Sunwood-ai-labs/NEKOMO/docs/design-change-records.md

# 設計データをリビジョン単位で残す

設計データは `designs/<開発コードネーム>/` の直下に `r00/`、`r01/`、`r02/` のようにリビジョンごとのフォルダで保存する。同じ開発コードネームのリビジョンは共通の親フォルダにまとめる。修正前は前のリビジョン、修正後は新しいリビジョンとして残す。変更時は前の版を上書きせず、新しい版を作る。失敗案や不採用案も保持する。

## フォルダ構成

```text
designs/<開発コードネーム>/
  README.md              リビジョン一覧と現在の採用版
  r00/
    README.md            初版の要求・設計意図・結果
    cad/                 編集可能なCAD
    source/              生成スクリプトとパラメータ
    exports/             STEP・STL
    print/               スライス設定と実G-code入り3MF
    evidence/            画像・断面・解析・検証・実物の記録
    manifest.csv         この版のファイル一覧とSHA-256
  r01/
    README.md            r00で何が起き、なぜ、何を変えたか
    cad/
    source/
    exports/
    print/
    evidence/
    manifest.csv
  r02/
    ...
```

未生成の出力や未実施の検証は、READMEに未生成・未実施と記録する。既存の `candidate-r00/` などリビジョンを表すフォルダは、その名前を維持してよい。既存の版やDR記録を一括で移動・改名せず、開発コードネームのREADMEに各版の所在と前後関係を記録する。新しく作るリビジョンは開発コードネームのフォルダ直下に置く。

## 修正するときの手順

1. 修正元のリビジョンを確定し、CAD・生成条件・関連データが保存されていることを確認する。元データが欠けていれば欠落を記録する。
2. 次の番号のリビジョンフォルダを作り、必要な元データをコピーして新しい版で修正する。前のリビジョンは上書き・削除しない。
3. 新しい版のCAD・生成条件・書き出し・スライスデータを同じリビジョンに保存する。前版の出力を流用した場合は、その版と出典を明記する。
4. 新しい版のREADMEに、発端、変更理由、前版との差分、確認結果、残った問題を記録する。比較画像は前版と同じ視点・縮尺で保存し、比較条件の違いも記す。
5. 保存ファイルの相対パス・リビジョン・SHA-256を `manifest.csv` に記録し、設計のREADMEに新しい版を追記する。参照先と実ファイルを確認してから完了を報告する。

Git履歴に加えて、フォルダから各版のデータと経緯をたどれる状態を保つ。ローカル保存とGitで追跡・共有できる範囲は区別する。外部保存なら取得可能な保存先・版・ハッシュを記録する。再生成した過去版は、再生成日時と条件を明記し、当時保存した実データと区別する。

## 各リビジョンのREADMEのひな形

```markdown
# <開発コードネーム> r01

- 作成日時・記録者:
- 元リビジョンと相対パス:
- 状態（採用・不採用・保留）:
- 関連する要求・不具合・DR記録:

## 何が起きたか

観察した問題、利用者の指摘、要求の変更と、その根拠を記す。
原因は確認済みの事実と仮説を分ける。初版では要求と設計意図を記す。

## なぜ、何を変えたか

修正の目的、この方法を選んだ理由、不採用案を記す。

| 部位・項目 | 前版の値・形状 | この版の値・形状 | 変更理由 | 比較画像・根拠 |
| --- | --- | --- | --- | --- |
| <項目> | <単位を含む> | <単位を含む> | <理由> | <相対パス> |

## この版のデータ

- CAD・生成スクリプト・パラメータ:
- 書き出し・スライス設定・実G-code入り3MF:
- ファイル一覧とSHA-256（manifest.csv）:

## 確認結果と残った問題

- 実行した検証・条件・結果・証拠:
- 実物の結果と対象の印刷ファイル:
- 未生成・未実施・未確認・不合格:
- 残った問題と次の修正事項:
- 採用・不採用・保留の理由:
```

ファイル検査、解析、印刷完了、実物確認は別々に記録する。前版の結果を、新しい版でも確認済みと扱わない。
