Sunwood-ai-labs/NEKOMO/docs/brand/logo-concepts/prompts38-40.md

# ネコと帆船のロゴ案 38〜40

## 38 — Little Cat Captain / ねこ船長
意図: 左の座る猫と右の帆、共通の船体を3つの黒い形でまとめ、猫の尾を船体へつなぐ。

```text
Use case: logo-brand
Asset type: original black-and-white brand logo concept, landscape 3:2.
Primary request: create a compact, friendly but sophisticated mark that clearly combines one cat and one sailboat in one coherent symbol.
Scene/backdrop: pure white, centered composition with broad clear margins.
Subject: one compact rounded black sailboat hull; a single simple triangular black sail to the right; one small seated black cat silhouette on the left. The cat silhouette also reads as the boat's mast/cabin silhouette: tiny head with two unmistakable pointed ears, upright seated body. Its curled tail visually joins the hull. Keep the cat and sailboat instantly readable as one designed mark, not a collage. Generous white negative gaps.
Style/medium: simple flat solid-black logo shapes, vector-friendly edges, minimal original toy brand mark, no existing character or logo imitation.
Composition/framing: mark centered above the wordmark, landscape 3:2, ample white margin.
Text (verbatim), and no other visible text: line 1 exactly "NEKONEKO INDUSTRIES"; line 2 exactly "Wonder to Go", smaller than line 1. Render these two lines centered, clean and legible.
Constraints: use at most three main black forms (cat, one sail, hull). Keep the face blank: no eyes, mouth, whiskers, paws, hat, clothes. No separate mast, ropes, rigging, waves, stars, frame, badge, border, or other icons. Pure black on pure white only.
Avoid: extra words, product name, title, captions, watermark, texture, gradients, shadows, 3D, mockup, illustration scene, collage.
```

## 39 — Cat in the Sail / 帆の中のネコ
意図: 三角帆の中に白い猫頭の抜き形を置き、黒い船体と組み合わせる。

```text
Use case: logo-brand
Asset type: original black-and-white brand logo concept, landscape 3:2.
Primary request: create a sophisticated, warm original mark where a cat is immediately recognized inside the sail of a clear sailboat.
Scene/backdrop: pure white, centered composition with broad clear margins.
Subject: one large bold solid-black triangular sail with a clean white cat-head silhouette cutout inside it. The cutout has two distinct pointed ears and a rounded face contour, with no facial features. Beneath it, one broad rounded solid-black boat hull. The cat exists only as the white cutout inside the sail. Keep sail, cat-head cutout, and hull simple and instantly readable.
Style/medium: minimal flat black logo shapes, vector-friendly edges, original toy brand identity, not imitating any existing logo or character.
Composition/framing: centered mark above the wordmark, landscape 3:2, generous white margin.
Text (verbatim), and no other visible text: line 1 exactly "NEKONEKO INDUSTRIES"; line 2 exactly "Wonder to Go", smaller than line 1. Two centered, clean and legible lines.
Constraints: exactly two large black forms (sail and hull) plus one white cutout. No separate cat outside the sail. No extra mast detail, ropes, rigging, stars, waves, frame, badge, border, or other icons. Pure black on pure white only.
Avoid: extra words, product name, title, captions, watermark, texture, gradients, shadows, 3D, mockup, illustration scene, collage.
```

## 40 — Twin Cat Sails / ふたりのネコの帆
意図: 対面する猫の横顔を左右2枚の帆に見立て、1隻の浅い船体を共有する。

```text
Use case: logo-brand
Asset type: original black-and-white brand logo concept, landscape 3:2.
Primary request: create a minimal sailboat-first mark with two paired cats whose silhouettes also read as two sails, all as one coherent symbol.
Scene/backdrop: pure white, centered composition with broad clear margins.
Subject: one shared shallow, smoothly rounded solid-black boat hull below two simple solid-black cat side-profile silhouettes facing each other. Each cat's broad curved body forms one sail rising from the hull; pointy ears define each upper tip and a subtle profile nose helps each read as a cat. Keep the two profiles balanced around a clear central white gap, and make the sailboat read first, paired cats second. Long curved tails may connect to the hull only if they remain uncluttered.
Style/medium: minimal, friendly, original toy-brand logo, flat solid black shapes with vector-friendly edges, no existing character or logo imitation.
Composition/framing: centered symbol above the wordmark, landscape 3:2, generous white margins.
Text (verbatim), and no other visible text: line 1 exactly "NEKONEKO INDUSTRIES"; line 2 exactly "Wonder to Go", smaller than line 1. Two centered, clean and legible lines.
Constraints: use three main black shapes only: two cat-profile sail shapes and one shared hull. No facial features, eyes, whiskers, paws, ropes, rigging, waves, enclosure, badge, star, or other icons. Pure black on pure white.
Avoid: extra words, product name, title, captions, watermark, texture, gradients, shadows, 3D, mockup, illustration scene, stamp, collage.
```

生成画像の文字確認: 3案とも文字は2行で余分な行はありません。画像の Wonder to Go は末尾の句点が見えないため、生成時の表記差として記録します。
