Sunwood-ai-labs/NEKOMO/docs/brand/logo-concepts/prompts28-30.md

# ロゴ案28〜30

生成方法: 内蔵の画像生成ツールで各案を個別に生成。参照画像は使用していない。

共通意図: NEKONEKO INDUSTRIESが作る、携帯できる子ども向け玩具NEKOMOのロゴ案。車、船、飛行機の3種類を各案の中でそれぞれ認識できるようにする。黒と白だけを使った、簡潔なロゴを提案する。

共通表記: 会社名は `NEKONEKO INDUSTRIES`、ミッションは `Wonder to Go.` と正確に記す。マークを主役にし、会社名をその下、ミッションをさらに小さく配置する。白地の横3:2、広い余白、フラットなロゴ表現。

## 28 Three Windows / みっつの窓

意図: 横長のひとつの黒いタイルに3つの車両を白抜きし、車・船・飛行機を並列に見せる。

最終プロンプト:

```text
Use case: logo-brand
Asset type: original company logo concept, vector-friendly
Primary request: Create concept 28, "Three Windows." Make one compact horizontal solid-black rounded rectangle the only emblem. Divide it into exactly three adjoining panels using exactly two broad white vertical gaps. Carve one bold, simple white vehicle silhouette from each panel: a side-view car with two clearly visible wheels in the left panel, a small boat with a distinct hull and one attached triangular sail in the center panel, and a clearly recognizable airplane with a fuselage, broad wings, and tail in the right panel. Keep the three icons separate, equal in optical weight, and readable at small size. Treat the white cutouts as a playful, sturdy stencil mark, not as interface buttons.
Brand context: NEKONEKO INDUSTRIES makes NEKOMO, portable toys for children. Its mission line is "Wonder to Go." The mark must make car, boat, and airplane recognizable.
Composition: White landscape canvas, 3:2 aspect ratio, generous clear margins. Center the single three-panel black emblem above the exact company name "NEKONEKO INDUSTRIES" in restrained uppercase sans-serif. Put the exact tagline "Wonder to Go." below it in smaller type.
Color and style: Pure solid black #000000 and white #FFFFFF only. Flat professional logo artwork with clean vector-like edges and broad, simple forms.
Constraints: The emblem contains only the one rounded black tile, two broad white dividing gaps, and three white vehicle cutouts. No panel borders, shadows, tiny details, windows, rigging, portholes, waves, extra symbols, or decoration. No additional text, misspellings, color, gradient, texture, 3D, mockup, or watermark. Do not imitate an existing brand.
```

## 29 Play Triangle / 遊びのトライアングル

意図: 枠で囲わず、上の飛行機と下の車・帆船を三角形の配置にまとめる。

最終プロンプト:

```text
Use case: logo-brand
Asset type: original company logo concept, vector-friendly
Primary request: Create concept 29, "Play Triangle." Arrange three simple solid-black vehicle silhouettes in a compact, optically balanced triangular composition with no enclosing triangle: a horizontal airplane at the top with clearly readable fuselage, broad wings, and tail; a rounded side-view car at bottom left with two clearly visible wheels; and a small sailboat at bottom right with a distinct hull and one triangular sail. Leave generous white space between the vehicles so each silhouette remains distinct. Give all three the same playful geometric construction and visual weight so they form one original toy-brand family emblem, not a collage.
Brand context: NEKONEKO INDUSTRIES makes NEKOMO, portable toys for children. Its mission line is "Wonder to Go." The mark must make car, boat, and airplane recognizable.
Composition: White landscape canvas, 3:2 aspect ratio, generous clear margins. Center the unframed three-vehicle mark above the exact company name "NEKONEKO INDUSTRIES" in restrained uppercase sans-serif. Put the exact tagline "Wonder to Go." below it in smaller type.
Color and style: Pure solid black #000000 and white #FFFFFF only. Flat professional logo artwork with clean vector-like edges, broad forms, and clear recognition at small sizes.
Constraints: No enclosing triangle, star, arrow, route, circle, frame, outline, or decoration. No tiny windows, rigging, portholes, waves, or extra details. No additional text, misspellings, color, gradient, shadow, texture, 3D, mockup, or watermark. Do not imitate an existing brand.
```

## 30 One Journey / ひと続きの旅

意図: 太い一本線で車から帆船、飛行機へつなぎ、3つの輪郭をひとつのマークにする。

最終プロンプト:

```text
Use case: logo-brand
Asset type: original company logo concept, vector-friendly
Primary request: Create concept 30, "One Journey." Draw one compact horizontal emblem as a single continuous, bold black monoline that smoothly links three distinct, recognizable vehicle profiles from left to right: a side-view car with two round wheels, a boat with a clearly shaped hull and one attached triangular sail, then an airplane with a readable fuselage, broad wing, and tail, rising slightly toward the right. Let the continuous outline connect the vehicles without turning into a route map; preserve open white space and make the boundaries between car, boat, and airplane unmistakable. Use one consistent thick rounded stroke and only the essential contours, with fewer than ten major strokes or loops.
Brand context: NEKONEKO INDUSTRIES makes NEKOMO, portable toys for children. Its mission line is "Wonder to Go." The mark must make car, boat, and airplane recognizable.
Composition: White landscape canvas, 3:2 aspect ratio, generous clear margins. Center the connected black monoline emblem above the exact company name "NEKONEKO INDUSTRIES" in restrained uppercase sans-serif. Put the exact tagline "Wonder to Go." below it in smaller type.
Color and style: Pure solid black #000000 and white #FFFFFF only. Flat professional logo artwork with clean vector-like edges, balanced proportions, and generous white space.
Constraints: No decorative trails, arrows, stars, dashed lines, extra loops beyond the two necessary car wheels, tiny windows, rigging, portholes, waves, enclosure, or extra details. Keep each vehicle's contour distinct; do not let the airplane read as a sail or the car lose its two wheels. No additional text, misspellings, color, gradient, shadow, texture, 3D, mockup, or watermark. Do not imitate an existing brand.
```
