Sunwood-ai-labs/NEKOMO/docs/brand/logo-concepts/prompts16-17.md

# ロゴ案16〜17の生成プロンプト

各案を独立してbuilt-in image_genで生成。

## 16. Escape Dot / 抜けだす丸

狙い: 小さな驚きが輪の外へ抜け、どこへでも持ち歩ける印象を、輪と点だけで表す。
色: 黒一色、純白背景。

Use case: logo-brand  
Asset type: original minimalist logo proposal, landscape 3:2  
Primary request: Design a bespoke, tiny-size-readable mark made of exactly two elements: one thick, asymmetric open squircle loop, slightly flattened at the left and bottom, with one small diagonal gap at the upper right; and one detached solid round dot just beyond that gap.  
Composition: Center the large mark with generous white margin. Below it, set exactly “NEKONEKO INDUSTRIES” in a restrained sans serif and the smaller exact line “Wonder to Go.”  
Color palette: Flat black on pure white only.  
Avoid: Extra shapes or words, arrow, star, cat, speed lines, location pin, power button, loading-spinner or letter-C appearance, mockup, 3D, shadows, gradients, texture, watermark.

## 17. Skipping Ears / 跳ねる耳

狙い: 跳ねるような遊び心を、短く幅のある猫耳風の二片と、その間の白い切れ込みで表す。
色: 黒一色、純白背景。

Use case: logo-brand  
Asset type: original minimalist logo proposal, landscape 3:2  
Primary request: Design a compact, asymmetrical, custom mark made of exactly two short, broad, rounded triangular black wedges suggesting feline ears. Lift and lean one wedge slightly forward; shape the white notch between them to imply a playful skip. Keep the silhouette soft, precise, and clear at tiny sizes.  
Composition: Center the large mark with generous white margin. Below it, set exactly “NEKONEKO INDUSTRIES” in a restrained sans serif and the smaller exact line “Wonder to Go.”  
Color palette: Flat black on pure white only.  
Avoid: Extra shapes or words, face, eyes, body, tail, long bunny ears, letter, enclosing circle or shield, full mascot, generic chevron, tiny decoration, mockup, 3D, shadows, gradients, texture, watermark.
