Sunwood-ai-labs/NEKOMO/docs/brand/logo-concepts/prompts23-25.md

# 23〜25 船モチーフのロゴ案

生成方法: 内蔵の画像生成ツールで各案を個別に生成。参照画像は使用していない。

共通意図: NEKONEKO INDUSTRIESが作る「どこへでも持ち歩ける子ども向け玩具」を、見てすぐ船と分かる白黒の簡潔な記号で表す。

共通仕様: 横3:2、余白のある白地、黒いマーク、社名 `NEKONEKO INDUSTRIES`、タグライン `Wonder to Go.`。フラットな白黒表現。以前の抽象案16〜20は保留中で、削除していない。

## 23 Little Tug / 小さなタグボート

意図: 丸みのある船体、船室、丸窓だけで、玩具のタグボートを一目で伝える。

最終プロンプト:

```text
Use case: logo-brand
Asset type: original company logo concept, vector-friendly
Primary request: Create concept 23, "Little Tug." Make the central mark an instantly recognizable, squat, chunky toy tugboat in side profile, facing right. Use one broad, gently upturned rounded hull and one simple rounded-rectangle cabin sitting clearly on top of the hull. The cabin has exactly one circular white porthole cutout. Keep the silhouette compact and playful, like a small physical toyboat, not a shipyard emblem.
Brand context: NEKONEKO INDUSTRIES makes portable children's toys. Its mission line is "Wonder to Go." The mark should feel friendly and practical for a toy brand.
Composition: White landscape canvas, 3:2 aspect ratio, generous clear margins. Center one black boat icon above the exact company name "NEKONEKO INDUSTRIES" in restrained uppercase sans-serif. Put the exact tagline "Wonder to Go." below it in smaller type. Keep the icon and text aligned and crisp.
Color and style: Pure solid black #000000 and white #FFFFFF only. Flat professional logo artwork with clean vector-like edges, broad simple forms, strong recognition at small sizes.
Constraints: The icon uses only the hull, cabin, and one white porthole cutout; no more than three large black shapes. No smokestack, smoke, rope, anchor, rigging, face, star, waves, border, or extra details. No additional text, no misspellings, no color, gradient, shadow, texture, 3D, mockup, or watermark. Do not imitate an existing brand.
```

## 24 Wave Sail / 波と帆

意図: 三角帆と、船底から波へつながる一本の曲線だけで、船と進む動きを表す。

最終プロンプト:

```text
Use case: logo-brand
Asset type: original company logo concept, vector-friendly
Primary request: Create concept 24, "Wave Sail." Make the central mark immediately readable as a small sailboat in profile. Use exactly two visual elements: (1) one simple solid triangular sail above the boat and (2) one single bold, smooth, continuous curved black band below it. Shape the band's contour so it clearly forms a shallow boat hull with a gently lifted bow while flowing into one low waterwave; the band must read first as the boat-and-wave base of a sailboat, not as a random swoosh. Keep the sail visibly attached to and rising from the hull area.
Brand context: NEKONEKO INDUSTRIES makes portable children's toys. Its mission line is "Wonder to Go." Give the mark a light feeling of forward motion suitable for a toy brand.
Composition: White landscape canvas, 3:2 aspect ratio, generous clear margins. Center one black sailboat icon above the exact company name "NEKONEKO INDUSTRIES" in restrained uppercase sans-serif. Put the exact tagline "Wonder to Go." below it in smaller type. Keep the icon and text aligned and crisp.
Color and style: Pure solid black #000000 and white #FFFFFF only. Flat professional logo artwork with clean vector-like edges, broad balanced geometry, strong recognition at small sizes.
Constraints: The icon contains only the single triangle and the one continuous curved boat-hull/wave band. No separate wave line, second sail, cat, face, star, anchor, enclosure, decoration, or extra details. No additional text, no misspellings, no color, gradient, shadow, texture, 3D, mockup, or watermark. Do not imitate an existing brand.
```

## 25 Anywhere Boat / 車輪付きの遊び舟

意図: 帆のある小舟を二つの車輪に載せ、陸と水の両方へ進む玩具の記号にする。

最終プロンプト:

```text
Use case: logo-brand
Asset type: original company logo concept, vector-friendly
Primary request: Create concept 25, "Anywhere Boat." Design one unified imaginative toy vehicle that reads immediately as a small boat riding on two large round wheels. Use exactly four main black forms: one broad rounded boat hull, one small simple triangular sail rising from the hull, and two large circular wheels beneath the hull. Show the hull clearly above the wheels, with clean white gaps so the boat and both wheels remain distinct at small size. Keep the proportions compact and playful, like an invented toy symbol for wonder that travels on land and water.
Brand context: NEKONEKO INDUSTRIES makes portable children's toys. Its mission line is "Wonder to Go." The mark combines boat and car in one coherent toy icon.
Composition: White landscape canvas, 3:2 aspect ratio, generous clear margins. Center one black boat-on-wheels icon above the exact company name "NEKONEKO INDUSTRIES" in restrained uppercase sans-serif. Put the exact tagline "Wonder to Go." below it in smaller type. Keep the icon and text aligned and crisp.
Color and style: Pure solid black #000000 and white #FFFFFF only. Flat professional logo artwork with clean vector-like edges, broad rounded forms, strong recognition at small sizes.
Constraints: One cohesive vehicle only: hull, one triangular sail, two wheels. No separate collage, face, stars, waves, arrow, enclosure, engine, ropes, anchor, or other details. No additional text, no misspellings, no color, gradient, shadow, texture, 3D, mockup, or watermark. Do not imply this is an existing manufactured product and do not imitate an existing brand.
```
