Sunwood-ai-labs/NEKOMO/docs/designs/school-bus-v02/版の案内.md

# v02の案内

大型・車体／シャーシ／屋根の3部品

記録の確認日: 2026-11-10。未印刷。実組立・保持力・支持材除去は未確認。

全版の一覧（ローカル保存）

## CADと印刷データ

- [cad/nekomo-school-bus-v02.FCStd](../../../designs/school-bus-v02/cad/nekomo-school-bus-v02.FCStd)
- [print/final-body-sliced.3mf](../../../designs/school-bus-v02/print/final-body-sliced.3mf)
- [print/final-chassis-sliced.3mf](../../../designs/school-bus-v02/print/final-chassis-sliced.3mf)
- [print/final-roof-sliced.3mf](../../../designs/school-bus-v02/print/final-roof-sliced.3mf)

## 人間のレビュー・判断

本人発言と出典の記録（ローカル保存）

- 設計フィードバック。使用できる色を赤白へ訂正。対象・反映先はv02 → v03。根拠はR03。
- 設計フィードバック。サンプル船程度への小型化を提案。対象・反映先はv02 → v03。根拠はR04。

### 前の案への指摘・設計条件の引継ぎ

次の発言を設計入力として保存しています。この版の完成形へのレビュー・承認とは区別します。

- R01。参照写真との外観差を指摘。対象・反映先はv01 → v02。
- R02。参考の設計案を提示。対象・反映先はv02設計条件。

完成品の品質に対する人間のレビューはなしです。

## エージェントのレビュー・検証記録

CAD・組立形状とスライス後の確認。段階別の正式なDR判定表は主要資料で確認できない。

### v02・大型3部品

| DR段階 | 星取 | 元の判定 |
| --- | :---: | --- |
| DR0 要求 | なし | なし |
| DR1 設計 | なし | なし |
| DR2 工程 | なし | なし |
| DR3 現物試験 | なし | なし |
| DR4 使用判定 | なし | なし |

実施した検査は次のとおりです。

- 車体・シャーシ・屋根の形状、干渉と位置決めを確認。
- 各部品の姿勢・支持材・スライスを比較し、保存した印刷ファイルを検査。
- 固定輪まわりの支持材除去を現物の確認課題として記録。

### 関連する検証・実機記録

- [README.md](README.md)
- assembly-and-fit.md（ローカル保存）
- [evidence/after-slice-review.md](evidence/after-slice-review.md)

## 配布物

- 当時の配布ZIP（ローカル保存）

配布ZIPは整理前の内容を保持しています。ZIP内のhandoffやハッシュは、その配布時点のファイルに対応します。

## 保存場所の扱い

このフォルダがこの版の保存場所です。旧候補、失敗記録、DR前後の証跡は元の場所に残しています。
案内にある印刷データには未印刷のものも含まれます。データ審査と現物試験の結果は各記録で区別しています。
