Sunwood-ai-labs/NEKOMO/docs/designs/school-bus-v03-mini/版の案内.md

# v03の案内

60mm級・赤白の3部品

記録の確認日: 2026-11-10。未印刷。DR0・DR1は一部実施、DR2はデータ確認、DR3・DR4は未実施。

全版の一覧（ローカル保存）

## CADと印刷データ

- [cad/nekomo-school-bus-v03.FCStd](../../../designs/school-bus-v03-mini/cad/nekomo-school-bus-v03.FCStd)
- [print/final-body-sliced.3mf](../../../designs/school-bus-v03-mini/print/final-body-sliced.3mf)
- [print/final-chassis-sliced.3mf](../../../designs/school-bus-v03-mini/print/final-chassis-sliced.3mf)
- [print/final-roof-sliced.3mf](../../../designs/school-bus-v03-mini/print/final-roof-sliced.3mf)

## 人間のレビュー・判断

本人発言と出典の記録（ローカル保存）

- 設計への肯定的反応・工程確認。v03提示への肯定的反応と工程確認。対象・反映先はv03提示の直後。根拠はR11。

### 前の案への指摘・設計条件の引継ぎ

次の発言を設計入力として保存しています。この版の完成形へのレビュー・承認とは区別します。

- R03。使用できる色を赤白へ訂正。対象・反映先はv02 → v03。
- R04。サンプル船程度への小型化を提案。対象・反映先はv02 → v03。

### エージェントへの作業依頼

本人がDRを実施したという意味ではありません。

- Q04。DR実施依頼。

完成品の品質に対する人間のレビューはなしです。

## エージェントのレビュー・検証記録

DR0・DR1は一部実施、DR2はデータ上の確認。DR0〜2の完了・合格判定はなく、DR3・DR4は未実施。

### v03・60mm組立

| DR段階 | 星取 | 元の判定 |
| --- | :---: | --- |
| DR0 要求 | △ | 一部 |
| DR1 設計 | △ | 一部 |
| DR2 工程 | △ | データ確認 |
| DR3 現物試験 | なし | なし |
| DR4 使用判定 | なし | なし |

実施した検査は次のとおりです。

- 赤白・60mm・固定輪の要求を反映。外観と位置決め部の肉厚を調整。
- 3部品の再読込・干渉、STEPとSTLの形状を確認。
- 支持材と材料割当、スライスとG-codeを確認。DR0〜2の完了・合格判定はなし。

### 関連する検証・実機記録

- [README.md](README.md)
- dr-status.md（ローカル保存）
- assembly-and-fit.md（ローカル保存）
- [evidence/after-slice-review.md](evidence/after-slice-review.md)

## 配布物

- 当時の配布ZIP（ローカル保存）

配布ZIPは整理前の内容を保持しています。ZIP内のhandoffやハッシュは、その配布時点のファイルに対応します。

## 保存場所の扱い

このフォルダがこの版の保存場所です。旧候補、失敗記録、DR前後の証跡は元の場所に残しています。
案内にある印刷データには未印刷のものも含まれます。データ審査と現物試験の結果は各記録で区別しています。
