Sunwood-ai-labs/NEKOMO/docs/designs/school-bus-v04-dr/版の案内.md

# v04の案内

60mm級・幅34mm・赤白一体構造

記録の確認日: 2026-11-10。未印刷。DR0を審査、DR1・DR2は条件付き。DR3・DR4は未実施。整理前からCADと再読込記録のハッシュが一致せず、再梱包は停止。

全版の一覧（ローカル保存）

## CADと印刷データ

- [cad/nekomo-school-bus-v04.FCStd](../../../designs/school-bus-v04-dr/cad/nekomo-school-bus-v04.FCStd)
- [print/final-bus-sliced.3mf](../../../designs/school-bus-v04-dr/print/final-bus-sliced.3mf)

## 人間のレビュー・判断

本人発言と出典の記録（ローカル保存）

- 設計フィードバック。製造可能性と内部空間を質問。対象・反映先はv04 → 未確認。根拠はR05。

完成品の品質に対する人間のレビューはなしです。

## エージェントのレビュー・検証記録

DR0の要求・試験計画を確認。DR1・DR2は成人評価用試作に限る条件付き判定。DR3・DR4は未実施。既存のCADハッシュ不一致も残る。

### v04・60mm一体

| DR段階 | 星取 | 元の判定 |
| --- | :---: | --- |
| DR0 要求 | ○ | 審査済み |
| DR1 設計 | △ | 条件付き |
| DR2 工程 | △ | 条件付き |
| DR3 現物試験 | なし | なし |
| DR4 使用判定 | なし | なし |

実施した検査は次のとおりです。

- 要求仕様、設計FMEA16項目、工程FMEA12項目、試験計画を整理・審査。
- 別体の屋根・底板を一体化し、幅と補強部を見直す。CAD・メッシュ・色領域を確認。
- 材料割当・支持材除去計画・スライスと出力経路を確認。
- 整理時の再照合では保存CADのハッシュ不一致が残る。現在の再梱包は停止。

追加の根拠となる記録です。

- packaging-verification.json（ローカル保存）

### 関連する検証・実機記録

- [README.md](README.md)
- [quality/preprint-review/dr-review.md](quality/preprint-review/dr-review.md)
- [quality/preprint-review/requirements.md](quality/preprint-review/requirements.md)
- [quality/preprint-review/test-plan.md](quality/preprint-review/test-plan.md)
- [evidence/after-slice-review.md](evidence/after-slice-review.md)

## 配布物

- 当時の配布ZIP（ローカル保存）

配布ZIPは整理前の内容を保持しています。ZIP内のhandoffやハッシュは、その配布時点のファイルに対応します。

## 保存場所の扱い

このフォルダがこの版の保存場所です。旧候補、失敗記録、DR前後の証跡は元の場所に残しています。
案内にある印刷データには未印刷のものも含まれます。データ審査と現物試験の結果は各記録で区別しています。
