Sunwood-ai-labs/NEKOMO/docs/designs/school-bus-v06-empty-inverted/版の案内.md

# v06・60mm空洞の案内

床・座席を抜く60mm級。単色、赤屋根、赤タイヤの派生

記録の確認日: 2026-11-10。単色・赤屋根版はスライス比較まで。赤タイヤ版は本人報告で印刷済み。

全版の一覧（ローカル保存）

## CADと印刷データ

- corrected/nekomo-v06-clear-cabin.FCStd（ローカル保存）
- [print/clear-inverted-normal-support-sliced.3mf](../../../designs/school-bus-v06-empty-inverted/print/clear-inverted-normal-support-sliced.3mf)
- two-color/nekomo-v06-red-white.FCStd（ローカル保存）
- two-color/red-white-inverted-sliced.3mf（ローカル保存）
- two-color-red-tyres/nekomo-v06-red-tyres.FCStd（ローカル保存）
- two-color-red-tyres/red-tyres-inverted-sliced.3mf（ローカル保存）

## 人間のレビュー・判断

本人発言と出典の記録（ローカル保存）

- 設計フィードバック。タイヤの色違いを要望。対象・反映先はv06 → 赤タイヤ派生版。根拠はR09。
- 採用承認・印刷指示。赤タイヤ版を採用して印刷を指示。対象・反映先はv06赤タイヤ派生版。根拠はR10。

### 前の案への指摘・設計条件の引継ぎ

次の発言を設計入力として保存しています。この版の完成形へのレビュー・承認とは区別します。

- R07。床なし・空洞・逆さ印刷を提案。対象・反映先はv05 → v06。
- R08。2色を指定。対象・反映先はv05 → v06。
- R09。タイヤの色違いを要望。対象・反映先はv06 → 赤タイヤ派生版。

### 印刷実績

本人の印刷報告（ローカル保存）

- v06・赤タイヤは印刷済み。根拠は本人報告U01。

完成品の品質に対する人間のレビューはなしです。

## エージェントのレビュー・検証記録

CADと姿勢・支持材・配色のスライス比較。正式な全DRの完了記録とは区別する。赤タイヤ版のジョブ開始は機械記録で確認する。

### v06・60mm空洞

| DR段階 | 星取 | 元の判定 |
| --- | :---: | --- |
| DR0 要求 | なし | なし |
| DR1 設計 | なし | なし |
| DR2 工程 | なし | なし |
| DR3 現物試験 | なし | なし |
| DR4 使用判定 | なし | なし |

実施した検査は次のとおりです。

- 床・座席を抜いた形状と空洞を確認。
- 正立・逆さ、支持材なし・tree・normalをスライス比較。
- 赤屋根・白車体の2色案について、色替え・時間・支持材とG-codeを確認。

### v06・赤タイヤ

| DR段階 | 星取 | 元の判定 |
| --- | :---: | --- |
| DR0 要求 | なし | なし |
| DR1 設計 | なし | なし |
| DR2 工程 | なし | なし |
| DR3 現物試験 | なし | なし |
| DR4 使用判定 | なし | なし |

実施した検査は次のとおりです。

- 赤い屋根・タイヤと白い車体・ハブの色分けを確認。
- 逆さ姿勢・通常支持材のスライス、色替え40回・予測時間・材料量を確認。
- 印刷ファイル・G-codeとAMS割当を確認。印刷済みは本人報告で記録し、現物試験の合格とは区別。

### 関連する検証・実機記録

- 比較結果.md（ローカル保存）
- [evidence/after-slice-review.md](evidence/after-slice-review.md)
- [two-color-red-tyres/README.md](two-color-red-tyres/README.md)
- [two-color-red-tyres/after-slice-review.md](two-color-red-tyres/after-slice-review.md)
- two-color-red-tyres/print-run-20261110/README.md（ローカル保存）
- two-color-red-tyres/印刷実績-本人報告.json（ローカル保存）

## 保存場所の扱い

このフォルダがこの版の保存場所です。旧候補、失敗記録、DR前後の証跡は元の場所に残しています。
案内にある印刷データには未印刷のものも含まれます。データ審査と現物試験の結果は各記録で区別しています。
