Sunwood-ai-labs/NEKOMO/docs/designs/school-bus-v06-simple/版の案内.md

# v06・小型一体の案内

40×20×22mm・単色・車内空間なし

記録の確認日: 2026-11-10。未印刷。DR0〜2はデータ審査、DR3はNOT_RUN、DR4はHOLD。

全版の一覧（ローカル保存）

## CADと印刷データ

- [candidate-r01/cad/final-bus-r01.FCStd](../../../designs/school-bus-v06-simple/candidate-r01/cad/final-bus-r01.FCStd)
- [candidate-r01/print/school-bus-r01-sliced.3mf](../../../designs/school-bus-v06-simple/candidate-r01/print/school-bus-r01-sliced.3mf)

## 人間のレビュー・判断

本人発言と出典の記録（ローカル保存）

- 設計への指摘・変更要望。いや、バスをシンプルにしてってこと！。対象・反映先はv06-simple。根拠はS04。

### 前の案への指摘・設計条件の引継ぎ

次の発言を設計入力として保存しています。この版の完成形へのレビュー・承認とは区別します。

- S01。小型・簡素化と1時間以内を要望。対象・反映先はv06-simple。

完成品の品質に対する人間のレビューはなしです。

## エージェントのレビュー・検証記録

DR0〜2の要求・形状・印刷データを確認。DR3はNOT_RUN、DR4はHOLD。

### v06・40mmシンプル

| DR段階 | 星取 | 元の判定 |
| --- | :---: | --- |
| DR0 要求 | ○ | 審査済み |
| DR1 設計 | △ | データ確認 |
| DR2 工程 | △ | データ確認 |
| DR3 現物試験 | なし | なし |
| DR4 使用判定 | 保留 | 保留 |

実施した検査は次のとおりです。

- 小型・単色・一体の要求を確認し、DR前後のデータを保存。
- r00・r01のソース、CAD・STEP・STLの再読込と代表断面を確認。前面・窓位置を修正。
- 3MFの材料・設定・G-code・時間を確認。予測27分6秒、支持材・色替え・警告なし。

追加の根拠となる記録です。

- [DR1-r00-findings.md](evidence/DR1-r00-findings.md)

### 関連する検証・実機記録

- [quality/preprint-review/dr-review.md](quality/preprint-review/dr-review.md)
- [evidence/after-slice-review.md](evidence/after-slice-review.md)
- evidence/DR3-decision.md（ローカル保存）
- evidence/DR4-decision.md（ローカル保存）
- reviews（ローカル保存）

## 保存場所の扱い

このフォルダがこの版の保存場所です。旧候補、失敗記録、DR前後の証跡は元の場所に残しています。
案内にある印刷データには未印刷のものも含まれます。データ審査と現物試験の結果は各記録で区別しています。
