Sunwood-ai-labs/NEKOMO/docs/designs/school-bus-v07-open-bottom/版の案内.md

# v07の案内

40mm級・床なし空洞・赤白・立体固定輪

記録の確認日: 2026-11-10。未印刷。DR0〜2はデータ審査、DR3はNOT_RUN、DR4はHOLD。

全版の一覧（ローカル保存）

## CADと印刷データ

- [candidate-r00/cad/nekomo-bus-v07-final.FCStd](../../../designs/school-bus-v07-open-bottom/candidate-r00/cad/nekomo-bus-v07-final.FCStd)
- [candidate-r00/print/bus-two-colour-final.3mf](../../../designs/school-bus-v07-open-bottom/candidate-r00/print/bus-two-colour-final.3mf)

## 人間のレビュー・判断

本人発言と出典の記録（ローカル保存）

- 設計への指摘・変更要望。床もなしでいいよ！。対象・反映先はv07。根拠はS05。
- 設計への指摘・変更要望。上下逆にして、中身空洞にしたら？？船を参考にして！。対象・反映先はv07。根拠はS06。

### エージェントへの作業依頼

本人がDRを実施したという意味ではありません。

- S08。DRの前とあとはちゃんとデータ残してね。
- S09。これで、freecadで設計してみて！。

完成品の品質に対する人間のレビューはなしです。

## エージェントのレビュー・検証記録

DR0〜2の要求・形状・印刷データを確認。DR3はNOT_RUN、DR4はHOLD。

### v07・40mm床なし

| DR段階 | 星取 | 元の判定 |
| --- | :---: | --- |
| DR0 要求 | ○ | 審査済み |
| DR1 設計 | △ | データ確認 |
| DR2 工程 | △ | データ確認 |
| DR3 現物試験 | なし | なし |
| DR4 使用判定 | 保留 | 保留 |

実施した検査は次のとおりです。

- 床なし・中空・逆さ・2色・固定輪の要求を審査し、DR前後を保存。
- 窓の切り抜きと輪の張り出しを修正。CAD・STEP・STL、局所厚さ、色境界と空洞を確認。
- タワー位置の失敗を修正して再スライス。G-codeで空洞中央を横切る押出がないことなどを確認。予測28分41秒、色替え1回、支持材なし。

### 関連する検証・実機記録

- [README.md](README.md)
- quality/dr-review-r01.md（ローカル保存）
- quality/fmea-and-test-plan-r00.md（ローカル保存）
- [evidence/design-review-r00.md](evidence/design-review-r00.md)
- reviews（ローカル保存）

## 配布物

- 当時の配布ZIP（ローカル保存）

配布ZIPは整理前の内容を保持しています。ZIP内のhandoffやハッシュは、その配布時点のファイルに対応します。

## 保存場所の扱い

このフォルダがこの版の保存場所です。旧候補、失敗記録、DR前後の証跡は元の場所に残しています。
案内にある印刷データには未印刷のものも含まれます。データ審査と現物試験の結果は各記録で区別しています。
