Sunwood-ai-labs/NEKOMO/docs/designs/school-bus-v08-photo/版の案内.md

# v08の案内

42×21×24mm・参照写真に寄せたボンネット付き

記録の確認日: 2026-11-10。白タイヤと赤タイヤを比較。未印刷。全DRの再実施はしていない。

全版の一覧（ローカル保存）

## CADと印刷データ

- [cad/photo-bus.FCStd](../../../designs/school-bus-v08-photo/cad/photo-bus.FCStd)
- [exports/photo-two-color-sliced.3mf](../../../designs/school-bus-v08-photo/exports/photo-two-color-sliced.3mf)
- [cad/photo-bus-fast.FCStd](../../../designs/school-bus-v08-photo/cad/photo-bus-fast.FCStd)
- [exports/fast-two-color-sliced.3mf](../../../designs/school-bus-v08-photo/exports/fast-two-color-sliced.3mf)

## 人間のレビュー・判断

本人発言と出典の記録（ローカル保存）

- 設計レビューの質問。逆さ印刷とボンネットの支持材を質問。対象・反映先はv08 → v09。根拠はP02。
- 設計変更の提案と意図の訂正。ボンネット全体を滑らかな傾斜にするよう提案。対象・反映先はv08 → v09。根拠はP03。

完成品の品質に対する人間のレビューはなしです。

## エージェントのレビュー・検証記録

形状・配色・スライス・ボンネットの確認。全DRの再実施はしていない。

### v08・写真型

| DR段階 | 星取 | 元の判定 |
| --- | :---: | --- |
| DR0 要求 | なし | なし |
| DR1 設計 | なし | なし |
| DR2 工程 | なし | なし |
| DR3 現物試験 | なし | なし |
| DR4 使用判定 | なし | なし |

実施した検査は次のとおりです。

- CAD再読込、単一ソリッド、床開口、色領域の重複と欠落を確認。
- 白タイヤと赤タイヤの配色をスライス比較し、色替え・時間・材料量を確認。
- 逆さ印刷でボンネットが空中から始まる問題を確認。全DRの再実施はなし。

### 関連する検証・実機記録

- [README.md](README.md)
- evidence/bonnet-review.json（ローカル保存）

## 保存場所の扱い

このフォルダがこの版の保存場所です。旧候補、失敗記録、DR前後の証跡は元の場所に残しています。
案内にある印刷データには未印刷のものも含まれます。データ審査と現物試験の結果は各記録で区別しています。
