Sunwood-ai-labs/NEKOMO/docs/designs/school-bus-v09-sloped/版の案内.md

# v09の案内

42×21×24mm・支持材なしを狙う傾斜ボンネット

記録の確認日: 2026-11-10。実機記録はFINISH・100%・119層完了。取り外し後の仕上がりと強度は未確認。

全版の一覧（ローカル保存）

## CADと印刷データ

- [cad/sloped-bus.FCStd](../../../designs/school-bus-v09-sloped/cad/sloped-bus.FCStd)
- [cad/sloped-bus-print.FCStd](../../../designs/school-bus-v09-sloped/cad/sloped-bus-print.FCStd)
- [exports/sloped-two-color-sliced.3mf](../../../designs/school-bus-v09-sloped/exports/sloped-two-color-sliced.3mf)

## 人間のレビュー・判断

本人発言と出典の記録（ローカル保存）

- 試し刷りの指示。v09の試し刷りを指示。対象・反映先はv09-sloped。根拠はP05。

### 前の案への指摘・設計条件の引継ぎ

次の発言を設計入力として保存しています。この版の完成形へのレビュー・承認とは区別します。

- P03。ボンネット全体を滑らかな傾斜にするよう提案。対象・反映先はv08 → v09。

### エージェントへの作業依頼

本人がDRを実施したという意味ではありません。

- P04。支持材なしで成立するか検証を要求。

### 印刷実績

本人の印刷報告（ローカル保存）

- v09・傾斜ボンネットは印刷済み。根拠は本人報告U01。

完成品の品質に対する人間のレビューはなしです。

## エージェントのレビュー・検証記録

ボンネット断面とG-codeの前層との重なりを確認。選定した範囲の検証であり、印刷完了や全体の現物品質合格とは区別する。

### v09・傾斜ボンネット

| DR段階 | 星取 | 元の判定 |
| --- | :---: | --- |
| DR0 要求 | なし | なし |
| DR1 設計 | なし | なし |
| DR2 工程 | なし | なし |
| DR3 現物試験 | なし | なし |
| DR4 使用判定 | なし | なし |

実施した検査は次のとおりです。

- 傾斜ボンネットへ変更し、保存CADの再読込と床開口を確認。
- CADの層ごとの断面と、実G-codeの押出線幅を用いて前層との重なりを確認。検査範囲はボンネット中央の抽出点。
- 保存3MFの設定・警告・支持材・色替えを確認。実機のFINISH・100%・119層完了も記録。寸法・強度などの現物試験の合格記録はなし。

追加の根拠となる記録です。

- toolpath-overlap.json（ローカル保存）

### 関連する検証・実機記録

- [README.md](README.md)
- timelapse/recording.json（ローカル保存）
- evidence/completion-answer.md（ローカル保存）
- evidence/progress-final.jpg（ローカル保存）
- timelapse/timelapse.mp4（ローカル保存）

## 保存場所の扱い

このフォルダがこの版の保存場所です。旧候補、失敗記録、DR前後の証跡は元の場所に残しています。
案内にある印刷データには未印刷のものも含まれます。データ審査と現物試験の結果は各記録で区別しています。
