Sunwood-ai-labs/NEKOMO/docs/designs/school-bus-v02/evidence/after-slice-review.md

# スライス後レビュー

判定: 固定車輪周辺のサポート除去性を要確認。

最終3MFのG-codeを各ZIP内で解析。PLA-Sはbody T3、chassis T2、roof T1で、全て要望内容要望内容ラベルのみ。モデルfeatureラベルのG0/G1移動は0件。集計値はfeatureラベルごとの移動回数。

全ファイルで`support_top_z_distance=0`、界面は3層。造形面に接触するため、除去性と仕上がりは未確認。chassis側向きは直立候補より、見積り時間が5,135秒、材料が16.42g、サポートfeature時間が1,995秒少ない。固定車輪やアーチ周辺の工具アクセスは確定できない。

3部品の合計スライサー見積りは31時間16分10秒、材料602.71g。実造形、適合、強度、ブリッジ品質は未確認。印刷指示はしていない。
