Sunwood-ai-labs/NEKOMO/docs/designs/school-bus-v03-mini/evidence/after-slice-review.md

# 赤白スクールバスのスライス後レビュー

判定：成人向け試作として印刷し、実物評価へ進める。実印刷と安全性は未評価。3歳未満向けは未承認。

外形は60×31.824×35.568 mm。ボディ、シャシー、ルーフは各1個の有効な閉じたソリッドで、干渉はない。G-code上、GFS02（PLA-S）のモデル特徴移動は0回で、支持界面とプライムタワーだけに使う。上面Z距離0 mm、界面3層のため支持面に接触する。除去性と表面品質は実物未評価。3部品の合計見積もりは7時間25分33秒、113.94 g（支持材・パージ込み）。印刷は未実施。
