Sunwood-ai-labs/NEKOMO/docs/designs/school-bus-v04-dr/evidence/after-slice-review.md

# スライス後レビュー

## 判定

最終3MFのファイル審査は、成人向けエンジニアリング試作品用データとして条件付き合格とする。これはプリンター送信や造形の許可ではない。R-06に従い、送信・造形は行っていない。子どもへの引き渡しは認めない。

## 確認結果

対象は `print/final-bus-sliced.3mf` で、SHA-256は `091ca2dc03d3282b376b05e8730e346c1cca4a7eb72a385b7f3b5304bd830921`。実ファイルのハッシュはファイル検査票と一致する。検査票（ローカル保存）

屋根・車体・床を含む最終CADとSTEPは、有効な閉じた1ソリッドとして再読込された。寸法は約60.000 × 34.000 × 35.568 mmで、外部文書参照はない。再読込記録（ローカル保存）

Bambu Studioのスライスは1プレートで、警告はなかった。178層、層高0.2 mm、壁5周、充填率25%だった。造形時間31,354.265625秒と材料130.445260 gは予測値で、フィラメント切替は158回と記録された。いずれも造形実績ではない。スライス記録（ローカル保存）

G-codeでは、白PLAのT0に本体と支持材、赤PLAのT1に本体、PLA-SのT2に支持界面とプライムタワーを割り当てていた。T2のモデル形状に対する移動は0回である。木状支持材はモデル形状に含まれない。経路集計（ローカル保存）

支持の上面距離は0 mmで、上面界面は3層ある。支持材は接触面まで届く設定だが、屋根下・客室へのアクセス、除去性、残材、除去後の表面は現物で確認していないためPENDINGとする。

最終STLの凸包内接球は33.399924 mmで、内部33.0 mmスクリーニングを通る。この値は物理ゲージ試験の結果ではない。Hull記録（ローカル保存）

赤白領域の集合差は0.0 mm³、重なりは0.0 mm³だった。体積合計差2.748561 mm³は報告書の0.05 mm³体積合計基準を超えるため、B-spline体積積分の診断値として残す。最終確認では集合差と重なりを判定に使い、デジタル確認48項目はすべて合格した。形状記録（ローカル保存） 確認記録（ローカル保存）

## 未確認事項

支持材のアクセスと除去、積層・色境界の実強度、現物の円筒ゲージ試験、赤白材料の品番・ロット、化学・清掃・燃焼性の評価は未実施である。これらが解決するまで子どもへの使用を承認しない。[試験計画](../quality/preprint-review/test-plan.md)
