Sunwood-ai-labs/NEKOMO/docs/designs/school-bus-v06-empty-inverted/evidence/after-slice-review.md

# v06 clear-cabin スライス後レビュー

## 判定

単色比較で警告が出なかった **clear-cabin-inverted + PLA normal(auto) support**を現物試作候補にしました。反転時は屋根面が広くベッドに接します。ユーザー指定の赤屋根・白車体を適用した最終2色スライスは後段に記録しています。サポートが容易に外れることや、実物の接着・強度を保証する結果ではありません。

正立は警告なしで速い一方、STL上のベッド接触は4輪の小さな接触面だけで、屋根には23.08 mm幅の空洞が残ります。初層の接着と屋根ブリッジの両方を実物で確かめる必要があります。したがって、スライス時間だけで正立を優先しません。

## 比較した実スライス

全条件は白PLA、0.25 mm層高、2壁、充填率10%、各1回のスライスです。表の時間と材料は予測値で、印刷実績ではありません。

| 条件 | 予測時間 / 材料 | スライサー警告 | 判定材料 |
|---|---:|---|---|
| clear 正立・無サポート | 52分24秒 / 15.832 g | なし | STL床面は4輪に分かれ、平坦な接触三角形の合計面積は5.24 mm²。 |
| clear 反転・無サポート | 51分13秒 / 15.433 g | 浮遊領域 | 屋根側の平坦な接触三角形は657.08 mm²。面積は広いが、警告が残る。 |
| clear 反転・PLA tree support | 64分35秒 / 18.092 g | 未支持領域2か所 | 支持を追加しても警告が残る。 |
| clear 反転・PLA normal(auto) support | 71分43秒 / 23.282 g | なし | 現在の警告なし反転条件。支持除去のしやすさは未確認。 |

接触三角形の面積は、STLの最小Zから0.04 mm以内に全頂点がある三角形を抽出し、面積を合計しました。正立では4輪の接触パッチに分かれます。スライス3MFの `Metadata/plate_1.json` にある初層面積は正立16.39 mm²、反転815.07 mm²です。STL三角形面積とスライサー初層面積は計算法が異なるため、別々の指標として記録します。

## サポートと屋根ブリッジ

normal(auto) のG-codeには通常サポート12,235区間、約50.2 m、界面4,085区間、約14.0 m、遷移サポート1,397区間、約2.56 mがありました。通常サポートのベッドXY範囲は56.54–123.46 × 70.87–109.13 mm、界面は58.47–121.53 × 72.80–107.20 mmで、Z=0.25–27.25 mmに配置されます。G-code座標を3MF配置で戻し、空洞のXY投影と照合したところ、サポート長の約13.2%、界面長の約14.2%が空洞投影内にあります。この条件は白PLAの同材サポートで、上部Z間隔0.2 mm、界面間隔0.5 mm、上部界面3層です。この投影判定では工具の直線到達、支持材の分離、除去性は確認できません。

正立G-codeでは要望内容区分が524.20秒あり、最上部付近のZ=34.75 mm層にもブリッジ経路があります。経路長だけでは実際の自由スパンやブリッジ品質を確定できません。屋根幅の短いクーポンで先に確かめるのが妥当です。

tree support条件の要望内容は、保存されたスライスJSONに個数のみがあり、3MFにも位置座標や領域IDは見つかりませんでした。該当箇所を特定したとは扱いません。

## 証拠と範囲

- 対象形状: `corrected/clear-cabin-upright.stl` SHA-256 `25d6722485446acd35f1b5b3dfdd56bb63e52243a1792b8dce607423c351a356`、`corrected/clear-cabin-inverted.stl` SHA-256 `67666d52b12cbea3ec024e9d006a1bb0a39ce5db83b23706ee79962598a502b1`。
- 実際のツールパスと警告: `print/clear-upright-sliced.3mf`、`print/clear-inverted-sliced.3mf`、`print/clear-inverted-pla-support-sliced.3mf`、`print/clear-inverted-normal-support-sliced.3mf` と対応する `evidence/slice-clear-*.json`。
- `empty-*` STL/スライスは座席残存版として比較対象から除外しました。
- 各条件のスライスは1回です。実印刷、接着、ブリッジ形状、支持材の除去、車体の強度、子どもの使用安全性は検証していません。

## 2色指定の反転スライス

最終の色指定（赤い屋根、白い車体と固定輪）を反映した `two-color/red-white-inverted-sliced.3mf` も確認しました。予測は74分42秒、合計24.1729 g、材料切替1回で、スライサー警告はありません。赤PLAは合計6.1618 g、白PLAは18.0111 gです。両方ともPLAで、専用サポート材は使いません。

形状検査では屋根/車体の境界は組立Z=31.075 mm、色領域の重複・欠落・余分な体積はそれぞれ0 mm³です。合計体積20,457.7677 mm³はclear-cabin単色形状と一致します。3MFのパーツ割当は赤い屋根がslot 0、白い車体/固定輪がslot 1。G-codeもslot 0（赤）からslot 1（白）へ1回だけ切り替えています。反転時の色境界は印刷Z約4.493 mmに当たり、G-codeは0.25 mm層のZ=4.75 mmで白へ切り替えます。

サポートと界面の割当はどちらも `support_filament=0` ですが、G-code上では屋根側の支持材が赤slot 0（Z=0.25–4.5 mm）、車体側が白slot 1（Z=4.75–27.25 mm）で出力されます。支持材はモデルと同じ色のPLAで、支持材だけ別素材に分けた結果ではありません。サポート除去、取り外しやすさ、実物の接着・強度は未確認です。

このファイルは保存済みスライスを内容確認しただけで、プリンターへ送信していません。3MF SHA-256: `5dade7106499109618c6480c22eb60fa7084710d8dca1de80d03d5e104501532`。
