Sunwood-ai-labs/NEKOMO/docs/designs/school-bus-v06-simple/evidence/after-slice-review.md

# v06 r01のスライス後レビュー

判定: 成人による造形評価用の候補として維持。印刷は未実施。後続のユーザー指示による床なし中空2色版はv07に分離する。

最終入力はcandidate-r01/exports/school-bus-r01.stlとfinal-profile-r01.json。最終3MFのSHA-256はbf89c88cf0c595884269e19fa72f046ac1cf2b403c5aee0f23116c543841c490。再読込CADは40×20×22 mm、valid/closed/1solid/1shell。色付き表示用final-bus-r01.FCStdも再読込し同体積を確認した。

スライサーreturn_code0、警告なし、110層、0.20 mm、3壁、15%gyroid、単色赤PLA、支持なし、色替え0。予測全体1625.603秒（約27分6秒）、材料8.168 g。造形本体部分1225.920秒と全体予測を二重加算しない。冷却と取り外し15分は計画予算で実測ではなく、全体約42分6秒の計画となる。

実G-codeにSupportタグはない。Floating vertical shellタグは輪凹み上などの内部壁付近、BridgeタグはZ21.2の内部充填上の屋根部分にある。タグだけで空中島または造形成功と判断しない。CADの代表高さ11か所では断面は各1ソリッドだった。内部充填上面の品質と浅い凹みの再現は現物で確認する。

DR1はソース確認で失敗証拠保持・別版出力・isClosedの実測を修正。CAD r00の前面が低かったためr01で高くし、前窓も上げた。r00のCADとスライス、r01のCADとスライスを保存した。現物の強度・時間・外観・使用適合は未確認。
