Sunwood-ai-labs/NEKOMO/docs/designs/school-bus-v06-simple/evidence/DR1-r00-findings.md

# DR1 初回CAD r00の形状レビュー

r00をFreeCADで生成し、保存済みFCStdをGUIで開いた。外形40×20×22 mm、valid/closed/1solid/1shellを確認。候補のCAD/STL/STEP/ソースはreviews/DR1/before/candidate-r00へコピーして固定した。

指摘D1: 前側の斜め屋根がX=0〜約12 mmに及び、前面高さは約11.24 mmしかない。小さいバスとしての見た目を保つため、前面を高くし、前窓も上へ移す。新候補r01はroof_front_x=4 mm、前窓Z=12〜18 mmとする。車内空間や別部品は追加しない。

指摘D2: Fillet入力7辺のうち6辺に対してカーネルが接線連続のためskipした。reportのedge_countは適用辺数と誤解しうるため、requested_edge_countへ改める。最終形状のvalidをもって全7辺へRが付いたと主張しない。

r00スライスは正常終了、警告なし、110層、単色PLA、支持材なし、色替え0。全体予測1576.734秒、材料7.774 g。これは初回候補の値でありr01へ流用しない。

判定: r00は製造候補として成立の見込みがあるが、バスらしい形を保つためr01へ改訂し、CAD再読込とスライスを再実施する。
