Sunwood-ai-labs/NEKOMO/docs/designs/school-bus-v07-open-bottom/evidence/design-review-r00.md

# v07 r00 製造レビュー

## 判定

r00はCAD形状とスライス候補として維持できます。最終r03画像では前窓、側窓、赤白の境界、立体輪が確認でき、重大な外観欠陥は見えません。床側の開口も保たれています。スライス予測は約28分41秒で、45分の印刷目標内です。実印刷と冷却・取り外しを含む60分目標は未確認です。

## 案の比較

| 案 | 製造上の利点 | 主な負担 | 判断 |
|---|---|---|---|
| 屋根下・一体シェル | 開口が上を向き、空洞へアクセスできる。水平な色境界を印刷高さの境界に置ける。 | 屋根の接地面、輪の立ち上がり、窓の橋、1.6 mm壁の実効幅を確認する必要がある。 | 第一候補。 |
| 側面下・一体シェル | 側面をベッドへ広く接地できる。 | 開口が横を向く。下側の輪レリーフがベッドで平らになり、色境界も高さ方向へ延びるため、層ごとの色替えが増える可能性がある。 | 第一候補にしない。 |
| 白い上部と赤い下部を別体化 | 単色部品を別々に印刷すれば、同じノズルの色替えを減らせる可能性がある。 | 接合、位置合わせ、接着または嵌合が要る。追加プレートと手作業が、1時間目標を押し上げる可能性がある。 | スライスで一体案が時間目標を外した場合に比較する。 |

## 事前レビューの主な確認点

- **屋根と開口。** 屋根下印刷のCADでは屋根面が平らで、ローカル厚み測定は屋根と側壁で1.6 mmでした。G-code記録は、印刷Zが2 mm以上の空洞中央にモデル押出がなく、支持タグもないと示しています。これは選定箇所と記録対象の確認であり、全域の最小厚みや物理品質の保証ではありません。
- **輪とハブ。** 輪の根元は車体へ1 mm重なり、円錐は半径4 mmから3 mmへ幅1 mmで細くなります。ローカル断面では、輪の外側突出が印刷Z=14 mmで0 mm、15 mmで1 mmとなり、0.2 mm層ごとに0.2 mmずつ増えます。選定断面では輪が一層で飛び出さず、段階的に立ち上がる形です。ハブ溝は外径5.2 mm、内径4.0 mm、深さ0.3 mmです。実物での溝の見え方と接合強度は未確認です。
- **窓。** 側窓5.4 mm、前窓6 mmは開口幅で、実際の橋長は押出方向とアンカーで決まります。最終r03画像で前窓2個と側窓3個を確認しました。ローカル厚み測定は側窓柱2.1 mm、前窓中央柱と前壁1.6 mmです。スライスに支持タグはありませんが、橋のたわみと表面品質は印刷していません。
- **色と時間。** 色境界は組立Z=10 mm、印刷Z=12 mmです。色別形状の共有面積は175.36 mm²で、重なり、欠落、余分な体積は0でした。G-codeは白をZ=0.2から12 mm、赤を12.2から22 mmへ割り当てています。1プレート、色替え1回、警告なし、支持材なしで、時間予測は約28分41秒でした。実印刷時間、冷却、取り外し時間は未測定です。

## 根拠と範囲

### DR1とDR2 r00の実体

`reopened-cad-mesh.json`（ローカル保存）は、有効な閉じた単一ソリッド、40 × 20 × 22.05 mmを記録しています。赤白の色別メッシュはそれぞれ閉じたソリッドで、重なり、欠落、余分な体積は0です。`colour-interface.json`（ローカル保存）は、色境界の共有面積を175.36 mm²と測っています。組立向きのZ最小値は−0.05 mmで、全高は公称22 mmから0.05 mm増えています。

`final-view-r03.png`（ローカル保存）は車体斜め上からの画像で、バス形状、前窓2個、側窓3個、赤白境界、立体輪を確認しました。`final-underside-r03.png`（ローカル保存）では床側開口と空洞を確認しました。どちらにも重大な外観欠陥は見えません。初回の屋根面画像は最終外観判定には使いません。

`slice-placed-r01.json`（ローカル保存）の1プレート結果は終了コード0、警告なし、フィラメント切り替え1回、支持材経路なしです。出力は[`bus-two-colour-final.3mf`](../../../../designs/school-bus-v07-open-bottom/candidate-r00/print/bus-two-colour-final.3mf)です。`gcode-review.json`（ローカル保存）は610個のモデル円弧、未解析円弧0、支持タグ0、空洞中央を横切る押出0を記録しています。印刷時間の予測は1,721.266秒（約28分41秒）。モデル本体は5.1875 g、パージとプライムを含む合計は6.9913 gです。予測は45分目標より約16分19秒短く、60分枠には冷却と取り外し用に約31分19秒残ります。実製造時間は測っていません。

確認資料は作業計画（ローカル保存）、DR0入力（ローカル保存）、DR0判断（ローカル保存）、[寸法パラメーター](../../../../designs/school-bus-v07-open-bottom/build_bus.py)、ローカル厚みと輪の開始断面（ローカル保存）、上記の形状、色境界、画像、スライス、G-code記録です。橋は両端の固定と実押出経路で評価し、45度を一律の閾値にしない考え方、実スライサーの色替え回数と時間を使う考え方は、`ローカル保存 の18、24、34から42、89から96行に基づきます。

レビューは生成済みCAD、r03画像、スライスとG-codeの記録に基づきます。実印刷、冷却と取り外しの実時間、橋と輪の物理的な表面品質、接着、強度は未確認です。プリンター送信はありません。
