Sunwood-ai-labs/NEKOMO/docs/designs/school-bus-v06-simple/quality/preprint-review/dr-review.md

# v06 r01 設計審査の最終状態

この版は単色・車内空間なしの小型バスである。後続の床なし・中空・2色の指示はv07へ分離した。過去の初版はrevisions/dr-review-v0.1.0-initial.mdに保存している。

| 段階 | 実施内容 | 判定 |
| --- | --- | --- |
| DR0 | 小型・単色・一体の要求を確認しbefore/after保存 | CAD試作へ進む |
| DR1 | r00/r01のソース、CAD、STEP、STL、再読込、代表断面を確認 | 成人評価用のデータ候補として確認。現物未評価 |
| DR2 | r01 3MFの材料・設定・G-code・時間を確認 | 予測27分6秒、8.17g、支持/色替え/警告なし。造形未実施 |
| DR3 | 現物試験計画と未実施状態を審査 | NOT_RUN |
| DR4 | DR0-3を照合 | HOLD。使用開始を判断しない |

正本はreviews/DR0〜DR4のbefore/afterとmanifest。12 manifest、45ファイルの照合でハッシュ一致を確認した。CADとスライスの確認を物理試験または玩具安全性の確認へ読み替えない。

詳しい実データは../../candidate-r01/evidence/、スライス後判定は../../evidence/after-slice-review.md、現物の未実施と使用保留は../../evidence/DR3-decision.mdとDR4-decision.mdに記録した。
