Sunwood-ai-labs/NEKOMO/docs/designs/school-bus-v06-simple/quality/preprint-review/requirements.md

# v06-simple 要求仕様

## 文書状態

文書改訂番号: 0.3.0  
状態: DR0判定、DR1 CAD、DR2データ確認を反映。印刷・現物評価待ち  
日付: 2026-11-09

DR0のbefore/after正本は親担当の判定（ローカル保存）にある。r01のCAD再読込、メッシュ、ファイルのみのスライスを確認した。印刷と現物評価は未実施である。数値は設計目標と工程目標で、安全基準や規格要求ではない。

## 対象範囲

対象は既存v04を変更せずに作る新規別案 `school-bus-v06-simple` である。試作は成人が扱う造形評価用とする。子どもへの引き渡し、玩具としての使用、安全性の承認、規格適合の判定は対象外である。

今回の作業ではプリンターへデータを送らず、造形しない。スライス結果はファイルのみの検査記録であり、造形実績ではない。

## 要求と現在の確認結果

| ID | 要求 | 確認方法 | 状態 |
| --- | --- | --- | --- |
| R-01 | v06-simpleを新規の別案として作り、既存v04の設計ファイルを変更しない。 | v04の出力前後のパス一覧とハッシュを比較する。 | この担当は品質フォルダーだけを変更。v04全体のハッシュ比較は未確認 |
| R-02 | 外形寸法の目安を長さ40 mm、幅20 mm、高さ22 mmとする。 | 再読込CAD、STEP、STLの三軸境界箱を測る。許容差は未指定なので、現物の寸法合否値を追加しない。 | CAD・STEP・STLで40 × 20 × 22 mmを確認。現物未測定 |
| R-03 | 丸角の車体と屋根を一体の閉じた1ソリッドにする。 | CAD、STEP、STLと角部を確認する。フィレットの要求辺数と適用辺数を区別する。 | CAD・STEP・STLの一体性を確認。7辺すべてへのフィレット適用は未確認 |
| R-04 | 車内空間、座席、組立部品を設けない。 | CADレポート、断面、正面・側面画像を確認する。 | 包囲空洞と貫通窓がないことを確認。現物未確認 |
| R-05 | 窓を浅いくぼみで表す。 | CADの側面図と断面で窓Pocketを確認する。 | 窓Pocketを深さ0.45 mmで確認。現物未確認 |
| R-06 | タイヤは車体側面の浅い円形Pocketで表し、回転させない。 | CAD・メッシュでPocket形状を確認する。 | 車体と一体の側面Pocketを確認。軸や別部品なし。現物未確認 |
| R-07 | 単色PLAで造形する。 | 3MFとG-codeでPLA一色、色替えなしを確認する。材料ラベルとロットも記録する。 | ファイル上は赤PLA一色、色替え0。実機割当とロットは未確認 |
| R-08 | 平底とし、支持材を必要としない形状・姿勢にする。 | CAD底面、支持設定・経路、G-codeの支持タグを確認する。 | 平底、支持無効、支持経路・タグなしを確認。ブリッジと垂直シェル経路の独立確認待ち。現物未確認 |
| R-09 | 印刷時間45分以内、冷却と取外し15分以内、造形開始から取外し完了まで60分以内を目標とする。 | スライサー予測と実測を分け、印刷・冷却・取外しの時刻を記録する。 | 全体予測1,625.6秒、約27分6秒。15分を冷却・取外しに割り当てると約42分6秒。実測なし |
| R-10 | 寸法・形状・工程は成人が扱う造形評価試作に限る。 | 試験記録に評価対象を記録する。 | 子どもへの引き渡しは承認しない |

## 初期造形候補とファイル検査

| 項目 | r01の候補・検査値 | 未確認事項 |
| --- | --- | --- |
| 造形機 | Bambu Lab A1 mini用の3MF | 送信・造形なし |
| 材料・色 | PLA、赤 `#C12E1F`、一色 | 読み取り専用の材料記録はPLA Basic、信頼度medium。製品ラベル、ロット、実機割当なし |
| ノズル | 3MFの適合値0.4 mm | 実機ノズル未確認 |
| 積層高さ・壁数 | 0.20 mm、3 | ファイルのみの確認。物理結果なし |
| 充填 | gyroid、15% | ファイルのみの確認。物理結果なし |
| 支持 | 無効。G-codeの支持タグなし | ブリッジ1件と垂直シェル46件の位置・経路を独立確認中 |
| スライス | 1プレート、110層、警告なし、予測1,625.6秒、材料8.1676 g | 実印刷時間と完成状態は未確認 |

## 時間目標の扱い

ユーザー報告のサンプル造形時間約30分は、形状、材料、設定が同一と確認できていないため比較基準にしない。r01の予測は45分の印刷目標内にある。冷却と取外しの15分は計画上の割当で、実測値ではない。

## 適用しない旧条件

旧v04の幅34 mm内部スクリーニングはv06-simpleの要求または合否条件に含めない。v06-simpleでは約40 × 20 × 22 mmを別案の目標とする。旧条件への適合は主張しない。

## 未設定の条件

窓の深さ以外の局所肉厚、寸法許容差、想定荷重、耐久回数、清掃方法、対象年齢、適用規格は未設定である。根拠のない安全数値や合否基準を追加しない。用途を子ども向けへ変える場合は、対象年齢と使用状況を定めてDR0から審査し直す。
