Sunwood-ai-labs/NEKOMO/docs/README.md

# 公開資料

ネコネコインダストリー（NEKONEKO INDUSTRIES）の公開資料です。ネコネコインダストリーの乗り物玩具について、設計・試作・改良の経緯を公開しています。

> **わくわくを、どこへでも。／Wonder to Go.**

## ブランド

ロゴは38「ねこ船長」を正式採用しました。

- [ブランドの基本情報と採用ロゴ](brand/identity.md)：名称、使命、ロゴデータと使用方針
- [ロゴ案の比較履歴](brand/README.md)：01〜40案と採用までの経緯

## 設計と品質

- [バスの版一覧](バスの版一覧.md)：版ごとの設計差、要望、DR履歴、印刷・現物の記録
- [人間のレビュー記録](人間のレビュー記録.md)：会話原文を含まない要望と判断の要約
- [コンセプトと品質方針](NEKONEKO-INDUSTRIES-concept-and-quality.md)
- [DRレビュー手順](../.agents/skills/nekoneko-dr-review/SKILL.md)：設計審査と記録の方法

## 再現と公開データ

- [取得後の検証と再現手順](reproduce.md)
- [版・審査・レビューの公開データ](data/)
