Sunwood-ai-labs/NEKOMO/docs/brand/README.md

# ネコネコインダストリーのロゴ案

## 現在のブランド

2026年11月13日に、38「ねこ船長」を社名ロゴとして正式採用しました。採用PNG、名称、使命、使用方針は[ブランド基本情報](identity.md)を参照してください。

採用ロゴ「38 ねこ船長」

社名は「ネコネコインダストリー」、英語表記は「NEKONEKO INDUSTRIES」です。製品・活動もこの名称に統一し、旧名を現行のブランドとして使いません。使命は「わくわくを、どこへでも。／Wonder to Go.」です。

## 比較の経緯

初回の比較時点では、正式なロゴは決まっていませんでした。比較を重ね、抽象案16〜20は商品を連想しにくいため保留にしました。その後、ネコと帆船を組み合わせた36〜40案を優先して比較し、38案を採用しました。

比較ページの案内は現在の採用状態を示し、各案の説明は比較当時の記録として残しています。現在の採用内容は[ブランド基本情報](identity.md)を参照してください。

[ミッションを反映した追加5案（06〜10）](mission-logo-concepts.md)と[Wonder to Go.を表す追加5案（11〜15）](wonder-to-go-logo-concepts.md)も比較できます。

[ネコと帆船を組み合わせた追加5案（36〜40）](cat-sailship-logo-concepts.md)、[帆船だけの31〜35案](sailship-logo-concepts.md)、[車・船・飛行機をまとめた26〜30案](land-sea-air-logo-concepts.md)、[船を中心にした21〜25案](boat-logo-concepts.md)を保存しています。[抽象的な16〜20案](minimal-logo-concepts.md)は保留です。

## 初回の5案

以下は、異なるコンセプトで制作した初回の比較案です。当時は、現在のバス試作に加えて車・船・飛行機・潜水艦を構想する、ねこのAI職人たちのおもちゃ工場を表現していました。

| 案 | コンセプト | 主な色 | 表したい印象 |
| --- | --- | --- | --- |
| 01 工房のモノグラム | ねこの輪郭とNを組み合わせる | チャコール・銅色 | 職人の技術と親しみ |
| 02 陸海空の航路 | 波と進行方向を表す線に、ねこの耳を重ねる | ネイビー・ティール | 乗り物の広がりと探究心 |
| 03 組み替える玩具 | 文字を玩具のブロックのように構成する | 青・黄・朱色 | 作る楽しさと遊び心 |
| 04 重工メーカー | ねこの耳を思わせる形と工業的な紋章 | 黒・白・黄色 | 精密さと力強さ |
| 05 和の印章 | 二匹のねこと積層の形を印章にする | 朱色・生成り | 手仕事と日本の工房 |

## 01 工房のモノグラム

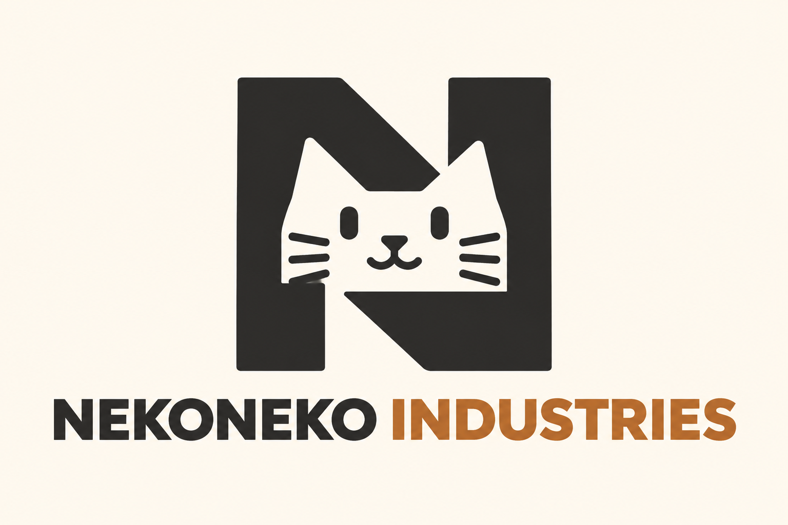
[picture p24: docs/brand/logo-concepts/01-workshop.png]
01 工房のモノグラム


ねこの輪郭とNを一つの記号にする案です。落ち着いた工房の印象を目指し、製品の刻印や部品袋にも使うことを想定しています。

## 02 陸海空の航路

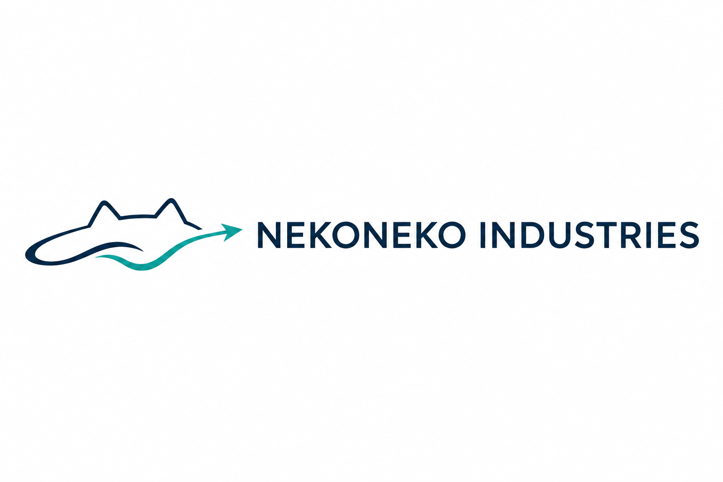
[picture p25: docs/brand/logo-concepts/02-navigation.png]
02 陸海空の航路


車・船・飛行機・潜水艦を、移動と探索という共通のテーマで表す案です。車種ごとの絵に頼らず、今後の製品の広がりを表現します。

## 03 組み替える玩具

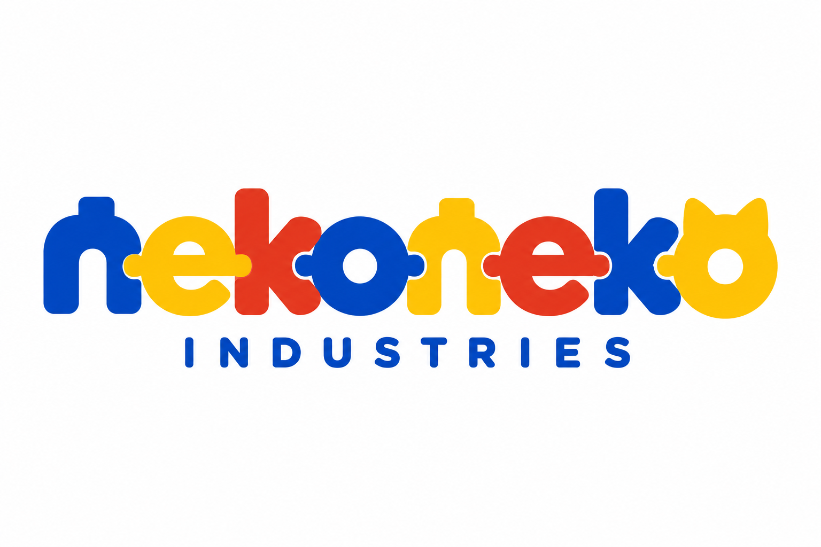
[picture p26: docs/brand/logo-concepts/03-modular-play.png]
03 組み替える玩具


文字そのものを組み立てて遊ぶようなロゴです。親子で楽しむ玩具や、カラフルなパッケージを想定しています。

## 04 重工メーカー

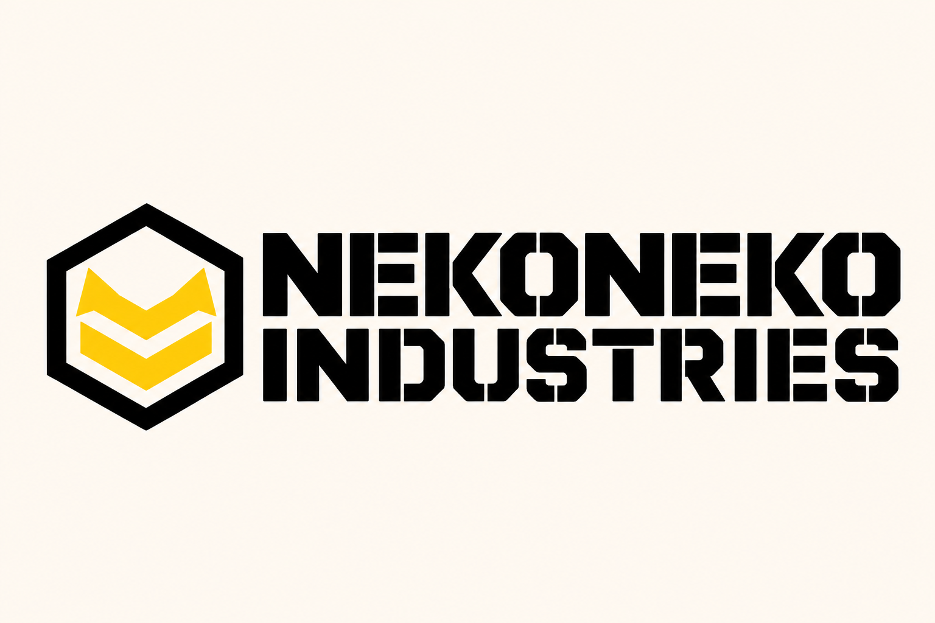
[picture p27: docs/brand/logo-concepts/04-heavy-industry.png]
04 重工メーカー


おもちゃを本格的な工業製品のように扱う、力強いメーカーの案です。ねこの耳を思わせる記号を、工業的な紋章としてまとめます。

## 05 和の印章

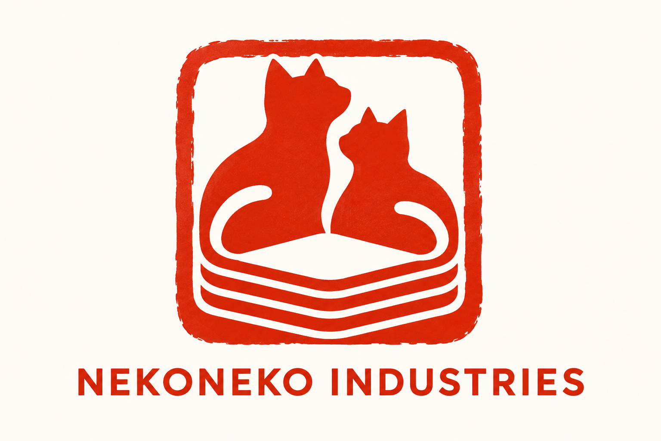
[picture p28: docs/brand/logo-concepts/05-japanese-seal.png]
05 和の印章


ねこの工房が作品に押す印をイメージした案です。和の手仕事と3Dプリントの積層を組み合わせます。

## 制作記録

画像はPNGのコンセプト案です。正式採用した画像以外は、比較記録として保存しています。SVGなどのベクターデータ、正式な書体指定、刻印・印刷用データはまだ作成していません。

[01・02の制作プロンプト](logo-concepts/prompts01-02.md) · [03〜05の制作プロンプト](logo-concepts/prompts03-05.md) · [リポジトリの紹介へ戻る](../../README.md)
