Sunwood-ai-labs/NEKOMO/docs/brand/logo-concepts/prompts33-35.md

# 帆船ロゴ案33〜35

## 33. Open Book Sails

- 画像: `33-openbook-sails.png`
- 狙い: 開いた絵本を思わせる、丸みのある2枚帆と丸い船体だけで描く帆船ロゴ。

### Image generation prompt

```text
Use case: logo-brand
Asset type: original NEKOMO toy-brand logo concept, landscape 3:2.
Primary request: Create concept 33, “Open Book Sails.” The graphic mark is one compact, clearly recognizable sailboat made from exactly three bold black shapes: two broad, softly rounded sails that gently suggest the pages of an open picture book, and one simple rounded hull beneath them. The two sails stand side by side above the hull, with a clear white gap between them. Make it read immediately as a sailboat; the book-page resemblance is a subtle quality of the sails, not a literal book.
Style/medium: original, clean, flat black-and-white toy-brand identity with friendly rounded geometry and large simple forms.
Composition/framing: centered logo on a white 3:2 landscape canvas with generous whitespace. Keep the icon prominent and simple. Add the exact brand wordmark “NEKOMO”, the exact company name “NEKONEKO INDUSTRIES”, and the exact smaller tagline “Wonder to Go.” below the icon. Use legible, carefully spelled lettering.
Color palette: pure black and white only.
Constraints: the sailboat icon contains only two rounded sails and one rounded hull. No mast, waves, rigging, boat accessories, extra icons, or extra pictures. No face, cat, vehicle, or landscape. No gradients, shadows, textures, mockups, interface, or 3D.
```

## 34. Cat-Ear Sails

- 画像: `34-cat-ear-sails.png`
- 狙い: 猫耳のように見える2枚帆を備えた、小さな帆船ロゴ。顔は描かない。

### Image generation prompt

```text
Use case: logo-brand
Asset type: original NEKOMO toy-brand logo concept, landscape 3:2.
Primary request: Create concept 34, “Cat-Ear Sails.” Draw one compact, unmistakable sailboat only: two bold, gently curved triangular sails rise like a pair of cat ears above a small, clear rounded hull. Keep the sails distinct with a clean white gap and a visible slender mast between them so the boat reads first as a sailboat. The cat-ear resemblance should come only from the sails' outer contours.
Style/medium: original, clean, flat black-and-white toy-brand identity; simple rounded geometry, bold silhouette, friendly but not childish.
Composition/framing: centered logo on a white 3:2 landscape canvas with generous whitespace. The sailboat icon is prominent. Add the exact brand wordmark “NEKOMO”, the exact company name “NEKONEKO INDUSTRIES”, and the exact smaller tagline “Wonder to Go.” below the icon. Use legible, carefully spelled lettering.
Color palette: pure black and white only.
Constraints: sailboat only. No cat face, eyes, whiskers, ears separate from the sails, extra icons, vehicles, waves, or scenery. No gradients, shadows, textures, mockups, interface, or 3D.
```

## 35. Wave Sailboat

- 画像: `35-wave-sailboat.png`
- 狙い: 帆1枚と、船体と波を兼ねる1本の曲線だけで描く帆船ロゴ。

### Image generation prompt

```text
Use case: logo-brand
Asset type: original NEKOMO toy-brand logo concept, landscape 3:2.
Primary request: Create concept 35, “Wave Sailboat.” Make a very simple, clearly recognizable sailboat mark from exactly two visual elements: one bold, clean triangular sail above one single smooth black curve that serves both as the boat's hull and as a gentle wave. Keep the curve shallow and continuous, with the sail positioned clearly above it so the first reading is a sailboat on water. Avoid extra lines.
Style/medium: original, clean, flat black-and-white toy-brand identity, bold simple geometric forms.
Composition/framing: centered logo on a white 3:2 landscape canvas with generous whitespace. Keep the two-element icon prominent and uncluttered. Add the exact brand wordmark “NEKOMO”, the exact company name “NEKONEKO INDUSTRIES”, and the exact smaller tagline “Wonder to Go.” below the icon. Use legible, carefully spelled lettering.
Color palette: pure black and white only.
Constraints: the icon has exactly one sail and one continuous hull-wave curve. No mast, second sail, rigging, boat accessories, extra waves, extra icons, vehicles, or scenery. No gradients, shadows, textures, mockups, interface, or 3D.
```
## 生成後の文字修正

### 33. 33-openbook-sails-r02.png

- 元画像: `33-openbook-sails.png`
- 保存画像: `33-openbook-sails-r02.png`
- 修正理由: 生成画像に大きな「NEKOMO」行が加わり、指定した社名・ミッション文より目立ったため、帆船マークは維持してその行だけを除去。

#### Image edit prompt

```text
Edit the referenced image. Remove only the large “NEKOMO” wordmark row located between the sailboat mark and the smaller company/tagline text. Replace that row with clean white background matching the surrounding canvas. Keep the sailboat mark's exact shape, placement, scale, black-and-white appearance, and surrounding whitespace unchanged. Preserve the exact “NEKONEKO INDUSTRIES” company-name row and the exact “Wonder to Go.” tagline below it, including their wording, order, appearance, and placement. Do not add, move, redraw, or alter anything else.
```

### 34. 34-cat-ear-sails-r02.png

- 元画像: `34-cat-ear-sails.png`
- 保存画像: `34-cat-ear-sails-r02.png`
- 修正理由: 生成画像に大きな「NEKOMO」行が加わり、指定した社名・ミッション文より目立ったため、帆船マークは維持してその行だけを除去。

#### Image edit prompt

```text
Edit the referenced image. Remove only the large “NEKOMO” wordmark row located between the sailboat mark and the smaller company/tagline text. Replace that row with clean white background matching the surrounding canvas. Keep the sailboat mark's exact shape, placement, scale, black-and-white appearance, and surrounding whitespace unchanged. Preserve the exact “NEKONEKO INDUSTRIES” company-name row and the exact “Wonder to Go.” tagline below it, including their wording, order, appearance, and placement. Do not add, move, redraw, or alter anything else.
```

### 35. 35-wave-sailboat-r02.png

- 元画像: `35-wave-sailboat.png`
- 保存画像: `35-wave-sailboat-r02.png`
- 修正理由: 生成画像にも大きな「NEKOMO」行があったため、33・34と同じ条件でその行だけを除去。

#### Image edit prompt

```text
Edit the referenced image. Remove only the large “NEKOMO” wordmark row located between the sailboat mark and the smaller company/tagline text. Replace that row with clean white background matching the surrounding canvas. Keep the sailboat mark's exact shape, placement, scale, black-and-white appearance, and surrounding whitespace unchanged. Preserve the exact “NEKONEKO INDUSTRIES” company-name row and the exact “Wonder to Go.” tagline below it, including their wording, order, appearance, and placement. Do not add, move, redraw, or alter anything else.
```
