Sunwood-ai-labs/NEKOMO/docs/brand/logo-concepts/prompts18-20.md

# 18〜20 ロゴ案の生成プロンプト

生成方法: 内蔵の画像生成ツールで各案を個別に生成。参照画像は使用していない。

共通意図: どこへでも持ち歩ける子ども向け玩具を作る会社のロゴ。AIは裏側の方法として扱う。

共通仕様: 横3:2、余白のある白地、黒いマーク、社名 `NEKONEKO INDUSTRIES`、タグライン `Wonder to Go.`。フラットな白黒表現。

## 18 Rolling go. / 小さなgo.

意図: 読みやすい短い「go.」を、出発を表す独自の文字記号としてまとめる。

最終プロンプト:

```text
Use case: logo-brand
Asset type: original company logo concept, vector-friendly
Primary request: Create concept 18, "Rolling go." The large central mark is a bespoke lowercase typographic symbol reading exactly "go." and nothing else. Use a bold rounded custom single-storey g and o. Give the g a short asymmetrical curved descender that lightly suggests rolling forward, make the o nearly circular with one subtle off-center counter, and lift the period slightly for a playful departure. It must immediately read as the three characters g, o, period, not as abstract symbols.
Brand context: The company aims to make toys that children can carry anywhere. AI is only a behind-the-scenes method. Suggest a small sense of wonder and readiness to go without depicting a child, toy, or AI.
Composition: White landscape canvas with a 3:2 aspect ratio, very generous clear margins. Center one cohesive three-character black mark. Beneath it, center the exact company name "NEKONEKO INDUSTRIES" in restrained uppercase sans-serif. On the next line, set the exact tagline "Wonder to Go." smaller. Keep all text crisp, correctly spelled, and separated from the mark.
Color and style: Pure solid black #000000 on pure white #FFFFFF only. Flat, professional, original logo artwork with clean vector-like edges.
Constraints: Keep the mark itself only "go.". No arrows, stars, swooshes, wheels, ribbons, colors, shadows, gradients, textures, 3D effects, mockups, watermarks, or extra text. Do not imitate or resemble an existing brand mark.
```

## 19 Hidden Spark / 余白の星

意図: 二つの形のあいだの白い余白から、四つの角を持つ星を見つける。

最終プロンプト:

```text
Use case: logo-brand
Asset type: original company logo concept, vector-friendly
Primary request: Create concept 19, "Hidden Spark." The emblem consists of exactly two compact, broad, rounded-L-like black geometric pieces, rotated and opposed. Arrange the pieces so the white negative space between them reveals a small asymmetric four-point sparkle. The sparkle must be discovered in the white gap, never drawn as a separate black star. Use bespoke geometry and balanced offsets so the silhouette is clear and memorable.
Brand context: The company aims to make toys that children can carry anywhere. AI is only a behind-the-scenes method. Suggest a small sense of wonder through the negative space without depicting a child, toy, or AI.
Composition: White landscape canvas with a 3:2 aspect ratio, very generous clear margins. Center the two-piece emblem. Beneath it, center the exact company name "NEKONEKO INDUSTRIES" in restrained uppercase sans-serif. On the next line, set the exact tagline "Wonder to Go." smaller. Keep all text crisp, correctly spelled, and separated from the mark.
Color and style: Pure solid black #000000 on pure white #FFFFFF only. Flat, professional, original logo artwork with clean vector-like edges.
Constraints: The emblem is exactly two solid black pieces. No outline, enclosure, tiny decorations, arrow, letter, cat, route, or separate star. No other colors, shadows, gradients, textures, 3D effects, mockups, watermarks, or extra text. Do not imitate or resemble an existing brand mark.
```

## 20 Wonder Step / 一歩踏み出す

意図: 曲線と丸だけで、驚きと前へ踏み出す動きを表す。

最終プロンプト:

```text
Use case: logo-brand
Asset type: original company logo concept, vector-friendly
Primary request: Create concept 20, "Wonder Step." Design a custom playful punctuation-inspired symbol from exactly two elements: one thick smoothly curved comma- or bean-shaped black stroke, tilted forward as if making a tiny leap, plus one small detached rounded black dot. The gesture should feel surprised and ready to go. It must not look like a standard straight exclamation-mark glyph.
Brand context: The company aims to make toys that children can carry anywhere. AI is only a behind-the-scenes method. Suggest a small sense of wonder and readiness to explore without depicting a child, toy, or AI.
Composition: White landscape canvas with a 3:2 aspect ratio, very generous clear margins. Center the two-element symbol. Beneath it, center the exact company name "NEKONEKO INDUSTRIES" in restrained uppercase sans-serif. On the next line, set the exact tagline "Wonder to Go." smaller. Keep all text crisp, correctly spelled, and separated from the mark.
Color and style: Pure solid black #000000 on pure white #FFFFFF only. Flat, professional, original logo artwork with clean vector-like edges.
Constraints: Exactly one curved bean/comma stroke and one detached rounded dot in the mark. No eyes, face, feet, literal character, star, arrows, rings, or additional shapes. No other colors, shadows, gradients, textures, 3D effects, mockups, watermarks, or extra text. Do not imitate or resemble an existing brand mark.
```
