Sunwood-ai-labs/NEKOMO/docs/brand/logo-concepts/prompts13-15.md

# ロゴ案13〜15の生成プロンプト

各案は組み合わせず、built-in image_genで1案ずつ生成。

## 13. Adventure Ticket

狙い: どこでも遊びへ出発できる、ポケットサイズの招待券。
色: ティール、マンゴーオレンジ、白。

Use case: logo-brand
Asset type: standalone original toy-brand logo concept, landscape 3:2
Primary request: Create a compact, charming symbol for NEKOMO that makes “Wonder to Go.” feel like a pocket-size invitation to play and adventure anywhere.
Subject: A simple adventure-ticket silhouette, with two shallow semicircular notches on its sides, one large four-point star cutout, and one slightly lifted corner to suggest it is ready to take along.
Style/medium: Refined, friendly, premium flat vector-friendly identity with crisp, simple geometry.
Composition/framing: Centered horizontal logo lockup with generous white margins. Symbol paired with exact company name and a smaller exact mission line.
Color palette: Teal and mango orange on white.
Text (verbatim): “NEKONEKO INDUSTRIES” and, smaller, “Wonder to Go.”
Constraints: Preserve exact spelling, capitalization, and punctuation. Keep the mark clean and legible at small size. The ticket is an abstract logo symbol, not a detailed paper prop.
Avoid: Extra words, fake text, clutter, dense perforations, bag, cat, shield, door, landscape, hands, gears, mockup, photo, 3D, shadows, gradients, watermark.

## 14. Pocket-size Adventure Map

狙い: 遊びの行き先が広がる、持ち歩ける折り地図。
色: フォレストグリーン、温かみのあるクリーム、控えめなソフトピンク。

Use case: logo-brand
Asset type: standalone original toy-brand logo concept, landscape 3:2
Primary request: Create a portable-play logo for NEKOMO in which Wonder to Go. means play possibilities unfold wherever a child goes.
Subject: A distinctive pocket-size adventure map, reduced to three bold rounded flat panels that fold open. A tiny four-point sparkle sits where a simple playful path arrives, showing the map opening into possibilities.
Style/medium: Original, refined, friendly flat geometrical symbol with a polished toy-brand feel; simple silhouette that reads at small size.
Composition/framing: Centered horizontal logo lockup with generous ivory-white margins. Symbol paired with exact company name and a smaller exact mission line.
Color palette: Forest green, warm cream, and a restrained soft-pink accent.
Text (verbatim): “NEKONEKO INDUSTRIES” and, smaller, “Wonder to Go.”
Constraints: Preserve exact spelling, capitalization, and punctuation. Emphasize a tangible little play object, not a navigation interface or travel-service badge. Keep the three panels readable and distinct.
Avoid: Extra words, fake text, pin icons, GPS interface, globe, orbit, plane, ticket, bag, cat, doorway, portal landscape, hands, mockup, photo, 3D, shadows, gradients, watermark.

## 15. Mission Becomes the Logo

狙い: ミッションを主役にし、出発する動きを文字の形に込める。
色: 温かみのある黒、エレクトリックオレンジ、アイボリー。

Use case: logo-brand
Asset type: standalone mission-centered typographic logo concept, landscape 3:2
Primary request: Make NEKOMO’s mission itself the dominant, crafted wordmark. It must communicate “Wonder to Go.” as wonder that is ready to set off anywhere.
Subject: One cohesive expressive custom wordmark reading exactly “Wonder to Go.” The terminal of the G in “Go” subtly becomes a forward arrow, and the final o contains a small clean sparkle cutout. Light forward rhythm suggests departure while keeping every letter and the period easy to read.
Style/medium: High-quality custom rounded editorial typography, warm and playful with confident restraint.
Composition/framing: The mission wordmark is the main event, centered with generous ivory margins. A small secondary company endorsement reads exactly “NEKONEKO INDUSTRIES”.
Color palette: Warm black and electric orange on ivory.
Text (verbatim): Primary “Wonder to Go.”; secondary “NEKONEKO INDUSTRIES”.
Constraints: Preserve exact spelling, capitalization, spacing, and punctuation. Keep this as one cohesive typographic logo; the arrow detail must not alter the readable text.
Avoid: Any other words, separate W monogram, ribbon symbol, modular multicolor letters, full illustration, ticket, map, cat, bag, mockup, photo, shadows, gradients, 3D, watermark. This is a mission-centered logo concept, not a company rename.
