Sunwood-ai-labs/NEKOMO/docs/brand/logo-concepts/prompts06-07.md

# ロゴ案06・07

正式ロゴ採用前の提案画像。ブランドの核は「わくわくを、どこへでも。」／“Wonder to Go.”。

## 06 — Pocket Wonder

- 狙い: ポケットから現れる火花で、持ち運べるわくわくを表す。猫らしさは耳を思わせる輪郭だけに留め、顔は描かない。
- 配色: サンシャインオレンジ、ディープウルトラマリン。
- 画像: 06-pocket-wonder.png
- 最終プロンプト:

> Create a standalone premium consumer brand logo proposal on a clean white background, landscape 3:2 composition, high resolution, generous white margins. Central symbol: a simple rounded pocket icon with one bright small four-point spark emerging from its opening; let the pocket subtly suggest two tiny cat-ear corners, but no face, no eyes, no whiskers. Communicate portable joy and wonder in a pocket. Use only a restrained sunshine orange and deep ultramarine palette, with crisp flat shapes and warm playful minimalism. No gradients, no gear, no industrial monogram, no shield, no badge, no mockup, no extra objects. Keep the icon clear and compact, centered above the type. Render the exact text below, with precise spelling and clean hierarchy: first line in uppercase, exactly "NEKONEKO INDUSTRIES"; second line smaller, exactly "Wonder to Go." Keep the lettering crisp, legible, correctly spelled, centered, and comfortably inside the image. No Japanese text anywhere. This is one unapproved logo concept, not a final brand lockup.

## 07 — Little Companion

- 狙い: 小さなバッグを持って弾むように歩く猫で、どこへでも連れていける相棒感を表す。
- 配色: ソフトミント、インクネイビー。
- 画像: 07-little-companion.png
- 最終プロンプト:

> Create a standalone consumer brand logo proposal on a clean white background, landscape 3:2 composition, high resolution, with generous white margins. Depict exactly one original charming simplified cat character taking one buoyant step while carrying a tiny rounded bag. Use a compact, badge-free silhouette and a humane hand-drawn visual language with smooth rounded forms; keep the expression subtle and the pose readable at small size. Add exactly one small four-point sparkle beside the bag to imply wonder. Use a restrained soft mint and ink navy palette. Keep the scene minimal, with no crowded illustration, no additional animals, no face resembling an existing mascot, no industrial style, no N monogram, no route or line motif, no badge, no gradients, no photo, and no mockup. Place the icon centered above a clean wordmark. Render the exact text below, with precise spelling and hierarchy: first line in uppercase, exactly "NEKONEKO INDUSTRIES"; second line smaller, exactly "Wonder to Go." Keep both lines crisp, legible, correctly spelled, centered, and comfortably inside the image. No Japanese text anywhere. This is one unapproved logo concept, not a final brand lockup.
