Sunwood-ai-labs/NEKOMO/docs/designs/school-bus-v05-dfam/版の案内.md

# v05の案内

v04から派生・底面2開口と支持材除去の検討

記録の確認日: 2026-11-10。開口候補はCAD確認まで。正式な全DR記録なし。比較用スライスは別のv04基準形状。

全版の一覧（ローカル保存）

## CADと印刷データ

- [cad/nekomo-school-bus-v05-open-underside.FCStd](../../../designs/school-bus-v05-dfam/cad/nekomo-school-bus-v05-open-underside.FCStd)
- coupon/v04-middle-window-support-removal-coupon.FCStd（ローカル保存）

## 人間のレビュー・判断

本人発言と出典の記録（ローカル保存）

- 設計フィードバック。床なし・空洞・逆さ印刷を提案。対象・反映先はv05 → v06。根拠はR07。
- 設計フィードバック。2色を指定。対象・反映先はv05 → v06。根拠はR08。

完成品の品質に対する人間のレビューはなしです。

## エージェントのレビュー・検証記録

開口候補のCAD形状を確認。候補本体のスライスと正式なDR0〜4は未実施。比較用のv04スライスと区別する。

### v05・底面開口候補

| DR段階 | 星取 | 元の判定 |
| --- | :---: | --- |
| DR0 要求 | なし | なし |
| DR1 設計 | なし | なし |
| DR2 工程 | なし | なし |
| DR3 現物試験 | なし | なし |
| DR4 使用判定 | なし | なし |

実施した検査は次のとおりです。

- 底面2開口、残す側レール・横桟・座席の接続と、有効な単一ソリッドを確認。
- 中央窓の支持材除去用検証片を準備。
- 開口候補本体のスライスはなし。時間比較用のv04基準形状のスライスとは区別する。

### 関連する検証・実機記録

- evidence/geometry-variants.json（ローカル保存）
- [coupon/README.md](coupon/README.md)
- evidence/time-investigation/調査結果.md（ローカル保存）

## 保存場所の扱い

このフォルダがこの版の保存場所です。旧候補、失敗記録、DR前後の証跡は元の場所に残しています。
案内にある印刷データには未印刷のものも含まれます。データ審査と現物試験の結果は各記録で区別しています。
