Sunwood-ai-labs/NEKOMO/docs/designs/school-bus-v06-empty-inverted/two-color-red-tyres/after-slice-review.md

# 赤タイヤ配色のスライス後レビュー

## 比較

赤い屋根と赤いタイヤリング、白い車体とハブの候補は、保存済み実スライス `red-tyres-inverted-sliced.3mf` で予測2時間35分38秒、43.45997 g、材料切替40回、警告なしです。白タイヤの赤屋根・白車体版 `../two-color/red-white-inverted-sliced.3mf` は1時間14分42秒、24.17290 g、切替1回、警告なしでした。今回の差は予測時間+1時間20分56秒、材料+19.28707 g、切替+39回です。どちらも単回のスライス予測で、印刷実績ではありません。

この差には色替え時のパージが含まれます。赤版のG-codeはFlush区分3,513.6秒、Prime tower区分610.6秒を計上しています。合計材料43.45997 gの内訳は、赤16.47747 g、白26.98250 gです。

## 色と形状の確認

3MFのパーツ割当は赤slot 0が屋根とタイヤ、白slot 1が車体とハブです。内部の色順は41区間で交互になり、G-codeにもslot 0/1の選択とT0/T1の切替が40回あります。支持材はnormal(auto)設定で、別素材のサポートフィラメントはありません。実G-codeでは支持材も赤と白のモデル用PLAで出力されます。

形状レポートでは物理形状を維持し、色領域の重複・欠落・余剰体積はすべて0 mm³です。4輪それぞれの赤いタイヤリング体積は約373.383 mm³で、白いハブとの重なりは0 mm³。元の白タイヤ版CADは変更されていません。

## 範囲

スライサー警告はありません。対象スライス3MFのSHA-256は `abeb576ae657ca6edf25355696f14735eca15ae2bf9eb246b380fc9cb66381e5` です。実印刷、支持材の除去、接着、強度は確認していません。3MFの送信・印刷も行っていません。
