Sunwood-ai-labs/NEKOMO/docs/designs/school-bus-v07-open-bottom/evidence/DR1-source-findings-r00.md

# v07 DR1 初回ソース確認

初回ソースと設計メモをbefore/source-draft-r00に保存。CADはまだ生成していない。

1. 文書への任意property追加とheadless時のViewObject参照を実行可能な構造へ修正する。
2. 前窓の幅計算と実配置が一致しないため修正し、前窓カッターが前方19mmの屋根まで切らないよう前壁だけを通す。
3. 単純な輪円柱の開始部に1mmの張り出しがある。外向き輪縁のテーパーを追加して逆さ印刷時に車体から順に育つ形を狙う。
4. ハブ溝が細いため広げ、指定した凹み深さと実際のカッター深さを一致させる。
5. 長い前斜面を2mm程度の屋根角の面取りへ変更し、床なしの箱バスとしての見た目と広い屋根接地面を確保する。内側も1.6mmオフセットを保つ形にする。
6. スライス説明用のメモと、実際のBambu process profileを分離する。

修正後にCAD実行、窓と開口、色境界、輪の接合、逆さ姿勢を確認する。支持不要や1時間内はまだ未確認。
