Sunwood-ai-labs/NEKOMO/docs/designs/school-bus-v04-dr/quality/preprint-review/dr-review.md

# v04のDR判定記録

## 審査範囲

対象は全長60 mm級・幅34 mm・赤白・固定輪のバスです。今回の範囲はプリンター送信前までで、造形、現物試験、子どもの使用開始は含みません。

要求と設計FMEA、試験計画は別のAI担当が作成し、親担当が要求の出典、数値、設計対策と成果物を照合しています。これは認定試験機関や有資格者による製品安全認証ではありません。

## 審査状態

| 段階 | 活動と対象 | 現在の判定 |
| --- | --- | --- |
| DR0 | 要求R-01〜R-10、内部基準A-01〜A-06、試験T-00〜T-15を整理し、利用者指定と設計側の判断を分離 | 要求・評価計画をレビュー済み。子ども使用の適合判定は保留 |
| DR1 | 3部品の位置決め構造と一体構造を比較。別体屋根・底板をなくし、内部接合部と幅を見直す。D-01〜D-16を試験へ対応づける | 最終CAD・メッシュと領域分割を確認。成人評価用試作に限る条件付き判定。現物強度と安全性は未確認 |
| DR2 | P-01〜P-12、材料割当、造形条件、支持材除去、個体と記録の管理をレビュー | 最終スライス・出力経路・材料割当予定を確認。成人評価用試作に限る条件付き判定。工程の実証は未実施 |
| DR3 | T-00の成人評価用1個を先行し、問題がなければ必要な試験へ進める計画 | 未実施。印刷・現物試験の合格記録はない |
| DR4 | 同じ改訂・材料・工程の試験結果と残留リスクから使用可否を判断 | 未実施。子ども使用は未承認 |

最終のデータ検査結果はevidence/preprint-gate.json（ローカル保存）へ記録します。検査が不合格または未実施のときに、資料の項目数だけで完了へ変更しません。

## 審査で実際に変更した点

1. v03の屋根・底板は抜け止めのない位置決め構造だったため、そのままの構成は選ばず、一体の物理形状へ変更しました。色領域は赤白のままです。
2. 幅31.824 mm案では選定した凸包内接球の内部基準を満たさず、幅34 mm案を選びました。最終STLに対応する再計算で直径33.399924 mmを確認しました。これは内部のCADスクリーニングで、現物の小部品円筒試験の合格ではありません。
3. 欠けたときの破片、色境界、層間、窓、支持材の残留、材料・清掃・燃焼をFMEAと試験へ対応づけました。未確認項目に推測の点数や合格を付けていません。
4. 試験計画は公開一次資料の手順と内部基準を分け、最初に1個の除去性・寸法・外観を確認する段階を設けました。

## 造形後まで残る条件

CAD上の一体化は積層や色境界の強度を実証しません。内部の支持材を除去できなければ、その試料は不合格として形状・姿勢を見直します。

材料の実製品・色材・ロット、化学評価、清掃条件、指挟み評価の適用性、必要な燃焼・端部評価と試験結果が確定していません。これらは子どもの使用判定を保留する条件です。データ審査や成人向けの試作計画の確認を、使用承認へ読み替えません。

## 審査入力

- [要求仕様](requirements.md)
- [設計FMEA](dfmea.md)
- [工程FMEA](pfmea.md)
- [試験計画](test-plan.md)と[一次資料一覧](sources.md)

## 最終データの確認結果

最終CADとSTEPを保存後に開き直し、再計算後も有効な閉じた1ソリッドであること、外部文書への参照がないことを確認しました。0.005 mmの分割誤差設定で再読込BRepをメッシュ化した外形は約60.000 × 34.000 × 35.568 mmです。B-splineの制御点を含む保守的な境界箱を実外形として使っていません。最終再読込検査（ローカル保存）

4本の補強部は断面約2.527 × 2.059 mmで、両方の接合先への正の体積重なりを確認しました。前窓上端は元の車体だけを見た1.872 mmという値と一体化後の全断面を分けて確認しました。選定した支持部の連続Z断面は約5.765〜7.126 mmです。接線に近い外周の薄い交線も記録に残し、全域の最小肉厚や強度を確認したとは扱っていません。代表断面（ローカル保存）

赤白領域の交差、全体からの欠損、全体への余剰は直接のブーリアン計算で各0 mm³でした。一方、領域の体積和には+2.74856 mm³の残差があり、当初の体積和0.05 mm³の検算は未達として保持しました。これを合格へ書き換えず、B-spline形状の数値積分による残差と、実際の領域の過不足を分けて記録しています。領域分割の判定には交差と差集合の結果を用います。幾何検査（ローカル保存）

STL3点はメッシュ検査を通過し、最終3MFはA1 mini・0.4 mm向けのファイル検査を通過しました。G-code上の支持材ツールにモデル部分の経路はありません。材料の実性能、支持材除去と層間・色境界の強度は未確認です。
