Sunwood-ai-labs/NEKOMO/docs/designs/school-bus-v04-dr/quality/preprint-review/sources.md

# 試験計画の出典

## 出典の使い方

2026-11-09に一次資料を確認した。eCFR各ページは閲覧時点で2026-11-05現在のTitle 16を表示していた。試験を実施する時点でも最新条文を確認する。

本計画はeCFRの公開手順を社内スクリーニングへ転用する。測定器、試料、実施方法の適合性を検証していないため、条文と同じ数値を使っても規則適合を主張しない。日本での3歳未満向け玩具の法的扱いはMETIの現行資料と専門機関で判断する。ISO・STの非公開本文を参照したり、未確認の条項番号や要求値を補ったりしていない。

## 一次資料

| ID | 公開元と資料 | 本計画で参照した内容 |
| --- | --- | --- |
| S-01 | [経済産業省要望内容](https://www.meti.go.jp/product_safety/kodomo/gangu_kisei.html) | 3歳未満向け玩具の技術基準、自主検査・記録、年齢設定と表示、ST基準とISO8124-1:2022・ISO8124-2:2023の関係を確認した。2026年6月15日更新のページを参照した。 |
| S-02 | [eCFR 16 CFR §1500.50要望内容](https://www.ecfr.gov/current/title-16/chapter-II/subchapter-C/part-1500/section-1500.50) | (a)の目的、(b)(1)(ii)の年齢帯と最厳要件、(b)(2)の英単位優先、(b)(3)の未試験試料とねじり後の引張りの組合せ、(b)(4)の温度・湿度調整と試験開始時間を参照した。 |
| S-03 | [eCFR 16 CFR §1500.51要望内容](https://www.ecfr.gov/current/title-16/chapter-II/subchapter-C/part-1500/section-1500.51) | (b)落下衝撃、(c)咬み、(d)金属部材の屈曲、(e)ねじり、(f)引張り、(g)圧縮の適用条件、設備、負荷、時間を参照した。 |
| S-04 | [eCFR 16 CFR §1500.52要望内容](https://www.ecfr.gov/current/title-16/chapter-II/subchapter-C/part-1500/section-1500.52) | (b)落下衝撃、(c)咬み、(d)金属部材の屈曲、(e)ねじり、(f)引張り、(g)圧縮の適用条件、設備、負荷、時間を参照した。 |
| S-05 | [eCFR 16 CFR §1501.4要望内容](https://www.ecfr.gov/current/title-16/chapter-II/subchapter-C/part-1501/section-1501.4) | (a)の円筒内へ収まらないこと、(b)(1)の無圧縮・全方向での試験、(b)(2)の使用・酷使後の脱落部品の確認を参照した。図1と英単位を使う。 |
| S-06 | [米国消費者製品安全委員会（CPSC）職員資料要望内容](https://www.cpsc.gov/s3fs-public/Small-Parts-16-C-F-R-Part-1501-English.pdf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) | 小部品円筒の図と一般向け説明を確認した。円筒は内径1.25 in、内側深さ2.25 inと示す。条文に代わる基準としては使わない。 |
| S-07 | [経済産業省要望内容](https://www.meti.go.jp/product_safety/kodomo/pdf/gizyutukizyun_gangu.pdf) | 技術基準省令別表第1第9項要望内容、公的解釈で参照する国際規格名を確認した。 |
| S-08 | [eCFR 16 CFR §1500.44要望内容](https://www.ecfr.gov/current/title-16/chapter-II/subchapter-C/part-1500/section-1500.44) と [§1500.3(c)(6)(vi)要望内容の定義](https://www.ecfr.gov/current/title-16/chapter-II/subchapter-C/part-1500/section-1500.3) | 米国の危険物質分類向け固体試験の手順と分類値を確認した。手順は試料温度68～86 °F、直径1 in以上のろうそく炎を5秒以下接触、燃焼時間を最大60秒で記録する。分類値は主軸の燃焼速度0.1 in/s超。日本の玩具安全基準に対する試験・合格方法としては使わない。 |
| S-09 | [eCFR 16 CFR §1500.48要望内容](https://www.ecfr.gov/current/title-16/chapter-II/subchapter-C/part-1500/section-1500.48) | 8歳未満向けの適用範囲、先端ゲージ、3歳以下向けのアクセス性プローブA、試験前後の確認手順を参照した。 |
| S-10 | [eCFR 16 CFR §1500.49要望内容](https://www.ecfr.gov/current/title-16/chapter-II/subchapter-C/part-1500/section-1500.49) | 金属・ガラス縁に限る適用範囲、プローブA、回転マンドレル、荷重、TFEテープ切断判定を参照した。樹脂縁には適用しない。 |

## 条項から計画へ

| 試験計画ID | 出典と条項 | 出典の条件・数値 |
| --- | --- | --- |
| T-03 | S-05 §1501.4(b)(1)–(2), S-06 | 対象を圧縮せず円筒に入れ、どの向きでも完全に収まるか確認する。円筒は内径1.25 in、深さ2.25 in。試験後に外れた部品・破片も一つずつ試す。S-02(b)(2)により英単位を優先する。 |
| T-04 | S-03 §1500.51(b) | 質量3.0 lb未満の玩具。公称厚さ1/8 inのType IV asbestos-free vinyl-composition tileと厚さ2.5 in以上のコンクリート、3 ft²以上の面。4.5 ft ±0.5 inから無作為向きで10回。各回後に静止させて観察する。 |
| T-05 | S-04 §1500.52(b) | 質量4.0 lb未満の玩具。T-04と同じ衝撃面。3 ft ±0.5 inから無作為向きで4回。各回後に静止させて観察する。 |
| T-06 | S-03 §1500.51(e)–(f) | ねじり2 in-lb ±0.2 in-lb、最大180度または規定トルク到達、5秒以内の負荷、10秒保持を両方向で行う。引張り10 lbf ±0.5 lbfを長軸方向と直角方向へ各5秒以内で加え、各10秒保持する。 |
| T-07 | S-04 §1500.52(e)–(f) | ねじり3 in-lb ±0.2 in-lb、最大180度または規定トルク到達、5秒以内の負荷、10秒保持を両方向で行う。引張り15 lbf ±0.5 lbfを長軸方向と直角方向へ各5秒以内で加え、各10秒保持する。 |
| T-08 | S-03 §1500.51(g) | 金属円板1.125 in ±0.015 in径、0.375 in厚、縁半径1/32 in。精度±0.5 lbfの荷重計で20 lbf ±0.5 lbfを5秒以内に加え、10秒保持する。 |
| T-09 | S-04 §1500.52(g) | T-08と同じ円板。25 lbf ±0.5 lbfを5秒以内に加え、10秒保持する。 |
| T-10 | S-03 §1500.51(c); S-04 §1500.52(c) | 外寸1.25 in ±0.05 in以下、どの向きでも口に入れられ、咬める厚さ1.25 in ±0.05 in以下、挿入深さ0.25 in以上の条件を満たす形状に適用。接触板高0.25 in ±0.002 in、縁半径0.020 in ±0.002 in、150度以上の円弧。試料を0.25～0.5 in挿入し、接触板円弧180度未満を使う。18か月以下は25 lbf ±0.5 lbf、18か月超36か月以下は50 lbf ±0.5 lbf。5秒以内に加え、10秒保持する。 |
| T-00, T-01, T-02, T-11, T-13 | 内部設計判断 | T-00は成人向け試料1個。T-01のデジタル寸法は60.000 × 34.000 × 35.568 mmの各軸±0.05 mm以内、現物寸法は各軸±0.5 mm以内。A-04最大球径33.0 mm以上は最終メッシュで別に判定し、現物のT-03円筒試験にも代わらない。T-02の10倍ルーペ。T-11の清掃用試料n=3。T-13の指挟みゲージは数値を定めず専門機関へ照会する。 |
| T-04～T-10 | S-02 §1500.50(b)(4) | §1500.51／§1500.52試験の各試料を73 °F ±3 °F、相対湿度20～70 %で4時間以上調整し、調整環境から取り出した後5分以内に試験を開始する。温度、湿度、時間を記録する。 |
| T-12 | 内部記録要件、S-01 | 赤白の製造元、製品番号、色材、組成資料、材料ロットを記録する。化学安全の受入値は定めない。 |
| T-12 | S-01 | 日本の技術基準、年齢設定、警告表示、自主検査・記録の確認先。材料の化学受入値は本計画に設定していない。 |
| T-14 | S-01, S-07, S-08 | 日本の基準は燃焼しにくい材料・構造を求める。§1500.44は米国の固体分類試験であり、玩具適合試験と同一視しない。§1500.3では§1500.44の方法で主軸に沿う燃焼速度が0.1 in/sを超える固体を要望内容と定義する。 |
| T-15 | S-09 §1500.48; S-10 §1500.49 | 先端試験はアクセス可能な点に使用・酷使試験前後で適用する。§1500.49の縁試験は金属またはガラスの縁に限る。§1500.48の治具は開口0.040 × 0.045 in以下、感知部のくぼみ0.015 in以上、追加移動量0.005 in、ばね荷重0.5 lbf、操作力上限1.00 lbf。§1500.49は直径0.375 ±0.005 inの金属マンドレル、回転中央75 %の接線速度1.00 ±0.08 in/s、MIL-I-23594B記載PTFEテープの裏材厚さ0.0026～0.0035 in、シリコーン接着剤公称0.003 in、幅0.25 in以上、テープ温度70～80 °F、最大1.35 lbf、全周1回転、0.5 in以上の完全な切れで判定する。 |

## 内部基準と未確認事項

次の値・判定は本計画だけの内部基準で、上記出典の要求値ではない。

| 内部判定 | 根拠と状態 |
| --- | --- |
| T-01のデジタル寸法条件60.000 × 34.000 × 35.568 mm、各軸±0.05 mm以内。現物寸法品質は各軸±0.5 mm以内。 | 玩具規格の公差ではない。長さ60 mmは利用者指定、幅34 mmと高さ35.568 mmは内部設計値。再読込CAD・STEPの寸法は各軸で±0.05 mm以内だった。reopened-cad-report.json（ローカル保存） |
| T-01の凸包内最大球直径33.0 mm以上。 | CAD補助スクリーニング。34.0 mm幅候補は33.402 mm、31.824 mm幅は31.373 mm。最終メッシュは33.399924 mmで通過した。final-hull-screen.json（ローカル保存） 理想形状の内部判定で、規格値や現物の小部品円筒試験ではない。 |
| T-00の成人向け試料1個、T-00後の各試験セルn=3。 | 内部の試料計画で、eCFRに定められた試料数ではない。 |
| 試料ID形式 `V04-B###-T##-R#`、3MFとSHA-256、造形日時、プリンター・測定器・治具と設定の識別子。 | ロットまたは造形ジョブごとの試料割当を含む内部記録要件。 |
| 支持材残留、亀裂、剥離、鋭い縁・先端、べたつき、変形を不合格または保留とする。 | 社内スクリーニングの判定。清掃試験は3試料で行い、外形寸法の実測も記録する。 |
| 指挟み評価は適用性を保留する。 | 年齢別ゲージ寸法と合否値を確認できていないため、試験機関へ照会する。 |
| §1500.44の固体燃焼試験は適格試験機関に限る。 | 米国の危険物質分類方法として参照する。日本の玩具適合判定・子ども使用の根拠にはせず、METI資料と専門機関の評価で別途判断する。 |
| T-15の先端・金属/ガラス縁検査は適格試験機関で行う。 | 樹脂縁の適用方法と判定値は専門機関へ照会する。 |

化学安全について、材料名だけで合格を決める値は設けていない。赤白の正確な品番・組成・ロット、供給者資料、適用する化学評価が揃うまでT-12を保留する。実測していない項目は、すべて試験計画の状態表でPENDINGとする。
