Sunwood-ai-labs/NEKOMO/docs/バスの版一覧.md

# バスの版一覧

記録の確認日: 2026-11-10。版別の詳細は各版の案内を参照してください。

## 公開範囲

公開モデル、技術審査資料、要望と検査の要約を掲載しています。会話原文、印刷操作ログ、非公開の画像・動画・内部整理記録は含めていません。

## 版別の人間レビューと印刷状況

| 版 | 概要 | 人間の要望・反応 | 採用・印刷指示 | 印刷 | 現物の報告 |
| --- | --- | --- | --- | --- | --- |
| [v01・大型一体](designs/school-bus-v01/%E7%89%88%E3%81%AE%E6%A1%88%E5%86%85.md) | 大型・一体固定輪 | ○ 外観修正 | なし | なし | なし |
| [v02・大型3部品](designs/school-bus-v02/%E7%89%88%E3%81%AE%E6%A1%88%E5%86%85.md) | 大型・車体／シャーシ／屋根の3部品 | ○ 赤白・小型化 | なし | なし | なし |
| [v03・60mm組立](designs/school-bus-v03-mini/%E7%89%88%E3%81%AE%E6%A1%88%E5%86%85.md) | 60mm級・赤白の3部品 | ○ 肯定的反応 | なし | なし | なし |
| [v04・60mm一体](designs/school-bus-v04-dr/%E7%89%88%E3%81%AE%E6%A1%88%E5%86%85.md) | 60mm級・幅34mm・赤白一体構造 | ○ 製造性の質問 | なし | なし | なし |
| [v05・底面開口候補](designs/school-bus-v05-dfam/%E7%89%88%E3%81%AE%E6%A1%88%E5%86%85.md) | v04から派生・底面2開口と支持材除去の検討 | ○ 床なし・空洞の提案 | なし | なし | なし |
| [v06・40mmシンプル](designs/school-bus-v06-simple/%E7%89%88%E3%81%AE%E6%A1%88%E5%86%85.md) | 40×20×22mm・単色・車内空間なし | ○ 簡素化の要望 | なし | なし | なし |
| [v06・60mm空洞](designs/school-bus-v06-empty-inverted/%E7%89%88%E3%81%AE%E6%A1%88%E5%86%85.md) | 床・座席を抜く60mm級。単色、赤屋根、赤タイヤの派生 | ○ タイヤ色違いの要望 | なし | なし | なし |
| [v06・赤タイヤ](designs/school-bus-v06-empty-inverted/%E7%89%88%E3%81%AE%E6%A1%88%E5%86%85.md) | 床・座席を抜く60mm級。単色、赤屋根、赤タイヤの派生 | 色違いは元案で要望 | ○ 採用・印刷指示 | ○ | 本人報告あり |
| [v07・40mm床なし](designs/school-bus-v07-open-bottom/%E7%89%88%E3%81%AE%E6%A1%88%E5%86%85.md) | 40mm級・床なし空洞・赤白・立体固定輪 | ○ 床なし・空洞等の要望 | なし | なし | なし |
| [v08・写真型](designs/school-bus-v08-photo/%E7%89%88%E3%81%AE%E6%A1%88%E5%86%85.md) | 42×21×24mm・参照写真に寄せたボンネット付き | ○ ボンネット変更提案 | なし | なし | なし |
| [v09・傾斜ボンネット](designs/school-bus-v09-sloped/%E7%89%88%E3%81%AE%E6%A1%88%E5%86%85.md) | 42×21×24mm・支持材なしを狙う傾斜ボンネット | 傾斜案はv08で提案 | ○ 試し刷り指示 | ○ | なし |

凡例: 人間欄の○は要望・反応の記録あり、採用欄の○は採用・印刷指示あり、印刷欄の○は印刷完了です。現物欄は本人報告の有無を示し、DR3合格を表しません。

印刷済みはv06赤タイヤ版とv09の2件です。v06赤タイヤ版は本人報告、v09は機械記録と本人報告に基づきます。印刷完了はDR3合格を意味しません。

## エージェントのDR0〜4と個別検査

| 版 | DR0 | DR1 | DR2 | DR3 | DR4 | 個別検査 |
| --- | --- | --- | --- | --- | --- | --- |
| v01・大型一体 | なし | △条件付き | △データ確認 | なし | なし | 一体構造・固定輪の設計方針を審査。 CADの有効性、STLの閉鎖性と接続、単色・2色のスライスを確認。 リア窓上端の長い橋渡しを検出し、検証片を用意。現物試験はなし。 |
| v02・大型3部品 | なし | なし | なし | なし | なし | 車体・シャーシ・屋根の形状、干渉と位置決めを確認。 各部品の姿勢・支持材・スライスを比較し、保存した印刷ファイルを検査。 固定輪まわりの支持材除去を現物の確認課題として記録。 |
| v03・60mm組立 | △一部 | △一部 | △データ確認 | なし | なし | 赤白・60mm・固定輪の要求を反映。外観と位置決め部の肉厚を調整。 3部品の再読込・干渉、STEPとSTLの形状を確認。 支持材と材料割当、スライスとG-codeを確認。DR0〜2の完了・合格判定はなし。 |
| v04・60mm一体 | ○審査済み | △条件付き | △条件付き | なし | なし | 要求仕様、設計FMEA16項目、工程FMEA12項目、試験計画を整理・審査。 別体の屋根・底板を一体化し、幅と補強部を見直す。CAD・メッシュ・色領域を確認。 材料割当・支持材除去計画・スライスと出力経路を確認。 整理時の再照合では保存CADのハッシュ不一致が残る。現在の再梱包は停止。 |
| v05・底面開口候補 | なし | なし | なし | なし | なし | 底面2開口、残す側レール・横桟・座席の接続と、有効な単一ソリッドを確認。 中央窓の支持材除去用検証片を準備。 開口候補本体のスライスはなし。時間比較用のv04基準形状のスライスとは区別する。 |
| v06・40mmシンプル | ○審査済み | △データ確認 | △データ確認 | なし | 保留 | 小型・単色・一体の要求を確認し、DR前後のデータを保存。 r00・r01のソース、CAD・STEP・STLの再読込と代表断面を確認。前面・窓位置を修正。 3MFの材料・設定・G-code・時間を確認。予測27分6秒、支持材・色替え・警告なし。 |
| v06・60mm空洞 | なし | なし | なし | なし | なし | 床・座席を抜いた形状と空洞を確認。 正立・逆さ、支持材なし・tree・normalをスライス比較。 赤屋根・白車体の2色案について、色替え・時間・支持材とG-codeを確認。 |
| v06・赤タイヤ | なし | なし | なし | なし | なし | 赤い屋根・タイヤと白い車体・ハブの色分けを確認。 逆さ姿勢・通常支持材のスライス、色替え40回・予測時間・材料量を確認。 印刷ファイル・G-codeとAMS割当を確認。印刷済みは本人報告で記録し、現物試験の合格とは区別。 |
| v07・40mm床なし | ○審査済み | △データ確認 | △データ確認 | なし | 保留 | 床なし・中空・逆さ・2色・固定輪の要求を審査し、DR前後を保存。 窓の切り抜きと輪の張り出しを修正。CAD・STEP・STL、局所厚さ、色境界と空洞を確認。 タワー位置の失敗を修正して再スライス。G-codeで空洞中央を横切る押出がないことなどを確認。予測28分41秒、色替え1回、支持材なし。 |
| v08・写真型 | なし | なし | なし | なし | なし | CAD再読込、単一ソリッド、床開口、色領域の重複と欠落を確認。 白タイヤと赤タイヤの配色をスライス比較し、色替え・時間・材料量を確認。 逆さ印刷でボンネットが空中から始まる問題を確認。全DRの再実施はなし。 |
| v09・傾斜ボンネット | なし | なし | なし | なし | なし | 傾斜ボンネットへ変更し、保存CADの再読込と床開口を確認。 CADの層ごとの断面と、実G-codeの押出線幅を用いて前層との重なりを確認。検査範囲はボンネット中央の抽出点。 保存3MFの設定・警告・支持材・色替えを確認。実機のFINISH・100%・119層完了も記録。寸法・強度などの現物試験の合格記録はなし。 |

凡例: ○審査済み / △条件付き / △データ確認 / △一部 / 保留 / なし。

DR3の現物試験記録は全版でありません。v06赤タイヤ版の印刷後報告は、サポートを取り外しにくく、サポートがほぼ全部外れなかったという内容です。写真の配色からv06赤タイヤ版と高確度で一致しますが、印刷ジョブIDの直接照合はありません。正式なDR3寸法・強度試験や合格記録とは区別しています。

詳細な要望の中立要約は[人間のレビュー記録](人間のレビュー記録.md)に、印刷後報告は[品質フィードバック](evidence/print-quality-feedback.json)にまとめています。

## v04の梱包確認

v04では再梱包時の照合で保存CADのハッシュ不一致を検出しました。STEPのハッシュは一致しています。再梱包は停止しています。期待値と実測CAD SHA-256は[確認記録](evidence/v04-packaging-check.json)を参照してください。

## 版ごとの公開資料

- [v01 — 大型・一体固定輪](designs/school-bus-v01/%E7%89%88%E3%81%AE%E6%A1%88%E5%86%85.md)
- [v02 — 大型・車体／シャーシ／屋根の3部品](designs/school-bus-v02/%E7%89%88%E3%81%AE%E6%A1%88%E5%86%85.md)
- [v03 — 60mm級・赤白の3部品](designs/school-bus-v03-mini/%E7%89%88%E3%81%AE%E6%A1%88%E5%86%85.md)
- [v04 — 60mm級・幅34mm・赤白一体構造](designs/school-bus-v04-dr/%E7%89%88%E3%81%AE%E6%A1%88%E5%86%85.md)
- [v05 — v04から派生・底面2開口と支持材除去の検討](designs/school-bus-v05-dfam/%E7%89%88%E3%81%AE%E6%A1%88%E5%86%85.md)
- [v06・小型一体 — 40×20×22mm・単色・車内空間なし](designs/school-bus-v06-simple/%E7%89%88%E3%81%AE%E6%A1%88%E5%86%85.md)
- [v06・60mm空洞 — 床・座席を抜く60mm級。単色、赤屋根、赤タイヤの派生](designs/school-bus-v06-empty-inverted/%E7%89%88%E3%81%AE%E6%A1%88%E5%86%85.md)
- [v07 — 40mm級・床なし空洞・赤白・立体固定輪](designs/school-bus-v07-open-bottom/%E7%89%88%E3%81%AE%E6%A1%88%E5%86%85.md)
- [v08 — 42×21×24mm・参照写真に寄せたボンネット付き](designs/school-bus-v08-photo/%E7%89%88%E3%81%AE%E6%A1%88%E5%86%85.md)
- [v09 — 42×21×24mm・支持材なしを狙う傾斜ボンネット](designs/school-bus-v09-sloped/%E7%89%88%E3%81%AE%E6%A1%88%E5%86%85.md)
