Sunwood-ai-labs/NEKOMO/docs/人間のレビュー記録.md

# 人間のレビュー記録

会話原文は含めず、保存された要約から要望・反応・判断を整理しています。

| 対象 | 要望・反応の要約 | 採用・印刷の判断 | 記録ID |
| --- | --- | --- | --- |
| v01 → v02 | 写真と外観が違いすぎると指摘。サポート材も活用してよいと指定。 | なし | R01 |
| v02 → v03 | 使える色は赤白のみ。大きいのでサンプルの船程度に小型化してほしいと要望。v03提示には肯定的な反応を示した。 | なし | R03, R04, R11 |
| v04とv05の60mm案 | 3Dプリンターで実現できるか、内部空間をどう作るかを質問。v05の製造性検討中に半分への縮小を提案。30mm版の製作はなし。 | なし | R05, R06 |
| v05 → v06・60mm空洞 | 床なし・内部を空洞・逆さ印刷で作りやすくし、2色にしてほしいと提案。 | なし | R07, R08 |
| v06・40mmシンプル案 | より小さく簡素なバスを別案で作り、1時間以内を目指すよう要望。より簡素なバスを意図したと補足。 | なし | S01, S04 |
| v06・空洞 → 赤タイヤ | タイヤの色違いを要望。 | 採用を表明し、印刷を指示。 | R09, R10 |
| v06-simple → v07 | 上下逆・空洞・2色・タイヤの見直し・床なしを要望。 | なし | S06, S05 |
| v08 → v09 | 逆さ印刷時のボンネットを指摘。滑らかな傾斜なら支持材なしにできるのでは、という提案を明確化し検証を要求。 | v09の試し刷りを指示。 | P02, P03, P04, P05 |
| DR・保存手順 | 未実施の工程を実施すること、全DRの再実施、DR前後のデータ保存を依頼。人間自身によるDR実施とは区別。 | なし | Q04, S09, S08 |
| v06赤タイヤ版の印刷後評価 | 本人から、サポートを取り外しにくく、サポートがほぼ全部外れなかったとの報告。写真の配色から版は高確度で一致するが、印刷ジョブIDの直接照合はない。 | なし | U02 |

人間の報告はAI審査や機械記録と区別しています。印刷後報告は正式なDR3試験や合格判定ではありません。
