Sunwood-ai-labs/NEKOMO/.agents/skills/nekoneko-development-codename/SKILL.md

---
name: nekoneko-development-codename
description: ネコネコインダストリーの新しい機体・試作の開発コードネーム、型式、改名、設計リビジョンの保存を扱う。新規CAD設計や既存機体の改修を始めるとき、名前や保存先を決めるときに使う。
---

# 開発コードネームと版管理

作業対象を名前とフォルダから追跡でき、以前の設計と判断を失わない状態にする。プロジェクトルートは、このスキルフォルダから3階層上。以下のパスはルート基準。

## 名前を決める

1. `designs/` と対象のREADMEを確認し、既存の型式・コードネーム・現在の候補版を特定する。`identity.json` がある場合は現在の呼称と旧版への対応を優先し、旧版の生成設定に残る名前を現行名として報告しない。同じ機体の改修では、改名の指示がなければ既存名を引き継ぐ。
2. 新しい機体には、なじみがあり、短く発音しやすいSFメカ風の開発コードネームと短い型式を付ける。利用者はガンダムの機体開発を思わせる名前を希望しているが、既存作品の機体名を使う要件ではない。長い社名や説明文を機体名へ詰め込まない。
3. 設計を進めるために依頼なしで名付ける場合は、仮名と明記する。命名・改名そのものを任された場合は、依頼に合う呼称を決め、選んだ理由を記録する。利用者の指定を優先し、不要な候補選びや確認待ちでCAD作業を止めない。

表示ではカタカナ名を主にし、英語名は読みを添えて副次的に示す。格好よさや当初の内輪呼びだけを理由に、読みにくいラテン語・動物名を新しい既定名にしない。CARACALは読み方の説明が必要となり利用者に却下された例なので再提案しない。LYNXの既存履歴は遡って改名しない。読みやすさは人が判断し、機械検査で証明できるものとして扱わない。

会社名「ネコネコインダストリー / NEKONEKO INDUSTRIES」と機体の型式・コードネームを区別する。NEKOMOは過去資料に残る旧表記であり、現行ブランドとして新しい資料や設計名に使いません。履歴を追跡するため、既存の名前・ファイル名・識別子は変更せず保持します。命名済みの機体については、その時点の実ファイルを確認する。表示例は `リンクス（NKM-C01 LYNX）`、旧名MIO。不採用になったMIOを新しい既定名として再利用しない。型式の枝番やシリーズ規則は例から勝手に全製品へ広げない。

## 保存と改名

設計を変更する前に `docs/design-change-records.md` を読み、その保存規則とREADMEひな形を使う。

- `designs/<開発コードネーム>/r00/`、`r01/` のように同じ親へまとめる。LYNXの既存親は `designs/nkm-c01-lynx/`。
- 形状・寸法・刻印・材料・造形方向・スライス条件の変更は前版を保持して次版へ保存する。不採用案も残す。
- 各版にCAD、生成設定、書き出し、必要なスライス、証拠、manifestを対応づける。READMEへ発端、理由、前版との差、確認結果、残課題を記す。
- 改名では、表示名、保存先、参照リンク、生成スクリプトを確認する。過去の版やDR記録を一括で改名・移動しない。必要な移動を依頼されて行う場合は対応表と経緯を残し、旧名の歴史的ファイルを当時の実データとして保持する。
- 現在の名称情報（`identity.json`）と、過去CAD・印刷記録に保存された名前を区別する。改名時も旧リビジョンのファイル名や印刷ジョブ名を書き換えない。
- 親READMEで現在の候補と各版の状態を示す。旧版の検証結果を新しい版の合格としてコピーしない。
- 名前を公開・報告する前に `python tools/verify_design_identity.py <identity.json>` を実行する。必須項目、カタカナの読み、日本語主名から始まる表示名を検査するが、人にとっての読みやすさは証明しない。ローカルでの名前記録・検査は公開許可待ちで止めない。

## 完了確認

実ファイル、READMEのリンク、型式・コードネーム・版の対応、manifestのハッシュを確認する。ファイル検査と実物検証の範囲を分けて報告する。刻印やロゴも変更する場合は、隣の `nekoneko-logo-marking/SKILL.md` を併用する。命名やローカル保存は、公開・印刷を開始する指示にはならない。
