Sunwood-ai-labs/NEKOMO/.agents/skills/nekoneko-dr-review/SKILL.md

---
name: nekoneko-dr-review
description: ネコネコインダストリーの3Dプリント製バス・玩具について、DR0〜4の要求、CAD、造形工程、現物観察、使用判定を証拠付きでレビューする。家庭で可能な確認と設備が必要な試験、人間の評価とエージェントの検査を分け、版別の記録と星取表を更新するときに使う。
---

# ネコネコインダストリーのDRレビュー

このリポジトリのFreeCADからA1 miniへの試作を、対象版と証拠を特定してレビューする。家庭に試験設備がないことを前提とする。試験をできないことだけで要求・設計・工程のデータ審査を止めない。実施していない試験の結果は「なし」、使用判断は必要な証拠がそろうまで「保留」にする。

## 対象と範囲を決める

1. リポジトリ直下に`AGENTS.md`があれば読み、対象の`designs/<版>/`を特定する。v06の40 mmシンプル版、60 mm空洞版、赤タイヤ派生を混同しない。
2. 現在の依頼が「方法の整備」「データ審査」「現物報告の整理」「製作」「使用判断」のどれかを明記する。レビュー依頼を印刷、外注、子どもの試用の許可へ拡張しない。
3. `docs/バスの版一覧.md`と`docs/data/bus-agent-reviews.json`を案内に使い、実際の版の要求・CAD・3MF・最新の不具合記録を照合する。公開スナップショットより新しい人間の報告も確認し、両者の日付と根拠を残す。
4. [段階別の方法](references/stages.md)から今回のDRだけを読み、レビューする入力、確認範囲、評価基準、残る試験を決める。根拠のない荷重・回数・寸法許容差を安全基準として作らない。

## 家で試験できない場合

| 区分 | 今回できること | 結果の扱い |
| --- | --- | --- |
| データ審査 | 要求・CAD・断面・保存3MF・実G-code・材料指定・経路をエージェントが確認 | 実際に確認した範囲で判定する |
| 家庭での現物観察 | 既にある写真、人間の外観・サポート除去の報告を整理。新たな観察や測定は本人が可能な場合だけ | 「観察済み」の範囲を明記。測定や強度試験へ読み替えない |
| 設備が必要な試験 | 強度、耐久、化学特性などの未評価項目を一覧に残す | 未実施、結果なし。今回の作業範囲外でも必要性は消えない |
| 使用判断 | 試作の改善方針と、子どもへの引き渡しを別々に判断 | 証拠不足の子ども使用は保留 |

「家庭では実施できない」は「非該当」と区別する。非該当は形状・用途・適用条件から対象でないと説明できる項目に限る。本人が試験できないと伝えた後に、落下・ねじり・引張などの家庭試験を必須の宿題として戻さない。子どもに使わせて確かめる方法も提案しない。

試験を省くために、製品の対象年齢や用途を成人向け・観賞用へ勝手に変更しない。限定するのは今回レビューできる範囲であり、元の製品要求と未評価項目は保持する。

既存の製作前条件に検証片の実物除去確認が含まれる場合、未実施なら条件は未達のまま残す。その条件を免除して製作可にせず、データの改善・審査を進める。サポート経路をなくす別案も実データで確認してから判断する。

## 証拠を残してレビューする

Model the Domainの原則に従い、「レビューの実施」「判定」「証拠の種類」を別欄で記録する。[記録ひな形](assets/review-record.md)を使う。

- 実施は`未実施 / 一部実施 / 実施済み / 非該当`。判定は`未判定 / 範囲内適合 / 条件付き / 不適合 / 保留`。
- 証拠は`人間の報告 / エージェントの検査 / 機械記録`に分ける。誰が何を確認したか、対象ファイルの相対パス・SHA-256、実物がある場合の個体やジョブとの対応を記録する。
- 人間のレビューには本人の発言・記録を対応づけ、エージェントだけが述べた所見を混ぜない。出典が過去の要約だけなら「要約に基づく」と記し、本人の原文を確認したとは言わない。
- 既知の不具合を「未確認」に戻さない。v06のサポート除去NGは、別の条件での改善を実物で確認するまで解消済みにしない。写真の配色による版の推定と、ジョブIDの直接照合は分ける。
- 判定基準が未確定なら値と差を記録し、合否を作らない。保存できなかった証拠や使えなかったツールも明記する。資料を読んだだけでは、CADやG-codeを実行検査したことにしない。

確認範囲を小さくして未解決の不具合を隠さない。範囲内の全項目を確認していない場合や入力が欠けている場合は、該当項目を未実施・保留にして条件を残す。必要な試験を今回行わないことと、その試験が不要であることを区別する。

記録は`designs/<版>/reviews/DRn/<日時>/`に置く。入力のパスとハッシュを`before/`、確認結果と変更後のハッシュを`after/`、人間・機械の出典を`evidence/`、判定を`report.md`に保存する。変更しない入力はハッシュと所在の記録でよい。設計を変更する場合は変更前の原本も保存する。同じ版の以前の記録を上書きしない。

レビューで問題を見つけたら、該当するDRに戻して修正後のデータを再確認する。形状・材料・色分割・姿勢・工程が変わった場合は、影響を受ける以前の判定を再確認待ちにする。過去の試験結果を新しい版へ自動継承しない。

例えば、旧個体で除去NGが報告され、その後CADを改修した場合、旧個体の除去判定はNGのまま残す。改修版は「データを再審査、現物結果なし、改善は未実証」と別行に記録する。旧個体の不具合を改修版の実測結果として扱わない。写真だけでは版を特定できない場合、その留保も両方の記録に添える。

## 星取表と完了報告

星取表は`○ 範囲内完了 / △ 一部・条件付き / × 不適合 / 保留 / なし`とし、○は安全性や規格への適合を保証する印ではないと凡例に書く。各段階には対象と確認範囲を併記する。

| 版・派生 | 人間レビュー | DR0 要求 | DR1 設計 | DR2 工程 | DR3 現物レビュー | DR3 設備試験 | DR4 試作継続 | DR4 子ども使用 | 印刷完了 |
| --- | --- | --- | --- | --- | --- | --- | --- | --- | --- |
| 対象未指定 | なし | なし | なし | なし | なし | なし | 保留 | 保留 | なし |

印刷完了、サポート除去、外観、寸法測定、強度・化学試験は別の事実として扱う。写真や印刷完了だけで正式DR3試験の欄を○にしない。今後この手順で現物レビューを行った場合も、家庭観察だけなら`△ 家庭観察のみ`とし、設備試験は別欄に残す。過去の表へこの区分を適用するときは新しい日付の記録を追加し、以前の「正式DR3なし」を書き換えない。

Prove It Worksの原則に従い、実際の成果物と証拠を読んでから表を更新する。報告は、対象版、実施した検査、具体的な結果、残る項目、次にエージェントが進められる修正を短く伝える。設備試験の未実施を理由に、それと独立したデータ審査まで止めない。

## 補足資料

小部品や破片を設計レビューで見落とさない。対象年齢に合う玩具と保管については[こども家庭庁の案内](https://www.cfa.go.jp/policies/child-safety-actions/handbook/content-1/)を参照する。この案内は本プロジェクトの合否基準ではない。規格・法令への適合を判断する依頼では、その時点の一次資料と適用条件を別途確認する。

[サポート材のファイル検査ツール](../../../quality/support-removal-preflight.py)の引数は`--help`で確認する。ログや機器の認証情報は公開資料に転記しない。
