Sunwood-ai-labs/NEKOMO/.agents/skills/nekoneko-dr-review/assets/review-record.md

# ネコネコインダストリー DRレビュー記録

| 項目 | 内容 |
| --- | --- |
| 対象の版・派生 | 未指定 |
| DR段階・実施日 | 未指定 |
| レビューの目的・範囲 | 未指定 |
| 入力ファイル・SHA-256 | なし |
| 実物・ジョブとの対応 | なし |
| レビュー担当と役割 | 未指定 |
| 家庭で可能な確認 | 未指定 |
| 今回できない試験と理由 | 未指定 |

## 個別の確認

一行を一つの確認に使う。未実施の結果は「なし」。非該当には理由を付ける。新しい行を追加して使う。

| 確認ID・DR | 対象と方法 | 判定基準・出典 | 実施状態 | 結果・測定値 | 証拠の種類・保存先 | 判定・残る条件 |
| --- | --- | --- | --- | --- | --- | --- |
| 未指定 | 未指定 | 未指定 | 未実施 | なし | なし | 未判定 |

## 人間のレビュー

| 対象 | 人間の指摘・報告 | 発言日・保存先 | 確認できる範囲・版の照合 |
| --- | --- | --- | --- |
| 未指定 | なし | なし | 未照合 |

## 判定

| 判断の対象 | 実施状態・判定 | 根拠・残る条件 |
| --- | --- | --- |
| 今回のDRのデータ審査 | 未実施・未判定 | なし |
| DR3 家庭での現物観察 | 未実施・未判定 | なし |
| DR3 設備が必要な試験 | 未実施・未判定 | なし |
| DR4 試作継続・改修 | 未実施・保留 | なし |
| DR4 造形開始の可否 | 未実施・保留 | 製作指示と製作前条件は別途確認 |
| DR4 子どもへの使用判断 | 未実施・保留 | なし |

## 改修と再確認

不具合の事実、推定原因、修正内容、戻すDR、再確認する項目を分けて記録する。今回のレビュー対象でない段階の判定は更新しない。

## 星取表への反映

対象と確認範囲を添えて更新する。印刷完了の根拠は別に記録する。試験の実績がないときは「なし」とする。
