Sunwood-ai-labs/NEKOMO/.agents/skills/nekoneko-dr-review/references/stages.md

# DR0〜DR4のレビュー方法

この手順は、家庭用3Dプリンターで作るネコネコインダストリーの試作を、段階ごとに確認する方法を定めます。データ審査、現物観察、設備試験、使用判断を別々に記録します。

## 共通の記録方法

- 対象版・派生、実施日、担当、入力ファイルの相対パスとSHA-256を記録します。造形物がある場合は個体ID、ジョブID、材料と対応づけます。
- 「実施状態」「判定」「証拠の種類」を別欄に記録します。実施状態は「未実施／一部実施／実施済み／非該当」、判定は「未判定／範囲内適合／条件付き／不適合／保留」です。
- 証拠は「人間の報告／エージェントの検査／機械記録」に分けます。未実施は結果「なし」とし、家庭でできない項目を「非該当」にしません。
- 既存の記録は上書きしません。新しい根拠は日付を付けて追加し、既知の不具合を未確認や合格へ戻しません。v06のサポート除去NGは、別条件の実物結果で改善を確認するまでNGのままです。

## DR0 要求

**入力。** 最新の要求、用途と対象年齢、設計・工程リスク、試験計画、過去の不具合記録を集めます。

**操作。**

1. 用途、対象年齢、利用環境、要求元を照合します。未指定なら推測で補いません。
2. 各要求について、確認方法、合否条件とその出典、必要な証拠を対応づけます。利用者の要求、内部の設計目標、規格上の条件を区別します。
3. 家庭で確認できる項目と、測定器・試験設備・専門機関が必要な項目を分けます。

**証拠。** 要求一覧、根拠資料、未確定事項、実施可能な確認と設備が必要な試験の一覧を保存します。

**判定と戻し先。** 用途・年齢・要求元や条件が不明ならDR0を保留します。必要な判定条件が決まらない場合は合否を作らず、確認項目として残します。

## DR1 設計

**入力。** 保存済みのCAD、STEPやメッシュ、DR0の要求と設計リスクを使います。

**操作。**

1. 保存したCADを開き直して再計算し、ファイル名、改訂、SHA-256を記録します。未保存の画面状態を根拠にしません。
2. ソリッド数と閉じた形状、要求した一体・別体構造を確認します。代表断面で薄肉部を測り、空洞と開口が要求どおりか調べます。
3. 色領域の交差、欠損、余剰を確認します。CAD、STEP、メッシュの外形寸法を測り、尺度と相互の形状一致を照合します。許容差が資料にない場合は値を記録し、独自の合否値を足しません。

**証拠。** 再読込後の検査結果、代表断面、色領域の計算結果、寸法、各ファイルのハッシュを保存します。

**判定と戻し先。** 保存データが要求と合わない場合はDR1へ戻して設計を直します。用途や寸法要求が変わる場合はDR0へ戻します。CADの幾何だけから強度や安全性を合格にしません。

## DR2 工程

**入力。** DR1の確定ファイル、最終3MF、そこに含まれる実G-code、スライサー設定、材料ラベルと機器情報を使います。

**操作。**

1. CADの版と、最終3MF・実G-codeの内容およびSHA-256を照合します。印刷姿勢、各層、材料別経路、警告、予測時間と材料量を確認します。
2. PLAに支持経路がある場合は、接触界面に専用Support for PLAを明示指定した経路を確認します。装着済みという事実だけでなく、界面で専用材が押し出され、本体に専用材が使われていないことを確認します。最終3MFに対するquality/support-removal-preflight.pyの検査結果を保存します。実行前に実在するパスと --help を確認します。
3. 支えの取り出す方向と工具の通り道、窓枠や屋根端を傷める経路を確認します。薄肉部や色境界の代表層で、隣接層との接合が経路に含まれるかを見ます。
4. 材料の品番とノズル温度の設定を、材料資料、プロファイル、機器の対応条件と照合します。G-codeの最高温度を本体全体の造形温度と読み替えません。実際に送信する際は現在のAMS材料と物理スロットを確認し、プロジェクト内の材料番号と混同しません。A2を固定の割当として扱いません。今回送信しない場合は実機の割当を「送信前に要確認」として残し、プリンター操作を始めません。

**証拠。** 最終3MFとG-codeのハッシュ、スライス設定、経路検査とpreflightの結果、材料品番、温度条件、AMSの実割当を記録します。時間・材料量はスライサー予測と造形後の実績を別々に残します。

**判定と戻し先。** 経路や設定に問題があればDR2へ戻し、形状・姿勢の問題ならDR1へ戻します。preflightや警告なしは現物の除去成功を示しません。検証片の実物除去ゲートが未実施なら、その条件は未達のままです。データ審査は記録できますが、製作可とは判定しません。

## DR3 現物レビューと設備試験

**入力。** 既にある試作品、対象ジョブとファイルの対応記録、利用者から既に得た写真や報告を使います。新しい家庭試験は前提にしません。

**操作。**

1. 人間が外観を見た記録やサポート除去の報告があれば、観察した面・方法・結果を記録します。報告がなければ現物レビューは未実施です。
2. 写真では写っている範囲の外観だけを記録します。写真だけで荷重・強度や除去のしやすさを実証済みとは判定しません。人間の測定値が既にある場合は、測定器と条件を添えて記録します。新たな測定は必須にしません。
3. 強度、耐久、化学特性など設備を要する試験は、家庭観察と別欄に並べます。必要な設備や専門評価がまだなければ「未実施」、結果「なし」、理由「家庭設備がない／今回の範囲外」と記録します。

**証拠。** 写真は撮影者、日付、対象面、版との照合状態を記録します。人間の報告は発言者と報告日を、人間の報告として保存します。機械試験は設備、試料、条件、実測値が揃った記録だけを根拠にします。

**判定と戻し先。** 外観写真や印刷完了だけで正式DR3の試験を合格にしません。既存のサポート除去失敗は不適合として保持します。必要な設備試験は「非該当」にせず未実施のまま残し、対象、材料、試料条件など外部評価に渡す項目を列挙できます。外部への発注や危険な破壊試験、子どもに使わせる確認は行いません。

## DR4 使用判断

**入力。** DR0〜DR3の記録、未解決事項、材料・ジョブの追跡情報、最新の不具合記録を使います。過去の試験結果を新しい版へ自動継承しません。

**操作。**

1. 「データ審査の完了」「設計の改修・審査継続」「造形可否」「子どもへの使用可否」を分けて決めます。
2. 各判断の根拠、残る条件、未実施の設備試験を記録します。安全項目を免除したり、審査済みという理由だけで子ども使用を承認したりしません。
3. 専門機関の評価が必要なら、相談用の項目一覧と必要資料をまとめます。発注はしません。

**証拠。** 判断ごとに参照したDR記録、未解決条件、決定者を保存します。新しい家庭観察があれば日付付きで追加し、従来の正式DR3「なし」は書き換えません。

**判定と戻し先。** 設計・データの審査は、その範囲の根拠が揃えば設備試験未実施でも完了できます。未評価の安全項目が残る子ども使用は保留します。サポート除去ゲートなど製作前条件が未達なら、造形可や再印刷可にはしません。試作継続はデータの改善や次版計画を指し、印刷開始の承認ではありません。人間から製作指示があっても、既存の製作前条件が未達なら印刷しません。改修が必要な項目をDR0〜DR3の該当段階へ戻します。

## 参照資料

- [v04のDR判定記録](../../../../docs/designs/school-bus-v04-dr/quality/preprint-review/dr-review.md)
- [v04の設計審査・試験計画](../../../../docs/designs/school-bus-v04-dr/quality/preprint-review/test-plan.md)
- [v06シンプル版の試験計画](../../../../docs/designs/school-bus-v06-simple/quality/preprint-review/test-plan.md)
- [バスのエージェントレビュー一覧](../../../../docs/data/bus-agent-reviews.json)
- 公開用の[不具合報告](../../../../docs/evidence/print-quality-feedback.json)を参照します。ローカルに原本 `quality/print-failure-20261110/過去トラ-NEKOMO-TR-001.md` があれば併せて読み、原本を参照できなかった場合はその旨を記録します。
