Sunwood-ai-labs/NEKOMO/docs/designs/school-bus-v01/版の案内.md

# v01の案内

大型・一体固定輪

記録の確認日: 2026-11-10。未印刷。ブリッジ検証片を準備。

全版の一覧（ローカル保存）

## CADと印刷データ

- [cad/nekomo-school-bus-v01.FCStd](../../../designs/school-bus-v01/cad/nekomo-school-bus-v01.FCStd)
- [print/nekomo-school-bus-v01-two-color-sliced.3mf](../../../designs/school-bus-v01/print/nekomo-school-bus-v01-two-color-sliced.3mf)
- [print/nekomo-school-bus-v01-red-prototype-sliced.3mf](../../../designs/school-bus-v01/print/nekomo-school-bus-v01-red-prototype-sliced.3mf)
- [cad/rear-window-bridge-coupon.FCStd](../../../designs/school-bus-v01/cad/rear-window-bridge-coupon.FCStd)

## 人間のレビュー・判断

本人発言と出典の記録（ローカル保存）

- 設計フィードバック。参照写真との外観差を指摘。対象・反映先はv01 → v02。根拠はR01。

完成品の品質に対する人間のレビューはなしです。

## エージェントのレビュー・検証記録

DR1は条件付きの設計方針確認。DR2はCAD・メッシュ・スライス確認。DR3現物試験は未実施、DR4は未判定。

### v01・大型一体

| DR段階 | 星取 | 元の判定 |
| --- | :---: | --- |
| DR0 要求 | なし | なし |
| DR1 設計 | △ | 条件付き |
| DR2 工程 | △ | データ確認 |
| DR3 現物試験 | なし | なし |
| DR4 使用判定 | なし | なし |

実施した検査は次のとおりです。

- 一体構造・固定輪の設計方針を審査。
- CADの有効性、STLの閉鎖性と接続、単色・2色のスライスを確認。
- リア窓上端の長い橋渡しを検出し、検証片を用意。現物試験はなし。

### 関連する検証・実機記録

- [README.md](README.md)
- [safety-review.md](safety-review.md)
- [evidence/after-slice-review.md](evidence/after-slice-review.md)

## 配布物

- 当時の配布ZIP（ローカル保存）

配布ZIPは整理前の内容を保持しています。ZIP内のhandoffやハッシュは、その配布時点のファイルに対応します。

## 保存場所の扱い

このフォルダがこの版の保存場所です。旧候補、失敗記録、DR前後の証跡は元の場所に残しています。
案内にある印刷データには未印刷のものも含まれます。データ審査と現物試験の結果は各記録で区別しています。
