Sunwood-ai-labs/NEKOMO/docs/designs/school-bus-v01/evidence/after-slice-review.md

# スライス後レビュー

**判定：検証する。** リア窓上端の約46 mmの橋渡しを、実物で確認する。

## 根拠

- CADは有効な閉じた1ソリッドです。全体STLも1コンポーネントで、境界エッジと非多様体エッジはありません。ゴールド色とココア色の領域は重ならず、体積誤差0.0108 mm³は許容値0.05 mm³以内です。
- 2色3MFの色コードは指定値です。スライスは537層、警告なし、サポートなしでした。モデルはX=17.49〜163.01 mm、Y=54.72〜125.28 mm。ワイプタワーを含む範囲もX=11.79〜163.01 mm、Y=54.72〜165.77 mmで、A1 miniの180×180 mm造形面内です。
- G-codeの最長の`FEATURE: Bridge`押出移動は45.927 mm、Z=69.16 mmです。位置はX=163.031 mm、Y=67.123〜113.050 mmで、設計寸法48 mmのリア窓上端に対応します。これはブリッジ指定の直線移動長であり、実際のたわみや品質の測定値ではありません。サポート押出は0回です。
- リア窓の局所クーポンを同じ0.16 mm積層条件でスライスすると、Z=33.16 mmに45.927 mmのブリッジ移動が再現されました。250層、10.24 g、予測49分25秒、警告とサポートなしです。局所スライスは形状の再現を確認しますが、実際の造形品質は確認しません。
- 全体2色スライスの予測は22時間18分53秒、361.45 g、フィラメント切替234回です。単色版は14時間15分19秒、275.51 g、切替0回です。2色化による差は約8時間3分34秒、85.94 gです。材料量はスライサーの予測値です。

## 次の確認

リア窓クーポンを予定する材料と条件で造形し、ブリッジの垂れと欠けを確認してから、全体造形へ進むか判断します。このレビューではプリンターへの送信と実印刷を行っていません。3歳未満向けの玩具安全適合も評価していません。

## 根拠ファイル

- `evidence/geometry-report.json`、`evidence/mesh-report.json`
- `evidence/slice-two-color.json`、`evidence/slice-single-color.json`
- `evidence/bridge-comparison.json`、`evidence/slice-rear-window-coupon.json`、`evidence/inspection-rear-window-coupon.json`
- `print/nekomo-school-bus-v01-two-color-sliced.3mf`、`print/rear-window-bridge-coupon-sliced.3mf`
