Sunwood-ai-labs/NEKOMO/docs/designs/school-bus-v01/README.md

# NEKOMO スクールバスの設計と印刷前データ

参照画像のスクールバスを、屋根・座席・固定タイヤがつながる一体構造に具体化しました。対象は家庭で使う玩具で、3歳未満向けを目標に検討しています。今回のデータは試作評価用です。プリンターへの送信と印刷は行っていません。

## 現在のモデル

画像はローカル保存

CADから求めた外形は154.5 × 72 × 86 mmです。ヘッドライトと屋根の張り出しを含むため、車体長150 mmより全長が長くなっています。側壁の設計値は5 mm、側面窓間の柱は10 mmです。窓角はR5 mm、屋根裏の斜面は垂直から45度、中央の平坦な橋渡し部は20 mmとしました。

画像の黄色と茶色を2色にまとめています。ライトとハブは車体と同じ黄色、尾灯は茶色です。車輪、ハブ、ライト、座席、屋根は、取り付ける別体部品ではありません。2色のCAD領域を同時に造形して一つの形にする構成です。ねじ、磁石、接着剤、回転する車軸は設けていません。

座席は3列の一体ベンチと左右の背もたれです。側壁との間に深い4 mm幅の隙間が残る初期案を見直し、ベンチを客室幅に広げました。中央の背もたれ間には上に開いた溝が残るため、窓や座席周辺の開口とともに現物で確認する対象です。

## 成果物

| 用途 | ファイル |
| --- | --- |
| 編集できるFreeCAD文書 | [nekomo-school-bus-v01.FCStd](../../../designs/school-bus-v01/cad/nekomo-school-bus-v01.FCStd) |
| 他のCADで扱う形状 | [STEP](../../../designs/school-bus-v01/exports/nekomo-school-bus-v01.step) |
| 一体形状の単色メッシュ | [STL](../../../designs/school-bus-v01/exports/nekomo-school-bus-v01-solid.stl) |
| 三面図 | CAD投影図 SVG（ローカル保存） |
| 配色を含む元のプロジェクト | 2色の未スライス3MF（ローカル保存） |
| 2色の印刷経路を含むファイル | [2色版のスライス済み3MF](../../../designs/school-bus-v01/print/nekomo-school-bus-v01-two-color-sliced.3mf) |
| 赤色で形状を試作するファイル | [単色試作版のスライス済み3MF](../../../designs/school-bus-v01/print/nekomo-school-bus-v01-red-prototype-sliced.3mf) |
| 後ろ窓の橋渡しを先に確認する検証片 | 局所検証片のスライス済み3MF（ローカル保存） |

## CADとメッシュの確認結果

FreeCAD MCPで形状を生成し、閉じた有効な1個のソリッドであることを確認しました。配色領域には体積の重複がなく、領域の体積合計はCADの数値積分に対して設定した許容差内で全体の体積と一致しました。

STLはCADとは別のスクリプトで検査しました。全体STLは一つにつながり、境界エッジ、非多様体エッジ、面積がゼロの三角形は検出されませんでした。2色の領域は複数のソリッドを含みますが、組み合わせた全体は一体です。色の領域が分かれていることと、完成物を別体部品に分けることは区別します。

根拠はevidence/geometry-report.json（ローカル保存）とevidence/mesh-report.json（ローカル保存）に保存しています。STLの検査は `python verify_meshes.py` で再実行できます。

FreeCADの文書にはスケッチ、押し出し、角の丸め、切り取り、融合などの元の形状を残しています。寸法表は入力値の記録であり、表を書き換えるだけですべての寸法が連動する構成ではありません。形状の編集はFreeCADの各フィーチャー、またはdesign-spec.jsonとbuild_bus.pyによる新しいバージョンの生成で行います。ビルドスクリプトは既存の成果物を上書きしません。

## スライスの結果

共通の試作条件はA1 mini、0.4 mmノズル、Bambu PLA Basicのプロファイル、積層ピッチ0.16 mm、外周5周、充填率30%、支持材なし、組み立てた姿勢のまま直立造形です。各版1回のスライス結果で、実印刷時間や実使用量ではありません。

| 版 | 予測時間 | 予測材料合計 | 色替え |
| --- | --- | --- | --- |
| 黄色と茶色の2色版 | 22時間18分53秒 | 361.45 g | 234回 |
| 赤い単色試作版 | 14時間15分19秒 | 275.51 g | 0回 |
| 後ろ窓だけの検証片 | 49分25秒 | 10.24 g | 0回 |

2色版の本体分は約278.63 gです。材料合計には色替えに伴う材料とタワーなどを含みます。本体分と合計を足し合わせません。色替えとパージが追加負担になるため、形状の初回評価には単色版を選ぶ方法があります。2色版は希望の配色を確認するために残しています。

2色版は最初のスライスで、色替え用タワーの既定位置が造形範囲外になるエラーがありました。タワーをX15・Y140 mmに移して再スライスし、成功を確認しました。最終の両ファイルは537層で、スライサーの警告欄は空です。印刷ファイル検査で、A1 mini、0.4 mmノズル、PLA、Textured PEI Plateに対応するデータであることを確認しています。

スライスとファイル検査の根拠はevidence内のslice-two-color.json、slice-single-color.json、inspection-two-color.json、inspection-red-prototype.jsonです。屋根裏、前面窓、窓上の橋渡しについては、綺麗に造形できるかを現物で確認する必要があります。警告がないことを橋渡しの成功保証にはしません。

## 最初に確かめる後ろ窓の橋渡し

独立した経路レビューで、2色版の後ろ窓上端に約45.9 mmのブリッジ押し出し移動が見つかりました。CAD上の屋根中央20 mmという値だけでは、この経路を説明できません。後ろ窓の仕上がりが未確認のまま、22時間の全体試作に進むことは勧めません。

そこで、完成CADの後部から実形状を切り出した、約10 × 66 × 40 mmの検証片を用意しました。造形姿勢、材料プロファイル、層高、外周数、充填率、支持材なしという条件をそろえています。予測は49分25秒、10.24 gです。これはおもちゃではなく、工程を確認するための試験片です。

G-codeの比較でも、検証片に同じ約45.9 mmの直線ブリッジ押し出し移動が含まれることを確認しました。比較結果はevidence/bridge-comparison.jsonに保存しています。押し出し移動の長さは実際のたわみや支持されない長さを測った値ではありません。

検証片で後ろ窓上の垂れ、糸の未接着、枠の形状、窓の開口を確認してから、本体の試作へ進む方針です。局所片が綺麗に出ても、本体全体の強度や乳幼児向け安全性を確認したことにはなりません。検証片の形状とスライスの根拠もevidence内に保存しています。

## 送信前に残る確認

1. まず後ろ窓の検証片を評価し、本体に進む際は単色か2色かを製造側で選ぶ。希望配色の黄色・茶色フィラメントは、今回の装填確認では見つかっていません。
2. 実際に使う材料の品番・色・ロット、ノズルとプレート、材料の乾燥・保管状態を確認する。材料を替える場合は必要に応じて再スライスする。
3. 試作を開始する時点で、プリンターの状態とプレートが空であることを確認する。今回のファイル検査は実機の準備状態を確認するものではありません。
4. 屋根裏と前面窓の橋渡し、表面、バリ、座席や車輪の根元、色境界の接着状態を試作品で確認する。
5. 子どもに渡す前に、[設計審査と現物試験計画](safety-review.md)に沿って、破損後の小片、鋭利部、開口部、材料、清掃と劣化を評価する。対象年齢の下限と適用条項も確定する。

今回完了したのはCADと試作データの準備です。3歳未満の子どもが使用できるという判定は保留です。製造チャットへの引き継ぎ情報とファイルのハッシュはhandoff.jsonに保存します。

## 関連記録

要求仕様はrequirements.md、設計案の比較はdesign-decision.md、入力寸法はdesign-spec.json、実際の設計生成はbuild_bus.pyです。経路の独立確認結果はevidence/after-slice-review.mdに保存します。

進捗ダッシュボード（ローカル保存）と製造予定のチャット（ローカル保存）を参照できます。
