Sunwood-ai-labs/NEKOMO/designs/school-bus-v02/exports/school-bus-v02-roof-assembled.stl

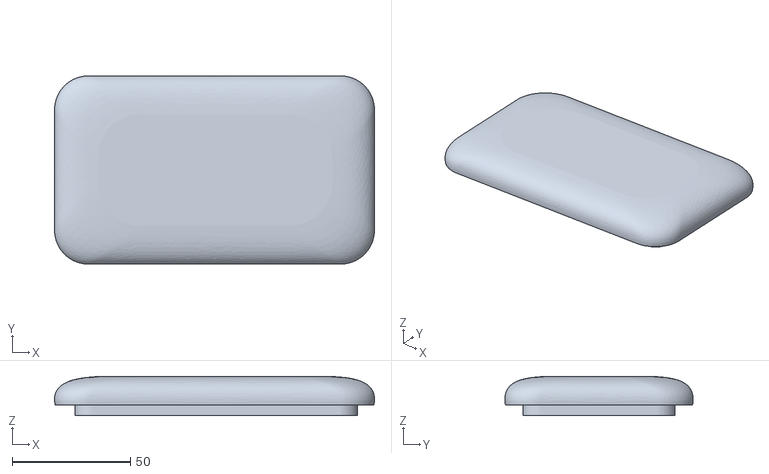
[picture p75: CAD file, 2026-11-10]
designs/school-bus-v02/exports/school-bus-v02-roof-assembled.stl
135.0 x 79.5 x 16.5
