Sunwood-ai-labs/NEKOMO/designs/school-bus-v03-mini/exports/school-bus-v03-body-assembled.stl

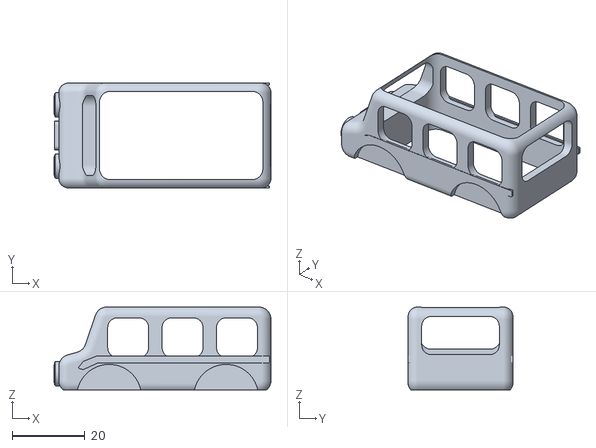
[picture p76: CAD file, 2026-11-10]
designs/school-bus-v03-mini/exports/school-bus-v03-body-assembled.stl
59.7 x 29.0 x 22.8
