Sunwood-ai-labs/NEKOMO/designs/school-bus-v02/exports/school-bus-v02-assembly.step

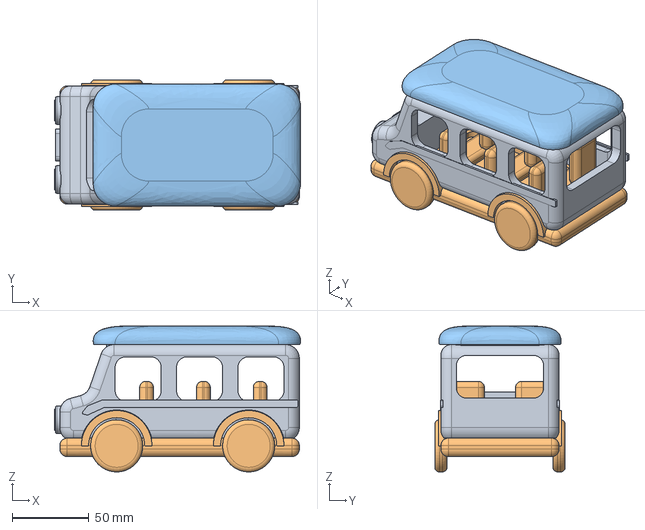
[picture p77: CAD file, 2026-11-10]
designs/school-bus-v02/exports/school-bus-v02-assembly.step
160.3 x 85.0 x 95.0 mm
