Sunwood-ai-labs/NEKOMO/designs/school-bus-v03-mini/exports/school-bus-v03-assembly.step

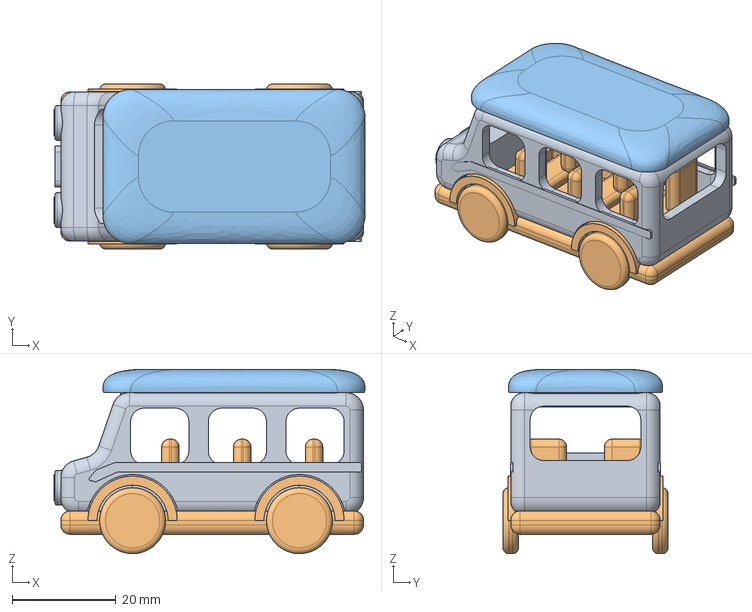
[picture p78: CAD file, 2026-11-10]
designs/school-bus-v03-mini/exports/school-bus-v03-assembly.step
60.0 x 31.8 x 35.6 mm
