Sunwood-ai-labs/NEKOMO/designs/school-bus-v07-open-bottom/candidate-r00/exports/school-bus-r00-assembled.step

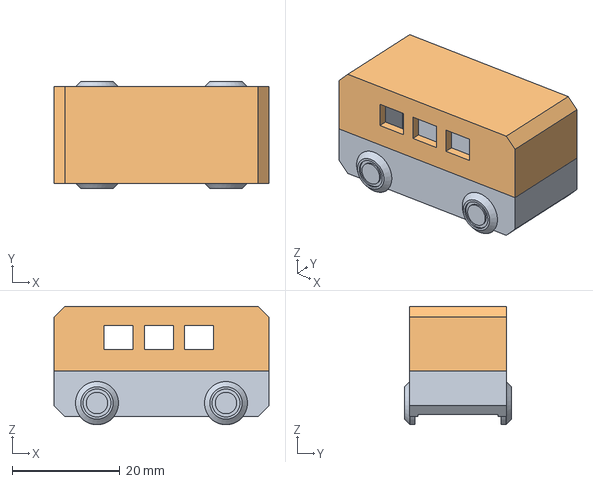
[picture p79: CAD file, 2026-11-10]
designs/school-bus-v07-open-bottom/candidate-r00/exports/school-bus-r00-assembled.step
40.0 x 20.0 x 22.0 mm
