Sunwood-ai-labs/NEKOMO/designs/school-bus-v02/exports/school-bus-v02-chassis-assembled.stl

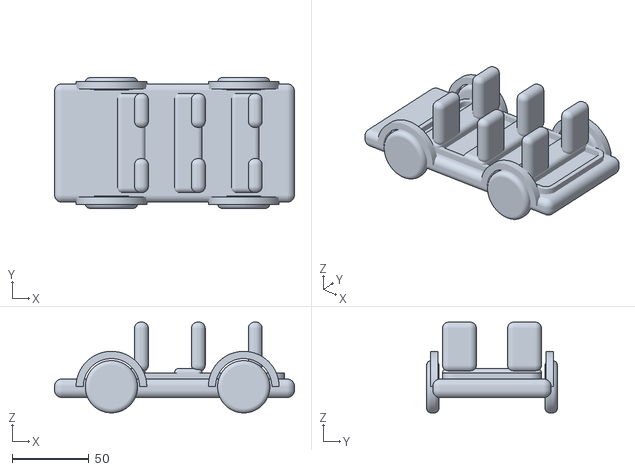
[picture p80: CAD file, 2026-11-10]
designs/school-bus-v02/exports/school-bus-v02-chassis-assembled.stl
156.0 x 85.0 x 59.0
