Sunwood-ai-labs/NEKOMO/designs/school-bus-v03-mini/exports/school-bus-v03-chassis-assembled.stl

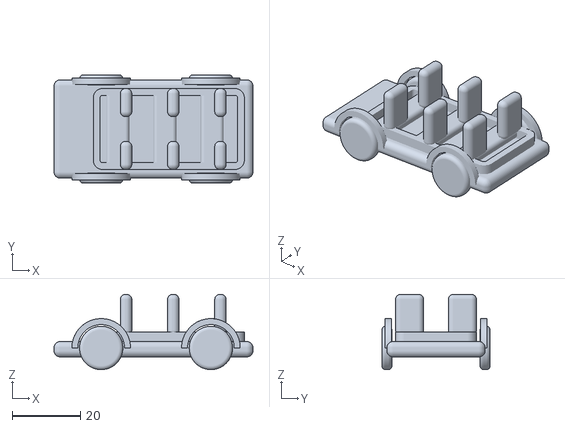
[picture p81: CAD file, 2026-11-10]
designs/school-bus-v03-mini/exports/school-bus-v03-chassis-assembled.stl
58.4 x 31.8 x 22.1
