Sunwood-ai-labs/NEKOMO/designs/school-bus-v02/exports/school-bus-v02-body-assembled.stl

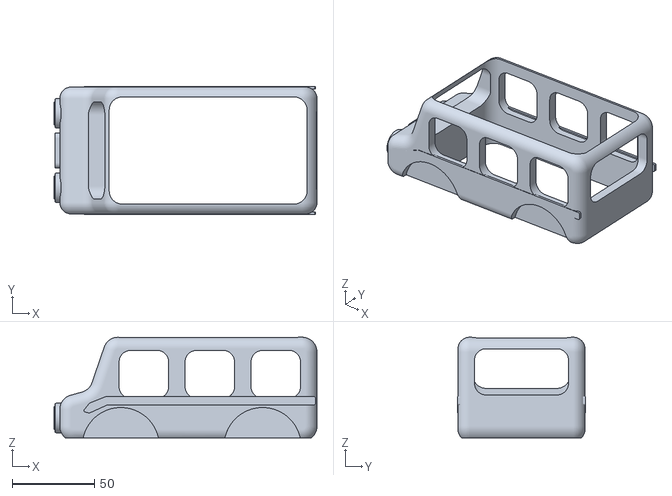
[picture p82: CAD file, 2026-11-10]
designs/school-bus-v02/exports/school-bus-v02-body-assembled.stl
159.5 x 77.5 x 61.0
