Sunwood-ai-labs/NEKOMO/designs/school-bus-v03-mini/exports/school-bus-v03-roof-assembled.stl

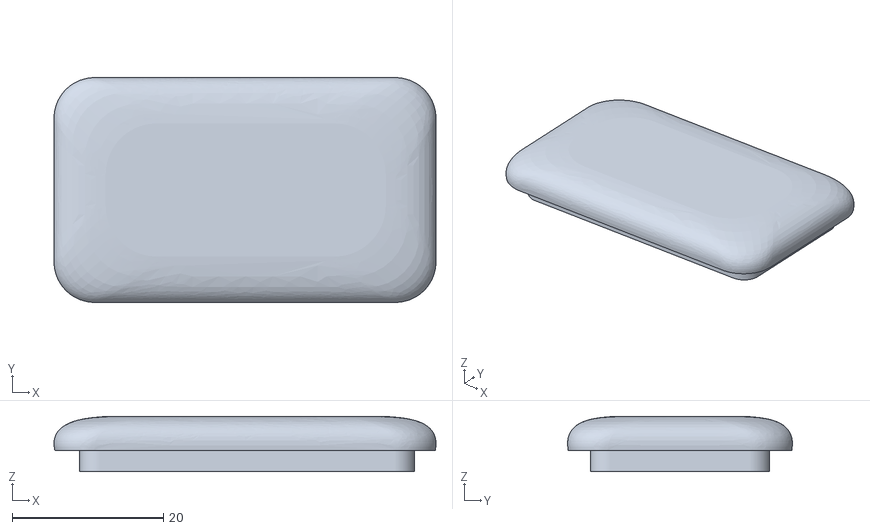
[picture p83: CAD file, 2026-11-10]
designs/school-bus-v03-mini/exports/school-bus-v03-roof-assembled.stl
50.6 x 29.8 x 7.30
