Sunwood-ai-labs/NEKOMO/designs/school-bus-v08-photo/exports/whole-inverted.stl

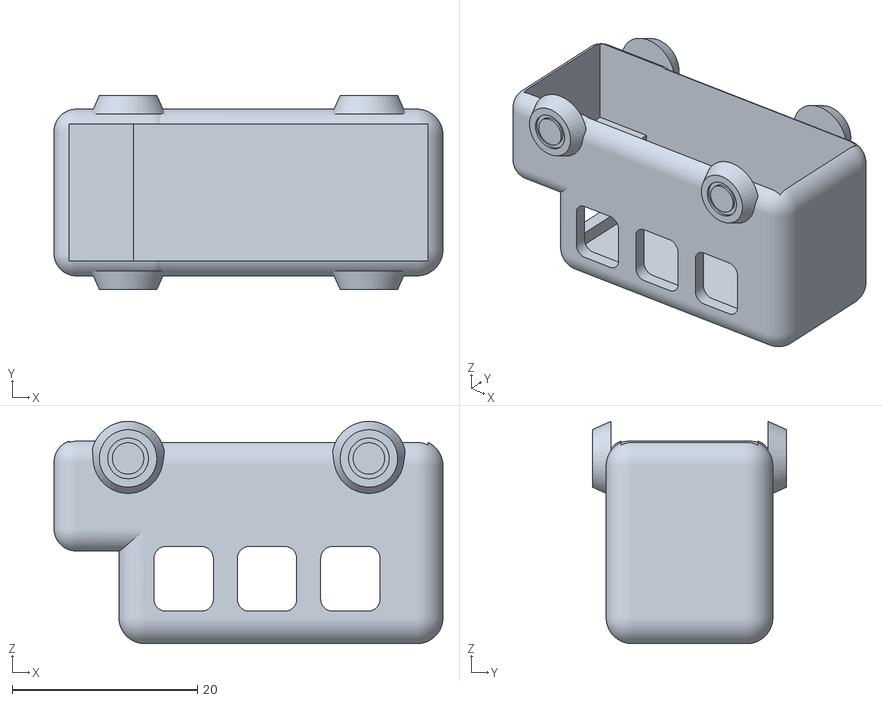
[picture p84: CAD file, 2026-11-10]
designs/school-bus-v08-photo/exports/whole-inverted.stl
42.0 x 21.0 x 24.0
