Sunwood-ai-labs/NEKOMO/designs/school-bus-v09-sloped/exports/whole-inverted.stl

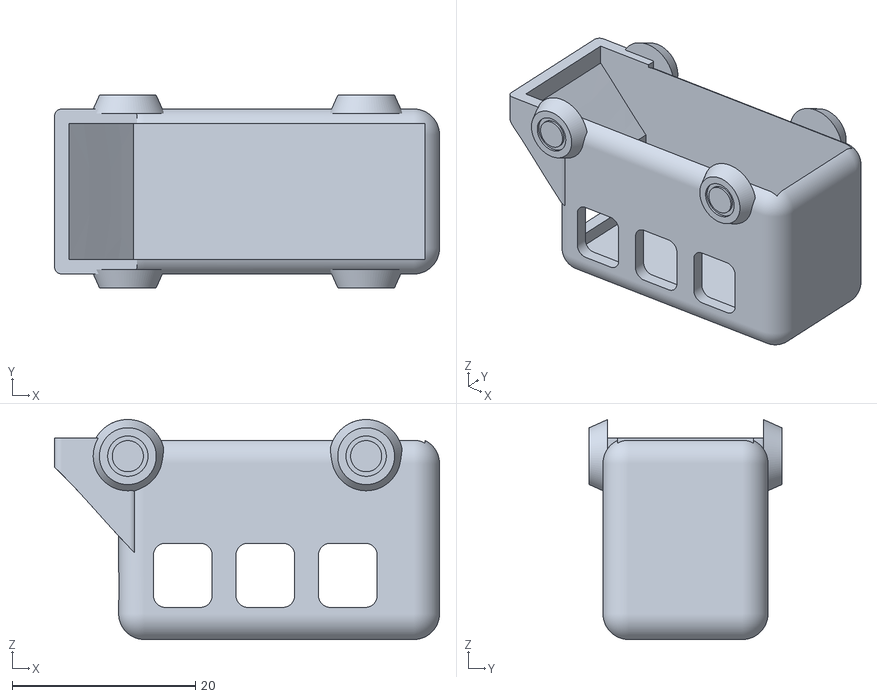
[picture p85: CAD file, 2026-11-10]
designs/school-bus-v09-sloped/exports/whole-inverted.stl
42.0 x 21.0 x 24.0
