Sunwood-ai-labs/NEKOMO/designs/school-bus-v02/cad/nekomo-school-bus-v02.FCStd

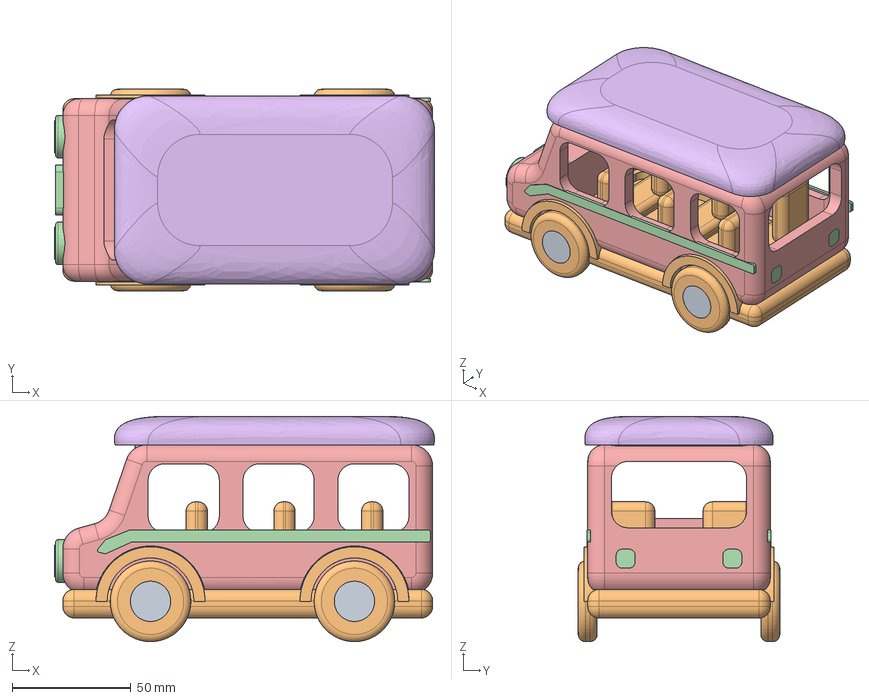
[picture p86: CAD file, 2026-11-10]
designs/school-bus-v02/cad/nekomo-school-bus-v02.FCStd
160.3 x 85.0 x 95.0 mm
Ivory hub colour regions
Cocoa chassis colour region
Ivory lamp regions
Cocoa without ivory
Gold body region
Separate roof with broad locating skirt
