Sunwood-ai-labs/NEKOMO/designs/school-bus-v03-mini/cad/nekomo-school-bus-v03.FCStd

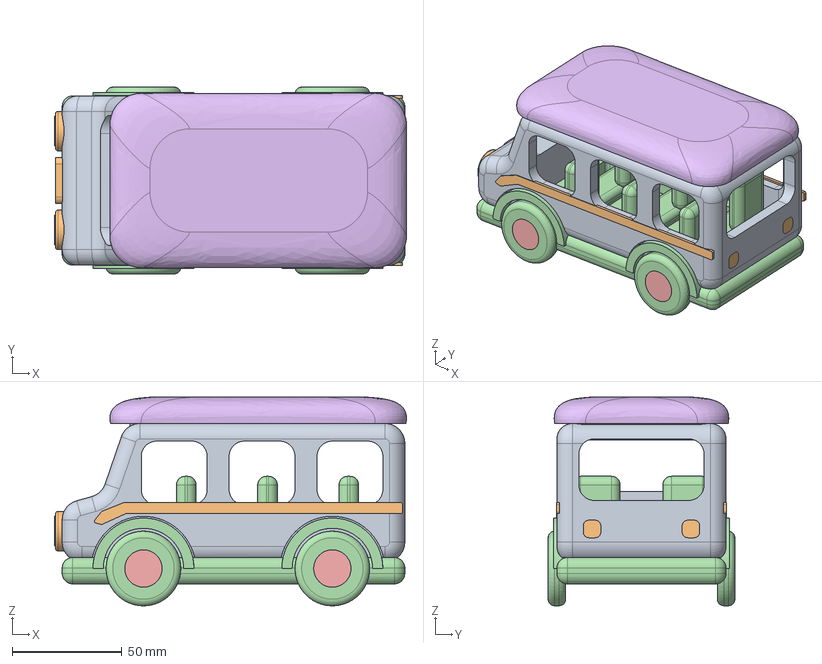
[picture p87: CAD file, 2026-11-10]
designs/school-bus-v03-mini/cad/nekomo-school-bus-v03.FCStd
160.3 x 85.0 x 95.0 mm
Gold body region
Cocoa without ivory
Ivory lamp regions
Cocoa chassis colour region
Ivory hub colour regions
Separate roof with broad locating skirt
