Sunwood-ai-labs/NEKOMO/designs/school-bus-v04-dr/cad/nekomo-school-bus-v04.FCStd

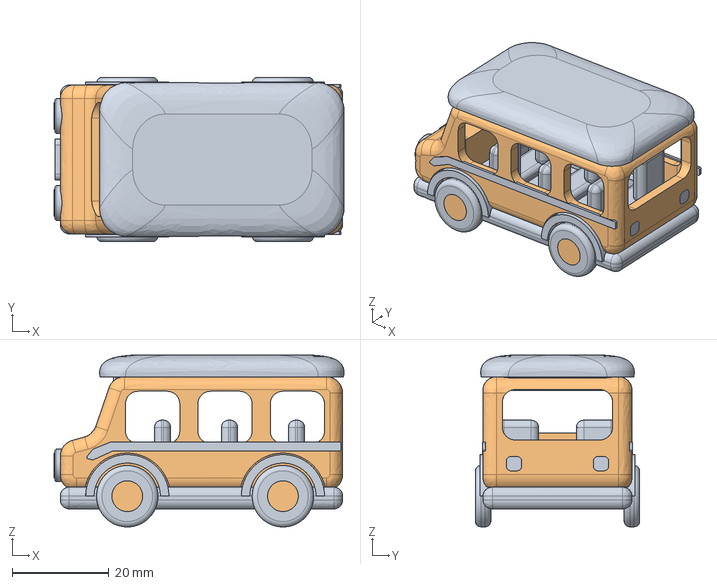
[picture p88: CAD file, 2026-11-10]
designs/school-bus-v04-dr/cad/nekomo-school-bus-v04.FCStd
60.0 x 34.0 x 35.6 mm
Red color regions, clipped to physical bus
White color regions, exact physical remainder
