Sunwood-ai-labs/NEKOMO/designs/school-bus-v04-dr/exports/bus-v04-red.stl

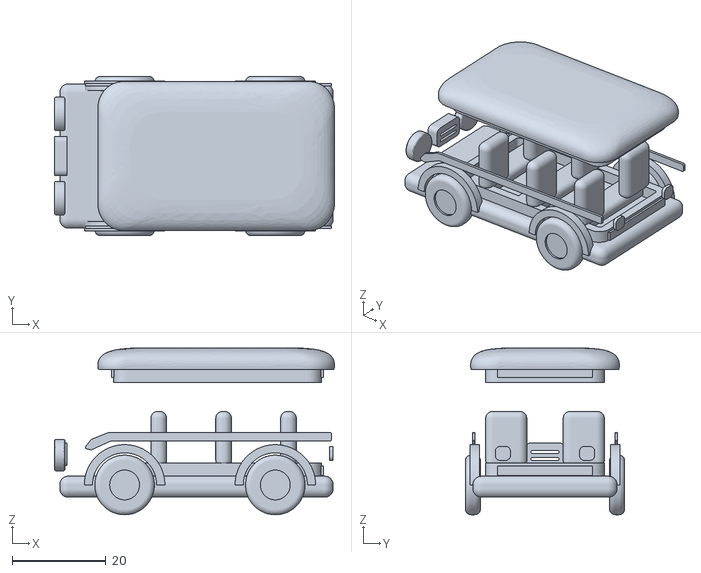
[picture p89: CAD file, 2026-11-10]
designs/school-bus-v04-dr/exports/bus-v04-red.stl
59.8 x 34.0 x 35.6
