Sunwood-ai-labs/NEKOMO/designs/school-bus-v05-dfam/coupon/v04-middle-window-support-removal-coupon.FCStd

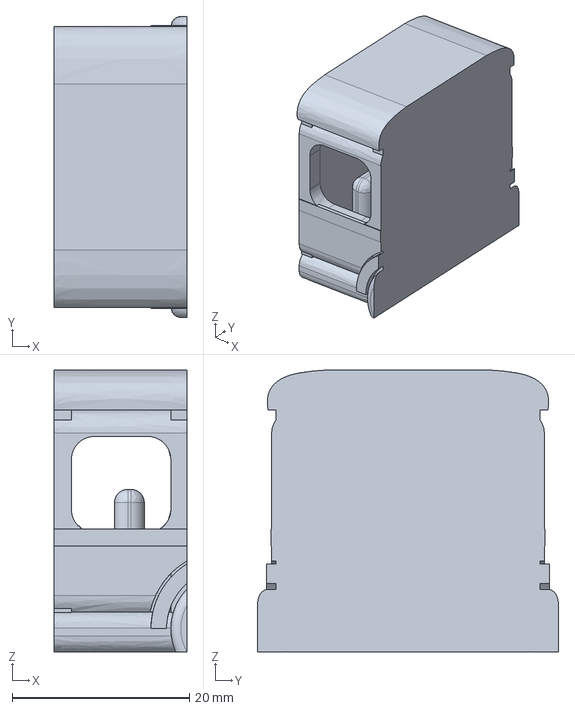
[picture p90: CAD file, 2026-11-10]
designs/school-bus-v05-dfam/coupon/v04-middle-window-support-removal-coupon.FCStd
15.0 x 34.0 x 31.8 mm
