Sunwood-ai-labs/NEKOMO/designs/school-bus-v06-empty-inverted/cad/nekomo-school-bus-v06-empty-inverted.FCStd

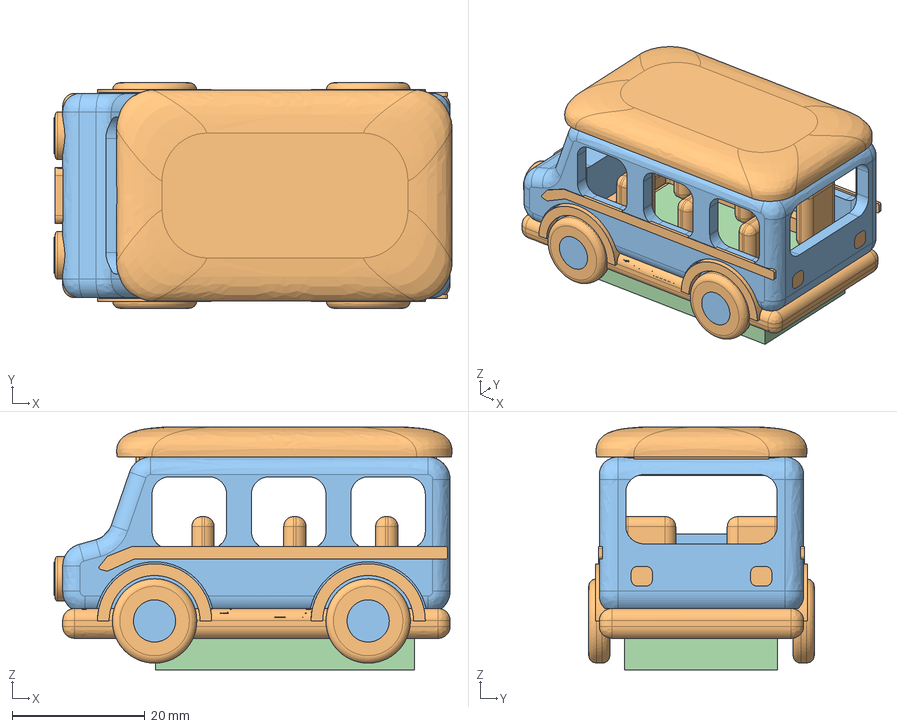
[picture p91: CAD file, 2026-11-10]
designs/school-bus-v06-empty-inverted/cad/nekomo-school-bus-v06-empty-inverted.FCStd
60.0 x 34.0 x 36.6 mm
Floorless, seatless one-piece bus
Red regions clipped to candidate
White regions clipped to candidate
Open underside floor cutter
