Sunwood-ai-labs/NEKOMO/designs/school-bus-v06-empty-inverted/corrected/nekomo-v06-clear-cabin.FCStd

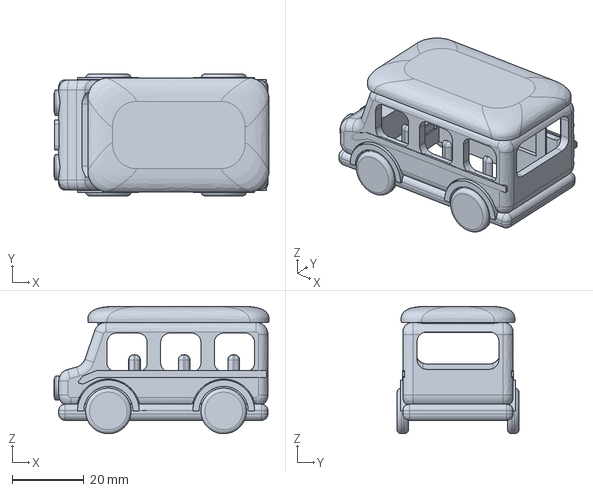
[picture p92: CAD file, 2026-11-10]
designs/school-bus-v06-empty-inverted/corrected/nekomo-v06-clear-cabin.FCStd
60.0 x 34.0 x 35.6 mm
