Sunwood-ai-labs/NEKOMO/designs/school-bus-v06-empty-inverted/two-color-red-tyres/red-roof-tyres-inverted.stl

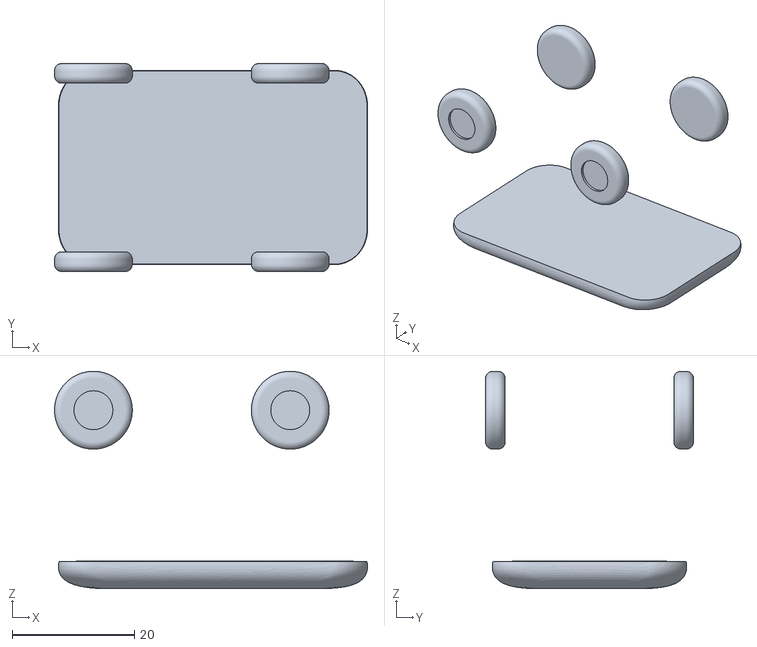
[picture p93: CAD file, 2026-11-10]
designs/school-bus-v06-empty-inverted/two-color-red-tyres/red-roof-tyres-inverted.stl
51.2 x 34.0 x 35.6
