Sunwood-ai-labs/NEKOMO/designs/school-bus-v06-empty-inverted/two-color/nekomo-v06-red-white.FCStd

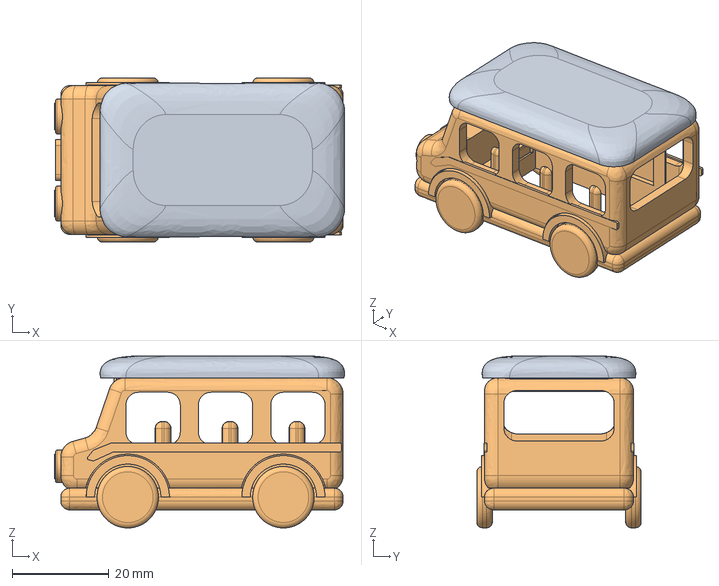
[picture p94: CAD file, 2026-11-10]
designs/school-bus-v06-empty-inverted/two-color/nekomo-v06-red-white.FCStd
60.0 x 34.0 x 35.6 mm
RedRoof
WhiteBody
