Sunwood-ai-labs/NEKOMO/designs/school-bus-v06-simple/candidate-r00/cad/school-bus-r00.FCStd

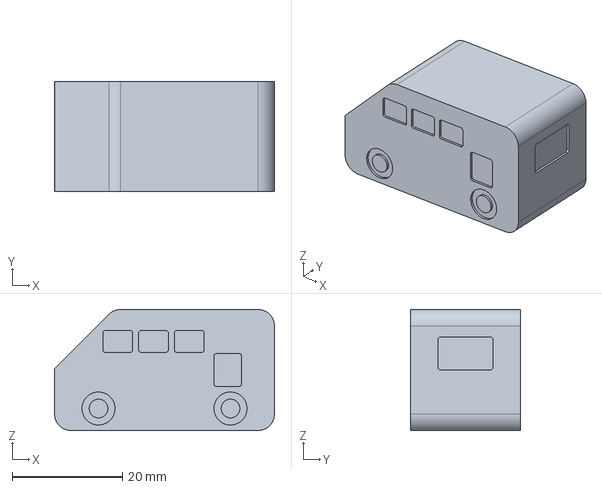
[picture p95: CAD file, 2026-11-10]
designs/school-bus-v06-simple/candidate-r00/cad/school-bus-r00.FCStd
40.0 x 20.0 x 22.0 mm
