Sunwood-ai-labs/NEKOMO/designs/school-bus-v06-simple/candidate-r01/cad/final-bus-r01.FCStd

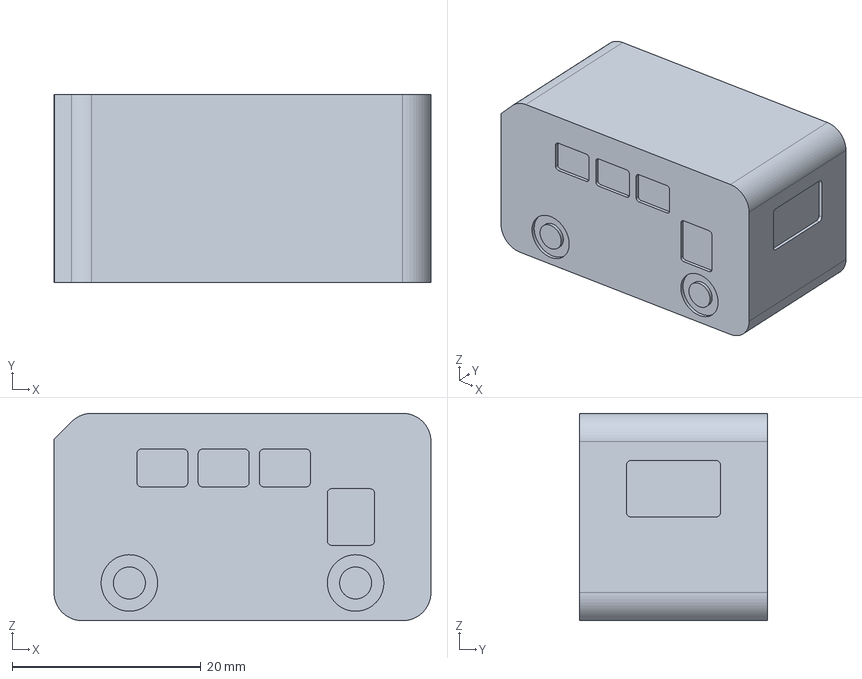
[picture p96: CAD file, 2026-11-10]
designs/school-bus-v06-simple/candidate-r01/cad/final-bus-r01.FCStd
40.0 x 20.0 x 22.0 mm
