Sunwood-ai-labs/NEKOMO/designs/school-bus-v07-open-bottom/candidate-r00/cad/school-bus-r00.FCStd

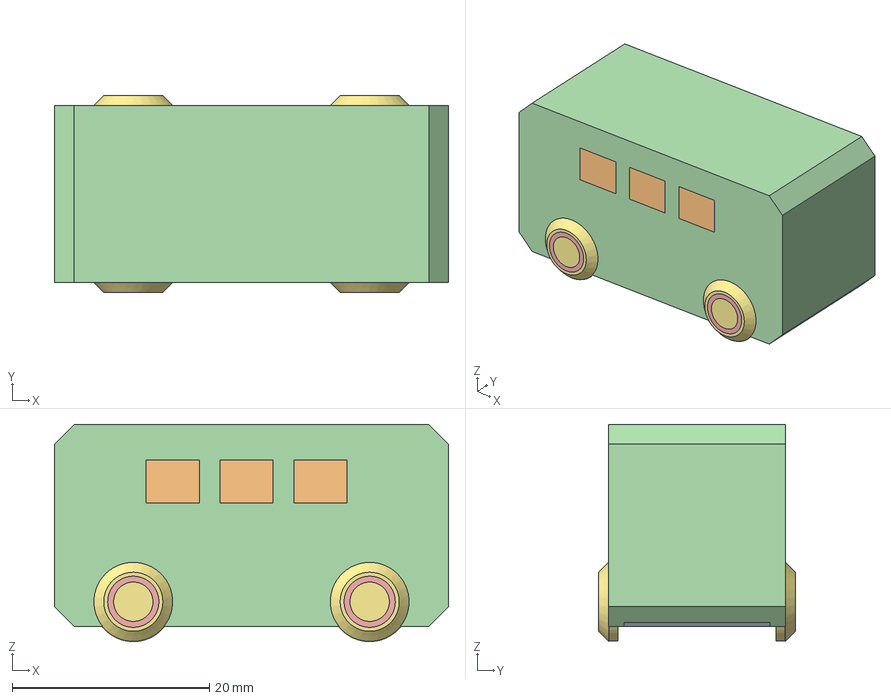
[picture p97: CAD file, 2026-11-10]
designs/school-bus-v07-open-bottom/candidate-r00/cad/school-bus-r00.FCStd
40.0 x 20.0 x 22.0 mm
Rounded bus hull envelope
Open underside and hollow cabin
Three through windows per side
Split through windshield
Four integrated red tires
Complete bus, assembled coordinates
Red lower body and tires
White roof and upper body
