Sunwood-ai-labs/NEKOMO/designs/school-bus-v07-open-bottom/candidate-r00/exports/school-bus-r00-red-print-oriented.stl

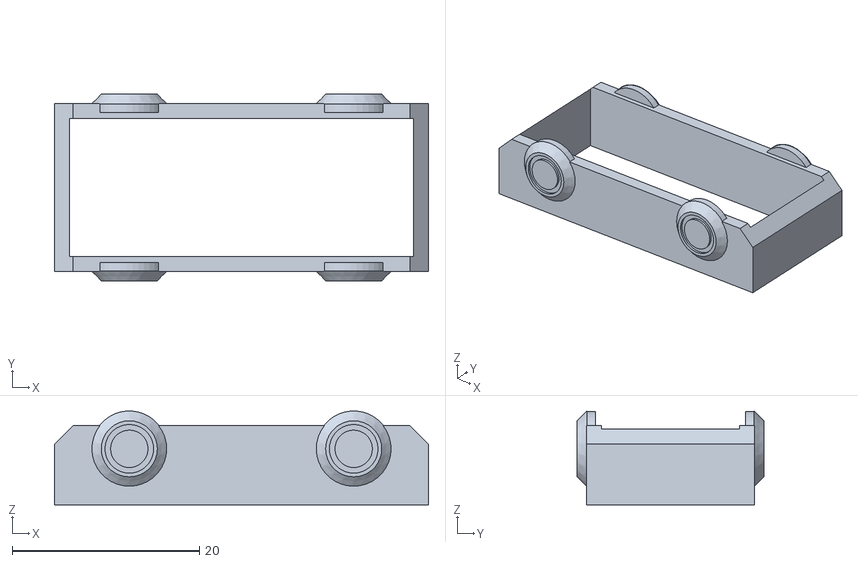
[picture p98: CAD file, 2026-11-10]
designs/school-bus-v07-open-bottom/candidate-r00/exports/school-bus-r00-red-print-oriented.stl
40.0 x 20.0 x 10.0
