Sunwood-ai-labs/NEKOMO/designs/school-bus-v09-sloped/cad/sloped-bus-print.FCStd

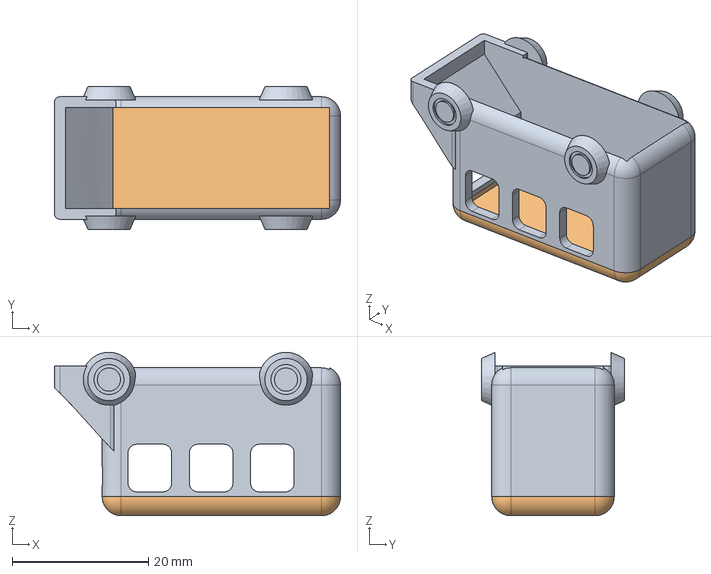
[picture p100: CAD file, 2026-11-10]
designs/school-bus-v09-sloped/cad/sloped-bus-print.FCStd
42.0 x 21.0 x 24.0 mm
RedBodyAndTires
WhiteRoof
