Sunwood-ai-labs/NEKOMO/designs/school-bus-v09-sloped/exports/RedBodyAndTires-inverted.stl

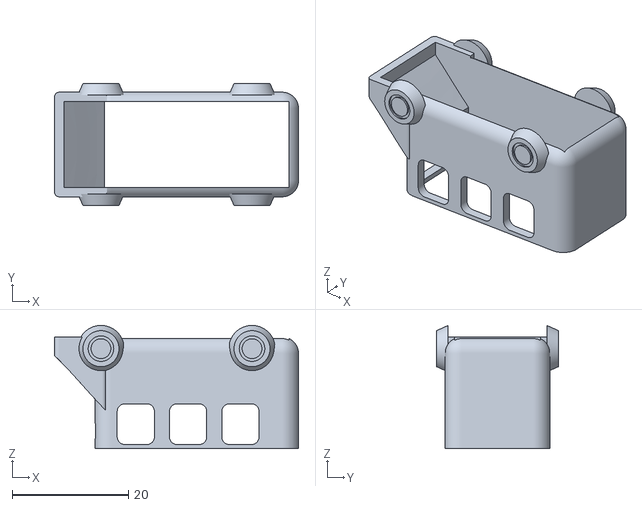
[picture p101: CAD file, 2026-11-10]
designs/school-bus-v09-sloped/exports/RedBodyAndTires-inverted.stl
42.0 x 21.0 x 21.2
