Sunwood-ai-labs/NEKOMO/designs/school-bus-v02/print/final-chassis-sliced.3mf

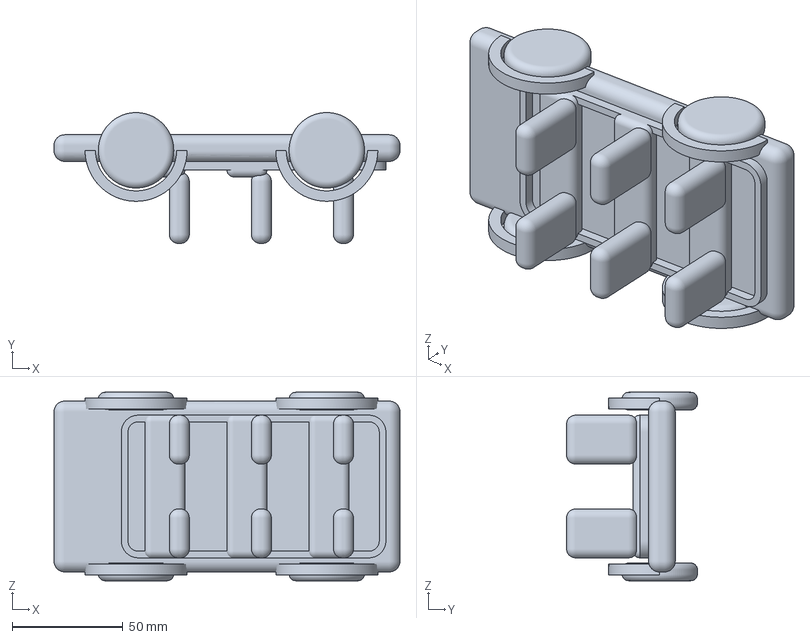
[picture p102: CAD file, 2026-11-10]
designs/school-bus-v02/print/final-chassis-sliced.3mf
156.0 x 59.0 x 85.0 mm
