Sunwood-ai-labs/NEKOMO/designs/school-bus-v03-mini/print/final-chassis-sliced.3mf

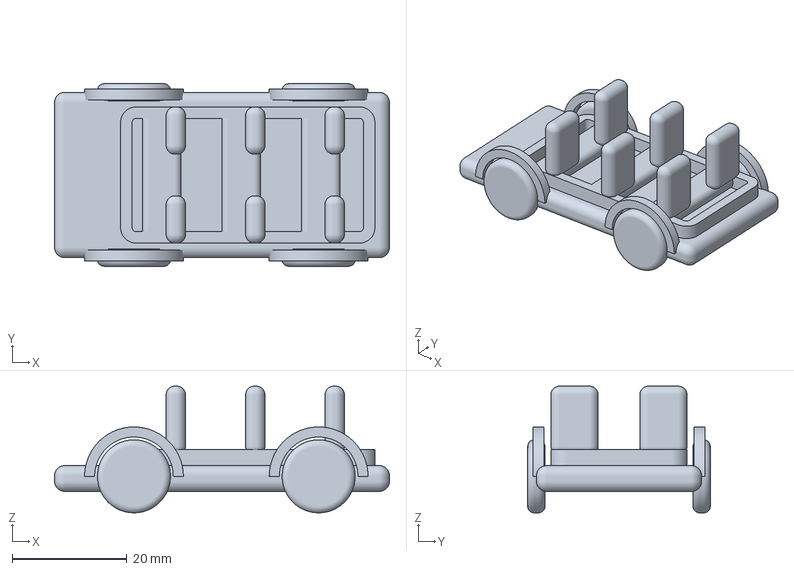
[picture p103: CAD file, 2026-11-10]
designs/school-bus-v03-mini/print/final-chassis-sliced.3mf
58.4 x 31.8 x 22.1 mm
