Sunwood-ai-labs/NEKOMO/designs/school-bus-v04-dr/exports/bus-v04.step

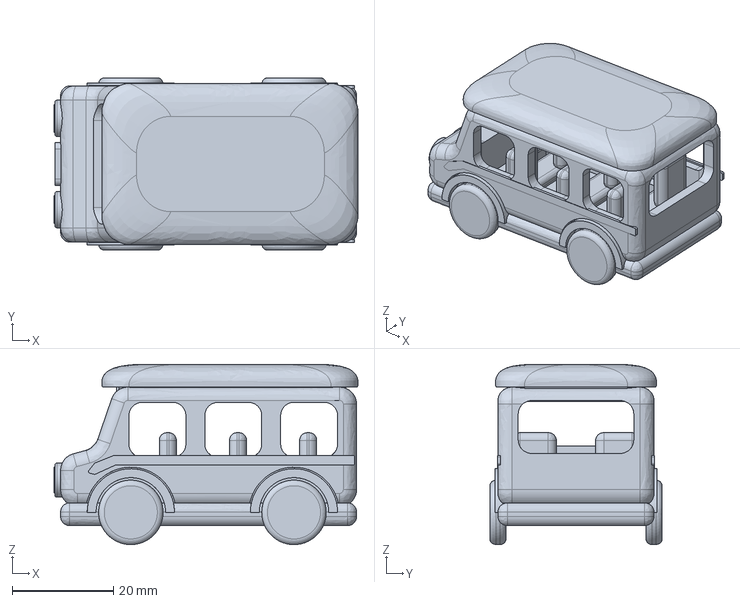
[picture p104: CAD file, 2026-11-10]
designs/school-bus-v04-dr/exports/bus-v04.step
60.0 x 34.0 x 35.6 mm
