Sunwood-ai-labs/NEKOMO/designs/school-bus-v05-dfam/cad/nekomo-school-bus-v05-open-underside.FCStd

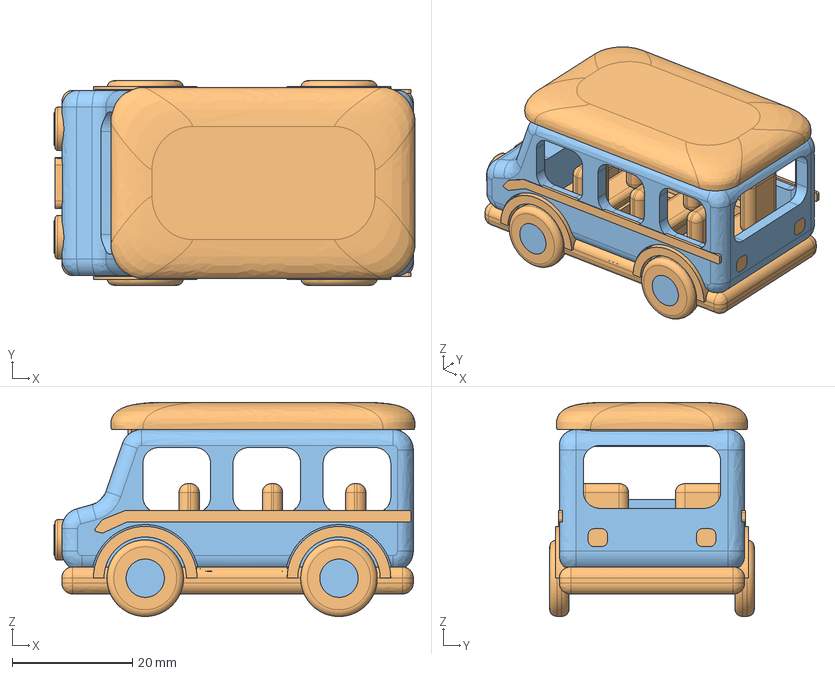
[picture p105: CAD file, 2026-11-10]
designs/school-bus-v05-dfam/cad/nekomo-school-bus-v05-open-underside.FCStd
60.0 x 34.0 x 35.6 mm
One-piece physical bus with open underside
Red color regions clipped to open-underside physical bus
White color remainder for open-underside physical bus
