Sunwood-ai-labs/NEKOMO/designs/school-bus-v06-empty-inverted/two-color-red-tyres/red-tyres-inverted-sliced.3mf

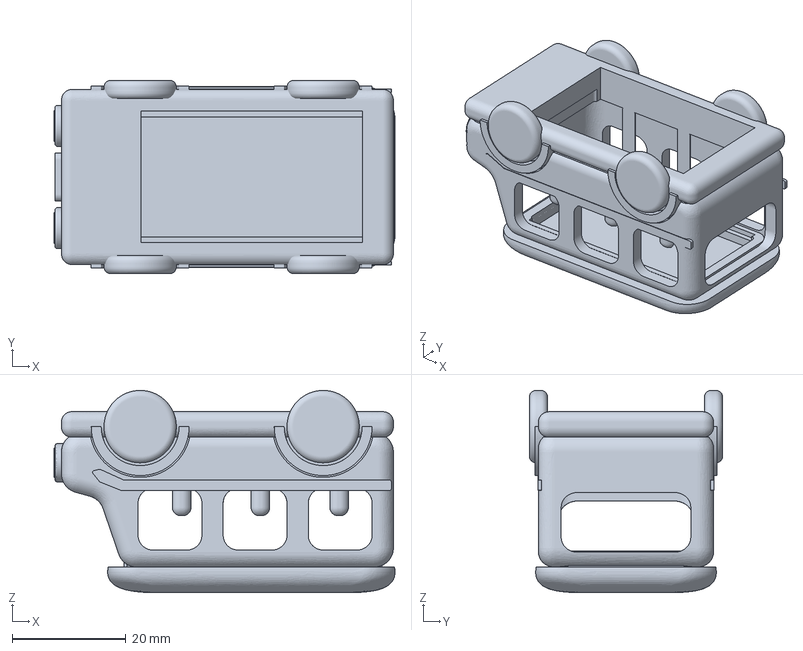
[picture p106: CAD file, 2026-11-10]
designs/school-bus-v06-empty-inverted/two-color-red-tyres/red-tyres-inverted-sliced.3mf
60.0 x 34.0 x 35.6 mm
