Sunwood-ai-labs/NEKOMO/designs/school-bus-v06-empty-inverted/two-color/white-body-inverted.stl

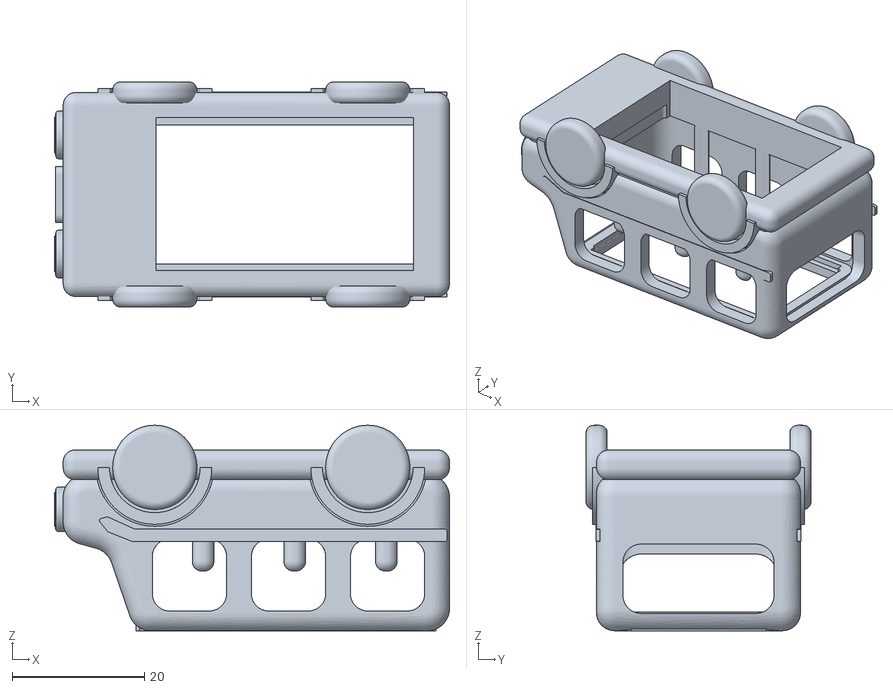
[picture p107: CAD file, 2026-11-10]
designs/school-bus-v06-empty-inverted/two-color/white-body-inverted.stl
59.7 x 34.0 x 31.1
