Sunwood-ai-labs/NEKOMO/designs/school-bus-v08-photo/cad/photo-bus-fast.FCStd

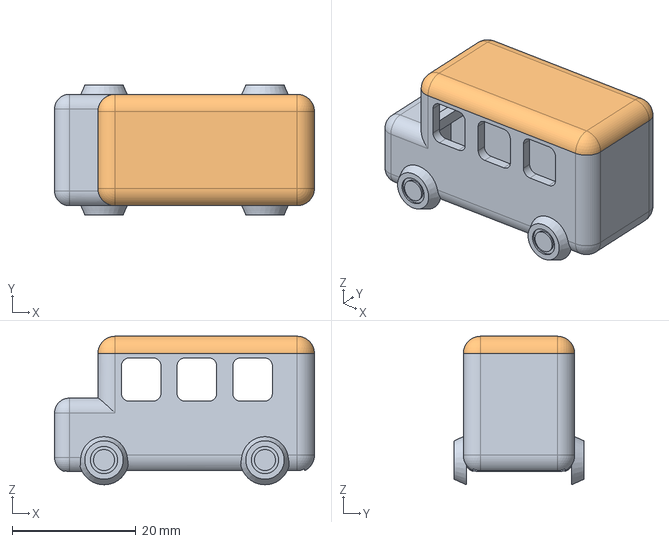
[picture p108: CAD file, 2026-11-10]
designs/school-bus-v08-photo/cad/photo-bus-fast.FCStd
42.0 x 21.0 x 24.0 mm
RedBodyAndTires
WhiteRoof
