Sunwood-ai-labs/NEKOMO/designs/school-bus-v08-photo/exports/RoofAndWheels-inverted.stl

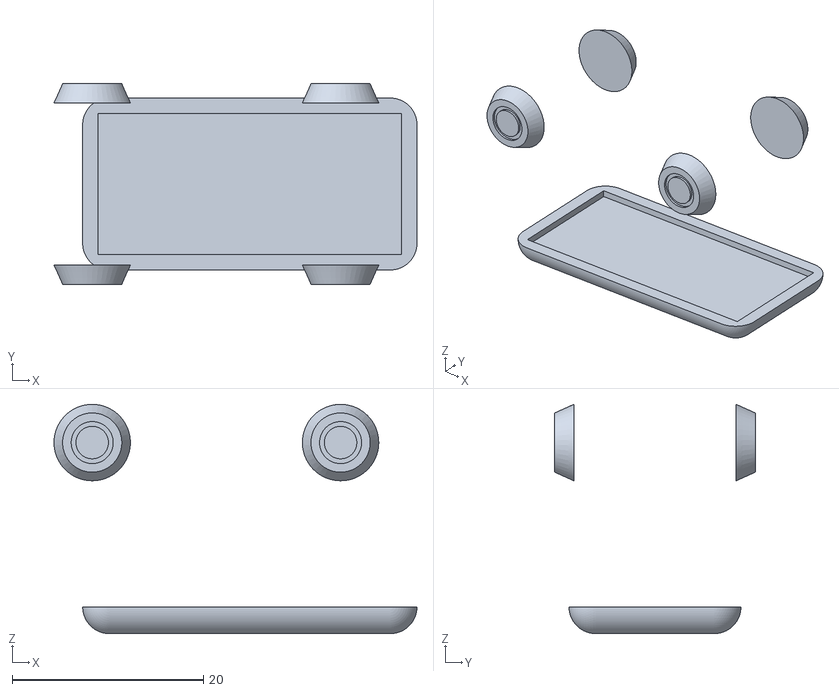
[picture p109: CAD file, 2026-11-10]
designs/school-bus-v08-photo/exports/RoofAndWheels-inverted.stl
38.0 x 21.0 x 24.0
