Sunwood-ai-labs/NEKOMO/designs/school-bus-v09-sloped/exports/WhiteRoof-inverted.stl

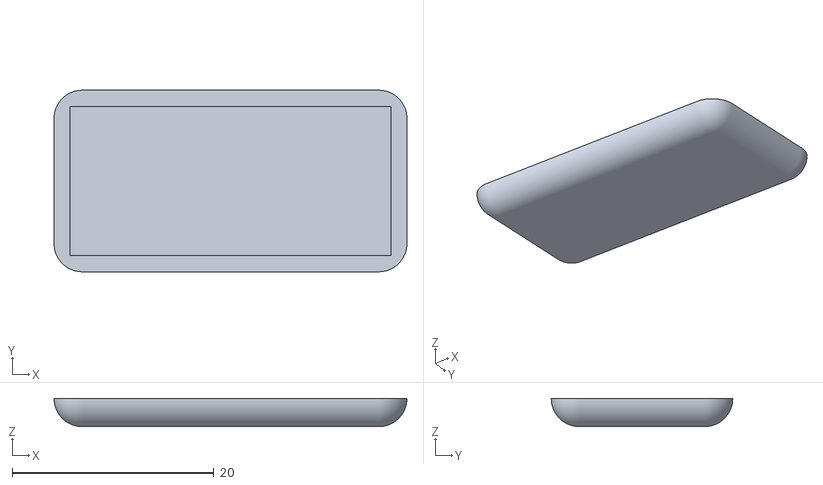
[picture p110: CAD file, 2026-11-10]
designs/school-bus-v09-sloped/exports/WhiteRoof-inverted.stl
35.0 x 18.0 x 2.80
