Sunwood-ai-labs/NEKOMO/designs/school-bus-v02/print/final-body-sliced.3mf

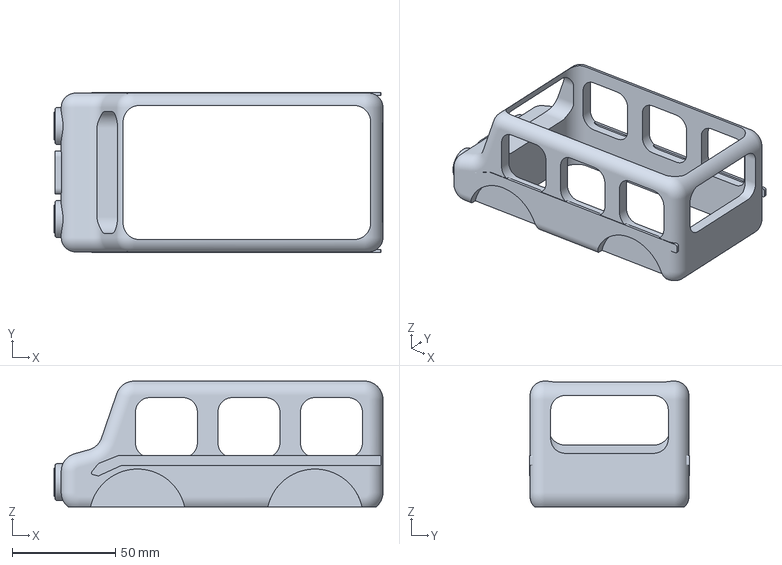
[picture p111: CAD file, 2026-11-10]
designs/school-bus-v02/print/final-body-sliced.3mf
159.5 x 77.5 x 61.0 mm
