Sunwood-ai-labs/NEKOMO/designs/school-bus-v03-mini/print/final-body-sliced.3mf

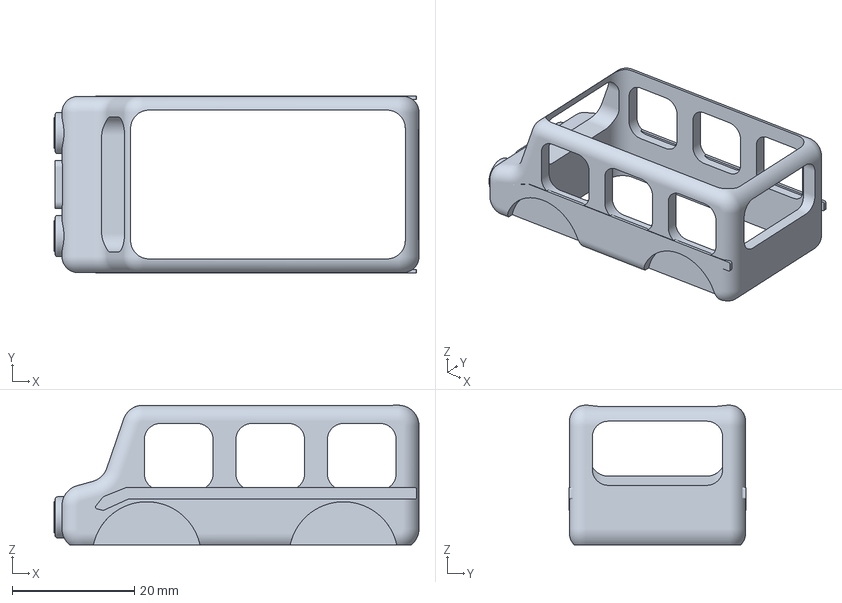
[picture p112: CAD file, 2026-11-10]
designs/school-bus-v03-mini/print/final-body-sliced.3mf
59.7 x 29.0 x 22.8 mm
