Sunwood-ai-labs/NEKOMO/designs/school-bus-v04-dr/exports/bus-v04-white.stl

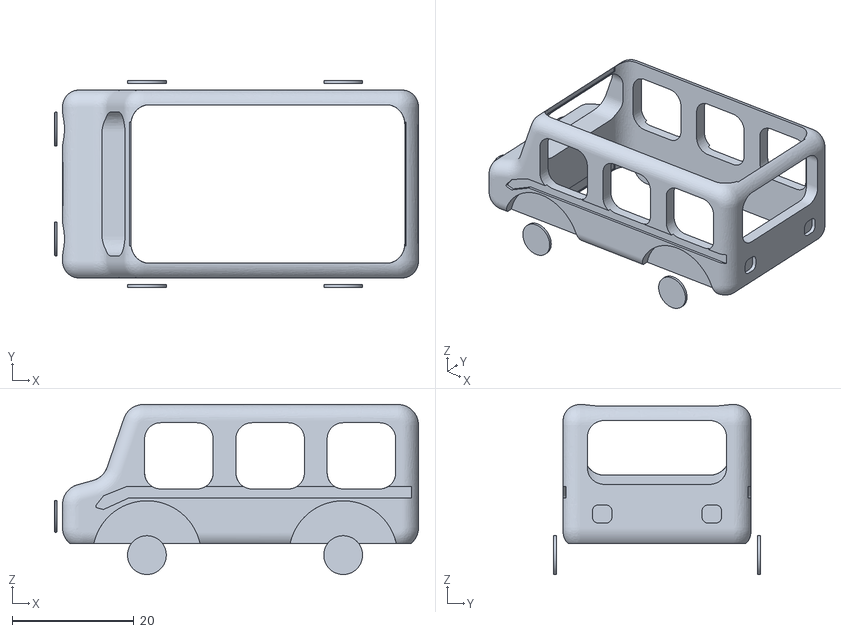
[picture p113: CAD file, 2026-11-10]
designs/school-bus-v04-dr/exports/bus-v04-white.stl
59.7 x 34.0 x 27.9
