Sunwood-ai-labs/NEKOMO/designs/school-bus-v07-open-bottom/candidate-r00/exports/school-bus-r00-white-print-oriented.stl

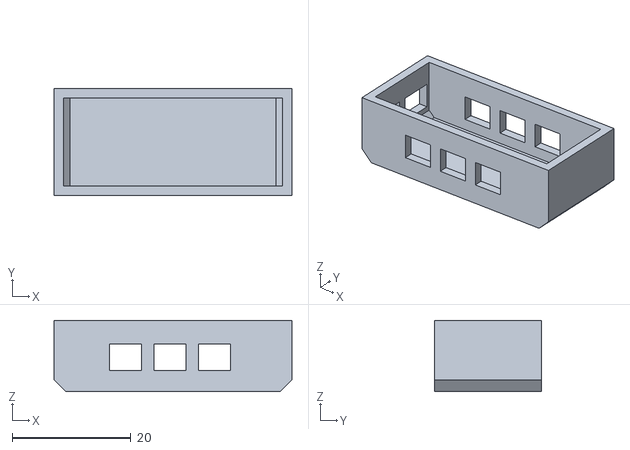
[picture p114: CAD file, 2026-11-10]
designs/school-bus-v07-open-bottom/candidate-r00/exports/school-bus-r00-white-print-oriented.stl
40.0 x 18.0 x 12.0
