Sunwood-ai-labs/NEKOMO/designs/school-bus-v06-empty-inverted/two-color-red-tyres/white-body-hubs-inverted.stl

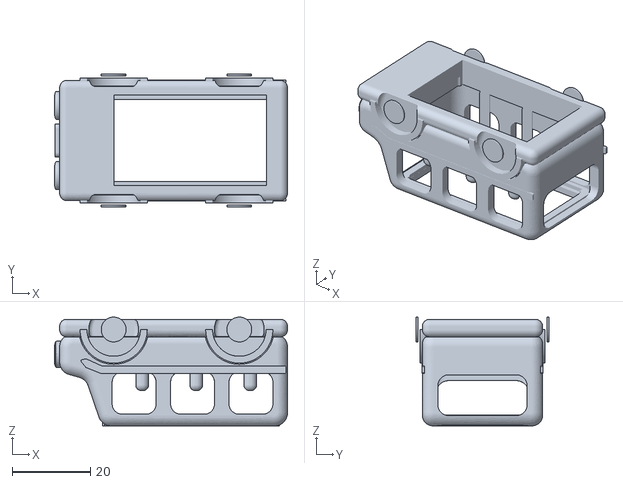
[picture p115: CAD file, 2026-11-10]
designs/school-bus-v06-empty-inverted/two-color-red-tyres/white-body-hubs-inverted.stl
59.7 x 34.0 x 27.9
