Sunwood-ai-labs/NEKOMO/designs/school-bus-v06-empty-inverted/two-color/red-roof-inverted.stl

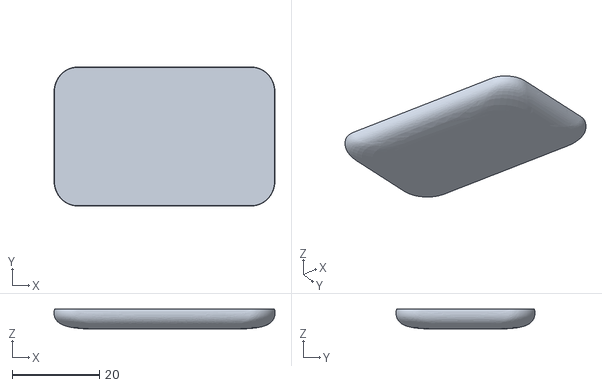
[picture p116: CAD file, 2026-11-10]
designs/school-bus-v06-empty-inverted/two-color/red-roof-inverted.stl
50.6 x 31.8 x 4.49
