Sunwood-ai-labs/NEKOMO/designs/school-bus-v08-photo/exports/Body-inverted.stl

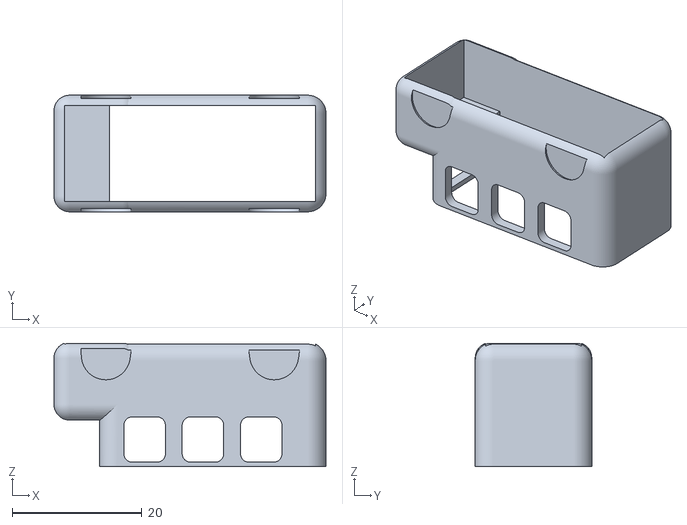
[picture p117: CAD file, 2026-11-10]
designs/school-bus-v08-photo/exports/Body-inverted.stl
42.0 x 18.0 x 19.1
