Sunwood-ai-labs/NEKOMO/designs/school-bus-v08-photo/exports/FastRed.stl

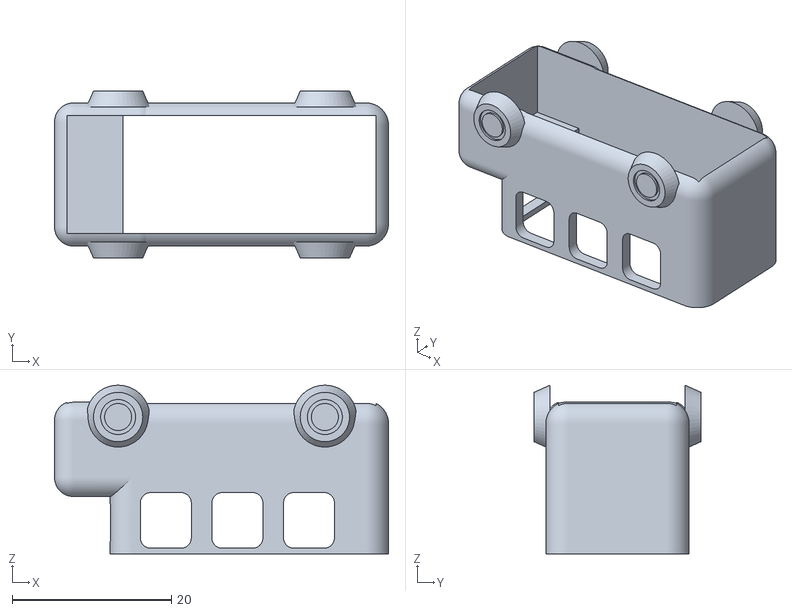
[picture p118: CAD file, 2026-11-10]
designs/school-bus-v08-photo/exports/FastRed.stl
42.0 x 21.0 x 21.2
