Sunwood-ai-labs/NEKOMO/(list of files, cad)

Other CAD files:
designs/school-bus-v02/print/final-roof-sliced.3mf
designs/school-bus-v03-mini/print/final-roof-sliced.3mf
designs/school-bus-v04-dr/print/final-bus-sliced.3mf
designs/school-bus-v04-dr/source/nekomo-school-bus-v03.FCStd
designs/school-bus-v05-dfam/cad/source-nekomo-school-bus-v04.FCStd
designs/school-bus-v06-empty-inverted/print/clear-inverted-normal-support-sliced.3mf
designs/school-bus-v06-simple/candidate-r01/exports/school-bus-r01.step
designs/school-bus-v06-simple/candidate-r01/print/school-bus-r01-sliced.3mf
designs/school-bus-v07-open-bottom/candidate-r00/print/bus-two-colour-final.3mf
designs/school-bus-v08-photo/exports/photo-bus.step
designs/school-bus-v06-empty-inverted/corrected/clear-cabin.step
designs/school-bus-v07-open-bottom/candidate-r00/cad/nekomo-bus-v07-r00.FCStd
designs/school-bus-v06-empty-inverted/corrected/clear-cabin-inverted.stl
designs/school-bus-v06-empty-inverted/two-color-red-tyres/nekomo-v06-red-tyres.FCStd
designs/school-bus-v06-empty-inverted/two-color/red-white-inverted-sliced.3mf
designs/school-bus-v07-open-bottom/candidate-r00/cad/nekomo-bus-v07-final.FCStd
designs/school-bus-v08-photo/exports/fast-two-color-sliced.3mf
designs/school-bus-v09-sloped/exports/sloped-bus.step
designs/school-bus-v04-dr/exports/bus-v04-solid.stl
designs/school-bus-v07-open-bottom/candidate-r00/cad/final-bus-v07.FCStd
designs/school-bus-v09-sloped/exports/sloped-two-color-sliced.3mf
designs/school-bus-v08-photo/exports/FastWhite.stl
designs/school-bus-v08-photo/exports/photo-two-color-sliced.3mf
designs/school-bus-v01/cad/nekomo-school-bus-v01.FCStd
designs/school-bus-v01/cad/rear-window-bridge-coupon.FCStd
designs/school-bus-v01/exports/nekomo-school-bus-v01-solid.stl
designs/school-bus-v01/exports/nekomo-school-bus-v01.step
designs/school-bus-v01/print/nekomo-school-bus-v01-red-prototype-sliced.3mf
designs/school-bus-v01/print/nekomo-school-bus-v01-two-color-sliced.3mf
designs/school-bus-v06-simple/candidate-r01/cad/school-bus-r01.FCStd
designs/school-bus-v06-simple/candidate-r01/exports/school-bus-r01.stl
designs/school-bus-v07-open-bottom/candidate-r00/exports/school-bus-r00-assembled.stl
designs/school-bus-v08-photo/cad/photo-bus.FCStd
designs/school-bus-v09-sloped/cad/sloped-bus.FCStd
