Sunwood-ai-labs/NEKOMO/docs/designs/school-bus-v04-dr/quality/preprint-review/test-plan.md

# v04の設計審査・試験計画

## 判定

この文書はv04のプリント前審査と、別途造形許可を得た後に行う成人向け試作品のスクリーニング試験を定める。試験条件と記録様式の準備は完了した。CAD・STEP・STLのデジタル寸法とA-04は報告書で確認済みである。材料・ロット、現物試験、子どもへの引き渡しは未確認または保留とする。

本書はプリント前審査と、別途許可を得た後に作る成人向け試作品のスクリーニングに使う。プリンターへの送信・造形は未許可で、子どもへの引き渡しは保留する。試験後も、適用法令・化学安全・残留リスクを審査してから使用を判断する。

## 対象と数値の扱い

対象は赤白二色・固定輪・一体形状の全長60 mm級スクールバスである。設計目標は3歳未満向けとする。CAD・STEP・STLの幾何はT-01/T-02のデジタル判定を記録した。現物の安全性と赤白それぞれの材料・色材・ロットは未確認である。

本計画は米国eCFRの玩具試験方法を参照した社内スクリーニングである。試験設備、試料、測定器、実施者が条文どおりであることを確認していない。数値を同じにしても、米国規則、日本の技術基準、ST基準、ISO規格への適合を示さない。日本で製造・輸入・譲渡を行う前に、最新のMETI資料で3歳未満向け玩具の適用範囲を確認する。[出典一覧](sources.md)

数値の区分を混同しない。

- 表中の要望内容は、eCFR条項に記された条件と数値を指す。米国の条文から採った値を明記する。
- 要望内容は、この設計審査で決めた寸法公差、試料数、合否条件を指す。玩具規格の要求値ではない。
- 適用性が判断できない項目はPENDINGとする。必要な測定器や対象年齢別ゲージを推測しない。
- 家庭用の簡易試験手順は定めない。必要な治具・精度・条件を準備できない試験はPENDINGとする。家庭内で参考測定を行った場合も、標準手順の完了や子どもの使用可を示さない。

対象年齢が18か月以下と18か月超36か月以下の双方に及ぶ。eCFR §1500.50は複数年齢帯に及ぶ製品へ最も厳しい要件を適用する。どの試験条件が最も厳しいかを本書で法的に解釈しない。内部スクリーニングでは両年齢帯の該当手順を別試料で実施する。[S-02]

条文はインチ・ポンドを優先する。[S-02] 次のSI値は読みやすさのための換算で、独立した公差や判定値ではない。判定時は表中の原単位を使う。

| 条文の値 | SI換算 |
| --- | --- |
| 4.5 ft / 3 ft | 1.3716 m / 0.9144 m |
| 0.5 in / 1.25 in | 12.7 mm / 31.75 mm |
| 2 in-lb / 3 in-lb | 0.22597 N·m / 0.33895 N·m |
| 10 lbf / 15 lbf | 44.482 N / 66.723 N |
| 20 lbf / 25 lbf / 50 lbf | 88.964 N / 111.206 N / 222.411 N |

## 審査の順序

1. v04のCAD、製造メッシュ、3MF、材料割当、サポート配置を照合する。
2. 別途造形許可が出た場合に限り、成人向けエンジニアリング試料を1個作る。
3. その1個でT-00の支持材除去、アクセス、外観、寸法、小部品円筒による初期確認を行う。
4. 支持材を除去できない、または目視で明らかな損傷がある場合は失敗として止め、設計を直す。合格後に限り破壊試験マトリクスへ進む。
5. §1500.51または§1500.52の試験試料は、各試験前に73 ±3 °F、相対湿度20～70 %で4時間以上調整する。調整環境から取り出した後5分以内に試験を始める。温度、湿度、調整時間、取り出し時刻、試験開始時刻を記録する。[S-02]
6. 試験ごとに未試験の試料を割り当て、指定の落下、ねじり・引張り、圧縮、必要時の咬み試験を行う。引張りにはねじりと同じ試料を使う。
7. 各試験の前後で写真と損傷を記録し、全破片を小部品円筒で確認する。
8. 材料・清掃資料と開口部の評価を閉じ、未解決項目がないことを別途審査する。

§1500.50(b)(3)は引張試験を除く各試験を未試験試料に適用し、引張試験はねじり試験と同じ試料に適用する。内部計画もこの割当を守る。[S-02]

## 試料と記録

各破壊試験セルにつきn=3とする。これは工程ばらつきを見るための内部基準で、eCFRに定められた試料数ではない。各試料は別の造形ロットまたは別の造形ジョブから採り、赤白両方の材料・色材と予定工程を含める。T-10を行う場合も、年齢帯ごとに別の3試料を使う。

試料IDは `V04-B###-T##-R#` とする。`B###`は造形ロット、`T##`は試験ID、`R#`は1から3の反復番号である。試験前に実際のIDを割り当てる。別の破壊試験に使った試料を再利用しない。ねじり後に行う引張りだけは同じ試料を使う。小部品円筒による初期・試験後確認は各試料に併記する。

記録には次を残す。

- CAD、メッシュ、3MFの改訂番号とSHA-256、造形日時、担当者、プリンター識別子、スライサーと設定の改訂番号。
- 赤白それぞれの材料名、製造元、製品番号、色材、ロット、供給者資料の版。
- 造形方向、ノズル径、積層高さ、壁数、充填、温度、速度、支持材と除去手順。
- §1500.51／§1500.52の試験では、試験前の温度73 ±3 °F、相対湿度20～70 %、4時間以上の調整、試験開始まで5分以内の記録。
- 試料ID、質量、外形寸法、測定器IDと校正状態、試験治具と校正状態。
- 試験条件の実測値、各負荷・落下後の所見、破片の数と寸法、写真、判定者、実施日。

資料が欠ける試料、異なる材料・色材・造形設定を混ぜた試料、識別できない試料は試験に使わず、PENDINGとする。

## 試験一覧

| ID | 確認内容 | 出典手順 | 内部基準と判定 | 現状 |
| --- | --- | --- | --- | --- |
| T-00 | 成人向けエンジニアリング試料1個の初期確認 | 出典手順ではない。T-01の寸法とT-03の円筒を使う。 | 破壊試験の前に1個だけ作製する。サポート材を完全に除去できること、窓・床下へのアクセス、外観、寸法、初期の円筒適合性を確認する。支持材を除去できない、または明らかな割れ・剥離・欠けがあれば失敗として止める。破壊試験マトリクスへは進まず、設計を改める。試料は子どもへ渡さず、T-04～T-10のn=3試料に数えない。 | PENDING |
| T-01 | CAD・製造メッシュの寸法、現物の寸法、窓・車輪周辺などの開口・すき間寸法 | eCFRの寸法公差ではない。 | デジタル出力の内部条件は60.000 × 34.000 × 35.568 mmを各軸±0.05 mm以内とする。これは設計値・出力スケールを確認する内部条件で、玩具規格の値ではない。最終CADと製造メッシュを別々に測る。現物の寸法品質は同じ基準値に対して各軸±0.5 mm以内とする。全長60 mmは利用者要求R-02を確認する内部公差A-01、幅と高さは内部寸法値A-03である。開口・すき間は場所、最小寸法、方向を記録し、根拠を確認していない年齢別ゲージの合否値は作らない。CAD補助スクリーニングA-04として、最終メッシュの三角形頂点凸包内最大球直径33.0 mm以上を求める。これは理想形状の数学的判定であり、寸法公差にも現物の円筒試験にも代わらない。候補値だけでは最終メッシュを合格にしない。候補計算（ローカル保存） | デジタル寸法・A-04: PASS。現物寸法・開口実測: PENDING。 |
| T-02 | 一体形状、支持材、外観・端部 | eCFRの手順ではない。 | CADと製造メッシュが意図した一体形状で、屋根・床・固定輪を別部品として含まないことを確認する。モデル内に支持材形状がないこと、工程で生じる支持材を除去できることを確認する。現物は明るい照明と10倍ルーペで全周を見て、支持材残留、糸引き、亀裂、層間剥離、鋭い縁・先端がないことを内部基準とする。疑わしい端部は合格にせず保留する。 | PENDING |
| T-03 | 製品本体と試験後の部品・破片の小部品円筒確認 | §1501.4(b)。無圧縮でどの向きでも円筒に完全に入るかを確認する。図1のインチ寸法を使う。 | 内径1.25 in、内側深さ2.25 inの小部品円筒を使う。本体がどの向きでも無圧縮で完全に入る場合は内部基準で不合格とし、子ども使用を禁止する。外れた部品・破片も一つずつ試す。一つでも完全に入れば不合格とする。CADによる凸包の判定はT-03の現物確認を置き換えない。 | PENDING |
| T-04 | 落下衝撃、18か月以下 | §1500.51(b)。質量3.0 lb未満の玩具に10回、4.5 ft ±0.5 inから無作為の向きで落とす。衝撃面は公称1/8 inの指定Type IVビニル組成タイルを、厚さ2.5 in以上のコンクリートに敷き、面積を3 ft²以上にする。各回で試料を静止させて観察する。 | 内部試料数n=3。質量を先に測る。条文の対象外となる質量や例外があれば、自己判断で非該当とせず専門機関に確認する。損傷、割れ、剥離、欠片、鋭い縁が一つでも出れば内部不合格。全破片にT-03を行う。 | PENDING |
| T-05 | 落下衝撃、18か月超36か月以下 | §1500.52(b)。質量4.0 lb未満の玩具に4回、3 ft ±0.5 inから無作為の向きで落とす。衝撃面はT-04と同じ。各回で試料を静止させて観察する。 | 内部試料数n=3。質量条件・例外を記録する。T-04と同じ損傷判定を行い、全破片にT-03を行う。 | PENDING |
| T-06 | ねじり後の引張り、18か月以下 | §1500.51(e)(f)。子どもが親指と人差し指または歯でつかめる突出部を対象とする。ねじりは2 in-lb ±0.2 in-lbを5秒以内で加え、最大180度または規定トルクに達した状態を10秒保ち、時計・反時計回りに行う。続けて引張りを10 lbf ±0.5 lbfで長軸方向、次に直角方向へ各5秒以内で加え、各10秒保つ。 | 内部試料数n=3。車輪、ハブ、窓柱、灯火、色境界など、つかめる箇所を記録し、最悪形状の箇所を含める。部品の外れ、亀裂、剥離、破片、鋭い縁は不合格。ねじりと引張りの間に試料を交換しない。全破片にT-03を行う。 | PENDING |
| T-07 | ねじり後の引張り、18か月超36か月以下 | §1500.52(e)(f)。つかめる突出部を対象とする。ねじりは3 in-lb ±0.2 in-lbを5秒以内で加え、最大180度または規定トルクに達した状態を10秒保ち、時計・反時計回りに行う。続けて15 lbf ±0.5 lbfで長軸方向、次に直角方向へ各5秒以内で加え、各10秒保つ。 | 内部試料数n=3。T-06と同じ対象記録・損傷判定を行う。ねじり後に同じ試料で引張りを行う。全破片にT-03を行う。 | PENDING |
| T-08 | 圧縮、18か月以下 | §1500.51(g)。衝撃試験で平面に接触しない、子どもが触れられる面を対象とする。直径1.125 in ±0.015 in、厚さ0.375 in、縁半径1/32 inの金属円板を使う。20 lbf ±0.5 lbfを5秒以内に加え、10秒保つ。 | 内部試料数n=3。対象面と円板の接触位置を写真で記録する。割れ、分離、剥離、鋭い破片は不合格。全破片にT-03を行う。 | PENDING |
| T-09 | 圧縮、18か月超36か月以下 | §1500.52(g)。装置、対象面、時間はT-08と同じ。負荷は25 lbf ±0.5 lbf。 | 内部試料数n=3。T-08と同じ対象記録・損傷判定を行う。全破片にT-03を行う。 | PENDING |
| T-10 | 咬み試験の適用性と、必要時の試験 | §1500.51(c)、§1500.52(c)。外寸1.25 in ±0.05 in以下で、どの向きでも口に入れられ、咬める厚さが1.25 in ±0.05 in以下かつ0.25 in以上挿入できる形状が対象となる。規定の金属接触板と精度±0.5 lbfの荷重計を使い、0.25～0.5 in挿入し、接触板の円弧180度未満を使う位置で、5秒以内に負荷を上げて10秒保つ。18か月以下は25 lbf ±0.5 lbf、18か月超36か月以下は50 lbf ±0.5 lbf。 | まずCAD・現物の寸法と形状から適用性を記録する。該当時は各年齢帯で別のn=3試料を使う。口に入る形状か判断できない場合は適用外とせず、専門機関に確認する。欠片、割れ、剥離、鋭い縁は内部不合格。全破片にT-03を行う。 | PENDING |
| T-11 | 清掃方法と清掃後の状態 | 出典規格値なし。材料供給元の該当資料が必要。 | 正確な赤白の材料・色材を特定後、供給元の清掃条件から方法を定める。洗剤・温度・浸漬時間を創作しない。手順を3試料で実施し、変色、べたつき、変形、亀裂、寸法変化があれば不合格とする。材料資料がない場合は保留する。 | PENDING |
| T-12 | 材料・色材・ロット記録と化学評価資料 | METI資料は3歳未満向け玩具の技術基準・年齢表示等を案内する。化学物質の本計画用合否値は設定しない。 | 赤白それぞれの製造元、製品番号、組成・安全資料、色材、ロットを記録する。評価資料だけで適合を断定しない。適用する化学試験・法的手続は、専門機関と最新METI資料で確定する。資料未入手または評価未完了なら、子どもへの引き渡しを保留する。 | PENDING |
| T-13 | 窓・車輪・屋根下の開口と指挟み評価 | 本計画で根拠のある年齢別ゲージ寸法を確認できていない。 | T-01で全開口・すき間を寸法記録する。適用する年齢別プローブと合否値は、専門試験機関に確認する。寸法だけで指挟み安全を判定せず、条件が確定するまで保留する。 | PENDING |
| T-14 | 燃焼性の適用性と試験機関報告 | METI技術基準省令別表第1第9項は燃焼しにくい材料または構造を求める。eCFR §1500.44は固体の燃焼性分類方法、§1500.3(c)(6)(vi)は同法の要望内容の定義を示す。これは日本の玩具基準の合否方法ではない。 | 正確な赤白の材料・色材資料を専門機関に渡し、適用する玩具試験を特定する。専門機関が§1500.44を使う場合は、試料を68～86 °F、無風で換気できる区画、主軸水平・最大面を露出し、直径1 in以上のパラフィンろうそくの炎を最大5秒接触させる。持続燃焼時間は60秒を超えて測らず、燃焼速度を報告する。§1500.44の実火試験は適格試験機関でのみ行い、家庭では行わない。§1500.3の0.1 in/s超という分類値を、日本の玩具向け合否値として使わない。 | PENDING |
| T-15 | 鋭い先端と、該当する場合の金属・ガラス縁 | §1500.48は8歳未満向け玩具の先端を対象とし、使用・酷使試験前後に適用する。3歳以下向けのアクセス性確認にはプローブAを使う。§1500.49は金属またはガラスの縁に限る。 | 適格試験機関が校正済みの治具で、全試料のアクセス可能な先端をT-04～T-09の前後に確認する。§1500.48の治具は開口0.040 × 0.045 in以下、感知部のくぼみ0.015 in以上、さらに0.005 in動く感知部と0.5 lbfのばねを備える。操作力の上限1.00 lbfで点灯すれば鋭い先端として内部不合格にする。金属・ガラス縁がある場合だけ§1500.49を確認する。金属マンドレルは直径0.375 ±0.005 in、回転中央75 %で接線速度1.00 ±0.08 in/s、MIL-I-23594Bに記載するPTFE電気絶縁テープを1層巻く。裏材厚さ0.0026～0.0035 in、シリコーン接着剤厚さは公称0.003 in、テープ幅0.25 in以上、温度70～80 °Fとする。最大1.35 lbfの法線荷重で1回転させ、0.5 in以上の完全な切れがあれば鋭い縁とする。1.35 lbfで試料縁が曲がる場合は荷重を下げて記録する。樹脂縁に§1500.49を適用しない。樹脂縁の該当基準は専門機関に確認する。 | PENDING |

### 対象外にする試験

§1500.51(d)の屈曲試験は、形状保持に用いる金属ワイヤー等の金属部材を含む場合に適用性を再確認する。内部設計条件R-08は追加ハードウェアを使わないが、v04の材料・部品表が未確認なので、現状は非該当とせずPENDINGとする。金属部材がないことをCAD・部品表・材料記録で確認した後に限り、適用外として記録できる。

## 合否と再試験

内部スクリーニングは、同じ試験セルのn=3試料がすべて規定条件を満たし、事前・各負荷後・試験後の記録が揃った場合だけ合格とする。ひとつでも内部不合格条件が出れば、そのセルを不合格とし、子ども使用を承認しない。測定器の精度、治具、試験条件、試料識別の記録が欠けた場合は合格にせずPENDINGとする。

設計を直した後は、変更した材料・色境界・形状・造形設定に影響する試験を、未試験の新しい試料で繰り返す。結果の平均で不具合を相殺しない。再試験の範囲と残留リスクは別の設計審査で承認する。

本計画だけで適合性を判断しない。METIは3歳未満向け玩具の技術基準、自主検査・記録、年齢表示と保護者の監督表示を案内し、ST基準との関係も説明している。該当性、必要な試験、表示、材料の化学評価は最新資料と試験機関で確認する。[S-01]

## 現在の実施記録

| 項目 | 状態 | 根拠 |
| --- | --- | --- |
| T-01 CAD・STEP・STL寸法とA-04 | デジタルPASS | reopened-cad-report.json（ローカル保存）は再読込したCADとSTEPを各1個の有効・閉じたソリッドとして記録し、0.005 mm偏差・0.06 rad角度で三角形化した寸法を60.000000 × 34.000000 × 35.567934 mmとする。mesh-report.json（ローカル保存）の`bus-v04-solid.stl`は59.999748 × 34.000000 × 35.568054 mmで、開境界・非多様体辺・退化三角形は0。final-hull-screen.json（ローカル保存）は同STL（SHA-256 `6530b5f46ac4780ba498e98d9d7793e0c94cdab60ae353eef07792a361c44595`）の凸包内最大球直径33.399924 mm、内部A-04の33.0 mm以上を記録する。理想メッシュ上の確認で、現物ゲージ試験ではない。 |
| T-02 CAD・STEPの一体形状 | デジタルPASS、現物はPENDING | `PhysicalBus`、再読込CAD、STEPは有効・閉じた1ソリッド。検査記録（ローカル保存）はディスパッチ未許可と記録する。実物のサポート材除去、残材、端部、アクセスは未確認。 |
| T-02/T-12 3MF・スライス・材料割当 | PENDING | slice-bus.json（ローカル保存）は1プレート、警告なし、予測31,354秒・130.45 gを記録する。これは造形準備の結果で、送信・造形・支持除去の実施や材料ロット・安全資料を確認する記録ではない。 |
| T-01現物寸法、T-03円筒ゲージ | PENDING | 試料はなく、現物測定もゲージ確認も未実施。寸法公差やA-04から円筒適合を推定しない。 |
| 材料・色材・ロット | PENDING | 赤白の品番、組成、ロット、供給元資料が未確認。 |
| 試料作製 | PENDING | 造形許可がなく、試料は作製していない。 |
| T-00、T-03～T-15の現物試験と適用性確認 | PENDING | 試料・治具を使った物理試験と材料資料による判定は未実施。T-01/T-02のデジタル項目は上表のとおり。 |
| 子ども使用 | 保留 | 現物試験、化学評価、法的適用範囲、残留リスクの審査が未完了。 |
