Sunwood-ai-labs/NEKOMO/docs/designs/school-bus-v06-simple/quality/preprint-review/dfmea.md

# v06-simple 設計FMEA

## 状態と範囲

版: 0.1.0  
状態: CAD受領前の予備分析  
日付: 2026-11-09

対象は40 × 20 × 22 mm級の小型一体バス案である。親担当のDR0判定では、屋根と車体を閉じた1ソリッドにし、車内と座席を設けず、窓とタイヤを浅い円形Pocketで表す。CADは未生成のため、各故障モードの形状上の原因と対策は未確認である。

発生頻度、検出能力、採点尺度、現物データがないため、S・O・DとRPNは付けない。本書は予備の危険分析であり、安全性評価や使用承認ではない。

## 予備DFMEA

| ID | 故障モードと影響 | 原因候補 | 設計上の対応と確認 | 状態 |
| --- | --- | --- | --- | --- |
| D-01 | 車体や屋根が割れ、破片や鋭い端部が生じる。 | 局所肉厚、層方向、低い充填、積層接着の不足。 | CADの断面とスライス経路を確認し、試作品の外観・破損状態を記録する。形状だけで強度を主張しない。T-02、T-08。 | CAD・現物待ち |
| D-02 | タイヤPocket周辺が欠け、表面の破片や鋭い縁が生じる。 | Pocketの深さ、底部の肉厚、角部、局所的な積層状態。 | Pocket形状と周囲断面を確認する。造形後に周辺を撮影し、欠けや割れを記録する。T-02、T-08。 | CAD・現物待ち |
| D-03 | 窓Pocketの底や縁が割れる、または窓の溝に汚れが残る。 | Pocketによる薄肉化、角部の応力、清掃しにくい凹部。 | 断面で残る壁厚を記録し、窓の底・縁と清掃性を造形後に確認する。厚さや清掃条件の合否値は作らない。T-02、T-08。 | CAD・現物待ち |
| D-04 | 角や表面に鋭い欠け、バリ、糸引きが残る。 | 造形欠陥、除去時の損傷、試験中の破損。 | 丸角をCADで確認し、完成品の全周を目視して写真を残す。疑わしい欠けは合格扱いせず、設計または工程へ戻す。T-08。 | 現物待ち |
| D-05 | 平底が反り、接地面が不安定になる。 | 底面形状、ベッドへの接着、冷却時の反り。 | CADとメッシュの底面を確認し、造形後に平面上で接地状態を記録する。許容反り量は未設定。T-02、T-08。 | CAD・現物待ち |
| D-06 | 小型試作品へ子どもがアクセスし、口に入れる可能性がある。 | 保管・受け渡し時に成人評価用という区分が失われる。 | 成人向け造形評価試作として識別し、子どもへの引き渡しを承認しない。小型部品・誤飲に関する適合判定を行わない。T-09。 | 使用範囲の制約。子ども使用は保留 |
| D-07 | 材料情報が不明なまま、材料特性や接触時の安全性を誤認する。 | PLA Basicの製品番号、色材、ロット、資料が未特定。 | 現物ラベルとロットを記録する。材料名だけで化学的安全性や用途適合を判断しない。T-09。 | 材料特定待ち |
| D-08 | 時間目標を優先して設定を下げ、形状品質が変わる。 | 45分目標に合わせた積層高さ、壁数、充填の変更。 | 初期プロファイルを記録し、時間目標と品質観察を別に判定する。時間短縮のための設定変更は別改訂として評価する。T-04、T-05、T-06。 | スライス・現物待ち |
| D-09 | 支持なしで造形できず、未造形面や表面欠陥が残る。 | Pocket、屋根、前面などの張り出しと積層方向。 | スライスの警告、支持設定、層ごとの形状を確認する。支持経路が生じた場合は支持を追加して要求を満たしたことにせず、形状か姿勢を見直す。T-04。 | CAD・スライス待ち |
| D-10 | CAD、メッシュ、3MFで改訂や尺度が食い違う。 | 古い出力の使用、単位・スケールの取り違え。 | 各ファイルの版とSHA-256を結び、再読込寸法を記録する。v04の寸法・安全評価はv06へ流用しない。T-01、T-03、T-04。 | ファイル待ち |

## 対策の確認先

対策は候補であり、有効性を確認していない。CADとスライスを受け取った後、該当部位・FMEA ID・試験IDを対応づけて更新する。現物の強度、材料特性、子ども使用、安全性、規格適合は本書では判定しない。
