Sunwood-ai-labs/NEKOMO/docs/designs/school-bus-v06-simple/quality/preprint-review/pfmea.md

# v06-simple 工程FMEA

## 状態と工程範囲

版: 0.1.0  
状態: CAD・スライス前の予備分析  
日付: 2026-11-09

対象工程は要求確認、CAD作成、メッシュ出力、スライス、将来の造形、冷却・取外し、記録である。CADとスライスは未受領で、造形も未実施である。発生頻度や検出能力の根拠がないため、O・D・RPNは付けない。

## 工程と故障モード

| ID | 工程・故障モード | 影響 | 管理と確認 | 状態 |
| --- | --- | --- | --- | --- |
| P-01 | 旧v04のCADまたはメッシュをv06として使う。 | 形状、寸法、要求、評価対象が一致しない。 | 新しいv06パスを使う。レビュー前後のファイル版とSHA-256を記録し、v04のファイルを変更しない。 | CAD待ち |
| P-02 | CADの単位、尺度、外形を取り違える。 | 40 × 20 × 22 mm級の目標から外れる。 | CAD境界箱とメッシュの寸法を再読込後に記録する。許容差を独自に作らない。 | CAD待ち |
| P-03 | 古い、破損した、または形状が欠けたメッシュをスライスする。 | スライス結果がCADと異なる。 | CAD・メッシュ・3MFの改訂とハッシュを対応づけ、独立再読込後に形状を確認する。 | 出力待ち |
| P-04 | 単色または支持材の材料割当を取り違える。 | 造形物が単色PLAの要求を外れ、支持材が本体に入る。 | 初期候補の赤PLA Basicを本体材として割り当てる。A2 Support for PLAを本体材に使わない。最終3MFの材料割当を確認する。 | スライス待ち |
| P-05 | 実機ノズルやスライス条件が候補と異なる。 | 寸法、表面、層間状態、時間が変わる。 | 0.4 mmノズル、0.20 mm積層、3 walls、15% gyroidを初期候補として記録する。実機ノズルは未測定で、実際の設定と一致するまで造形を保留する。 | 設定未確認 |
| P-06 | 支持材が生成される、または支持なしの面が崩れる。 | 要求違反または欠陥が残る。 | スライスの支持設定、支持経路、各層の形状を確認する。支持材が必要なら、支持材を追加して合格とせずCADまたは姿勢へ戻す。 | スライス待ち |
| P-07 | 時間予測と実造形時間を同じ値として扱う。 | 45分・60分の目標に対する判定を誤る。 | スライサー予測、実造形時間、冷却・取外し時間を分けて記録する。ユーザー報告の約30分のサンプル造形は比較基準にしない。 | スライス・現物待ち |
| P-08 | 冷却前の取外しや不適切な取外しで試作品を損傷する。 | 底面、角、Pocketの欠けや変形が起きる。 | 造形を行う段階で、機器の手順に従って取外し、冷却開始・終了と取外し完了の時刻を記録する。作業条件は未確認。 | 現物待ち |
| P-09 | 造形失敗や欠陥のある試作品を評価対象として扱う。 | 結果と造形条件が対応しなくなる。 | 個体ID、CAD・メッシュ・3MFの版、材料、設定、写真、異常を記録する。欠陥品を補修して評価済み品に混ぜない。 | 現物待ち |
| P-10 | デジタル確認や目視を安全性の承認へ読み替える。 | 未評価の試作品が子どもへ渡る。 | DR0〜DR4の状態、未実施項目、子ども使用保留を分けて記録する。 | 使用判定は保留 |

## 工程判定

本書は工程上の管理候補を示す。工程能力、造形結果、再現性、製品安全性を確認した記録ではない。スライス後に実際の設定と材料割当を照合し、送信・造形の可否は親担当の別判断に残す。
