Sunwood-ai-labs/NEKOMO/docs/designs/school-bus-v04-dr/quality/preprint-review/dfmea.md

# v04設計故障モード影響解析（DFMEA）

## 対象と判定

対象は全長60 mm級の赤白スクールバス設計である。3歳未満向けを目標とし、固定輪、屋根・床を含む一体形状を候補とする。v04 CAD・メッシュ・ファイルのみのスライスを確認した。Native CADとSTEPの再読込では有効な閉じた1ソリッドを確認した。材料の化学資料・ロット、物理的な造形・試験結果は未確認である。本書は設計時点の危険分析で、玩具安全性の認定ではない。

設計候補は要望内容とする。v03の車体・シャーシ・屋根は各1ソリッドの別部品で、`ChassisGuide`と`RoofGuide`の片側すき間は約0.300 mmだった。形状レポートは`roof_retention_validated: false`である。位置決めガイドの存在は保持力の根拠にならない。

## 重大度の区分

重大度は想定される結果の重さだけを示す。発生頻度、検出度、RPNは付けない。

| 区分 | 結果の目安 |
| --- | --- |
| S4 致命的 | 誤飲・窒息、重大な口腔内損傷、指の拘束など、生命に関わる危害につながる可能性。 |
| S3 重大 | 破片、鋭利部、強い挟み込みなど、医療対応を要するけがにつながる可能性。 |
| S2 中程度 | 皮膚のけが、清掃後の劣化、変形や破損による使用不能など。 |
| S1 限定的 | 外観・寸法・組立の不適合など、直接のけがを想定しない品質上の影響。 |

この区分は設計審査内の比較用で、規格の分類や確率評価ではない。結果が複数ある場合は、もっとも重い想定結果を記す。

## 候補の比較と設計判断

| 案 | 比較結果 |
| --- | --- |
| A. 屋根・車体・床を別体にし、追加ハードウェアなしの保持形状で固定する | 色・姿勢・組立には利点がある。一方、保持形状が破損または抜けると別体部品になる。スナップ根元に応力が集まり、組立や反復荷重で亀裂・破片が生じる経路も増える。v03のガイドは位置決めのみで保持力未検証。 |
| B. 屋根・床・固定輪を一体形状にし、赤白の材料領域を残す | 意図した別体の屋根・床とその接合界面を減らせるため、現要件ではこちらを選ぶ。色境界・層間、車輪・窓柱の破断、小片、支持材残留、窓の開口、材料・清掃・熱の危険は残る。一体CAD形状は破損後の小部品を否定しない。 |

## DFMEA

| ID | 故障モード・危険 | 影響と重大度 | 設計で行うこと・CAD対応 | 確認と現状 |
| --- | --- | --- | --- | --- |
| D-01 | 屋根または床が外れ、小部品になる。 | 誤飲・窒息。S4 | 案Bとして`PhysicalBus`で屋根・車体・床を統合する。`BodyChassisWeldCollarLeft`、`BodyChassisWeldCollarRight`、`BodyRoofWeldCollarLeft`、`BodyRoofWeldCollarRight`はビルダー上の内部連結形状名である。 | v03では別体3部品、保持力未検証。v04 geometry-reportと最終再読込レポート（ローカル保存）では`PhysicalBus`が有効な閉じた1ソリッドと記録され、Native CAD・STEPとも外部文書参照は0。全体STLは閉鎖した1連結成分で、境界・非多様体エッジ・退化三角形は0だった。4カラーの断面寸法は約2.527 × 2.059 mm。コード近くの高さ1.87 mmという古いコメントと異なる。計画ID: T-03、T-04、T-05、T-06、T-07。CADの一体性は確認済みだが、脱落・破片は現物試験まで未確認。 |
| D-02 | 赤白の領域境界、または積層界面で剥離する。 | 異色片の誤飲、口腔内損傷。S4 | 色を別部品や接着剤に頼らず、`RedInputUnion`、`RedModel`、`WhiteModel`で赤白領域に分ける。 | geometry-reportでは赤・白メッシュがそれぞれ閉鎖している。スライス材料切替は未確認。計画ID: T-02、T-06、T-07。境界強度は現物評価が必要で、材料・色・造形条件は未確定。 |
| D-03 | 色境界に隙間・薄い縁・重なりが生じ、先端や破片になる。 | 口や皮膚の損傷、小片の誤飲。S3〜S4 | 赤白境界を車輪根元、窓柱、外周の細い縁から離し、重なり・欠落・局所肉厚を調べる。色領域は`RedModel`と`WhiteModel`。v03の外観フィーチャー名は`SideSwoosh0`、`Grille`、`LampLens0`。 | `RedModel`と`WhiteModel`の集合差評価は、共通体積0、全体からの欠落0、全体外への過剰0、対称差0とgeometry-reportに記録された。raw volume-sum差2.7486 mm³はB-spline体積積分の診断値で、集合差による隙間・重なりの判定と混同しない。計画ID: T-01、T-02、T-03、T-06、T-07、T-15。境界強度・破損状態・独立再読込は未確認。 |
| D-04 | 固定輪、ハブ、フェンダー根元が割れる。 | 輪や破片の誤飲、鋭利部。S4 | `PhysicalBus`と`V04ChassisSource`を介して車輪根元の連続性を確認する。元形状の参照名は`Wheel00`、`Wheel01`、`Wheel00Fender`、`Wheel01Fender`、`Hub`、`WheelArchClearances`。 | v04のCAD連続性と局所肉厚を確認する。計画ID: T-03、T-06、T-07。曲げ・引張り・ねじり後の破損と車輪の脱落は未評価。 |
| D-05 | 窓柱が折れる、または隣接壁から剥がれる。 | 柱片の誤飲、鋭利部。S4 | `V04BodySource`内の`Windows`、`FrontWindow`、`BodySoftEdges`を参照し、窓柱と前窓上枠の断面、屋根との連結を確認する。 | 代表断面レビュー（ローカル保存）では、車体単体の上枠1.872 mmに対し、融合後に連続する代表断面はX=29.5、32、35 mmで5.765〜7.126 mmだった。X=27.5 mmの接線端部では約0.101 mmの薄い交差片と別の屋根部分があるため、荷重を受ける肉厚として扱わない。これは代表的な鉛直断面で、全体最小肉厚や強度の証明ではない。計画ID: T-03、T-06、T-07。柱の破損と強度は現物試験まで未確認。 |
| D-06 | 屋根裏や客室に支持材が届かない、または残る。 | 残材の誤飲、口腔内の擦過、汚れ残り。S3〜S4 | 屋根裏・窓上・客室・床下面の支持アクセスを考慮した形状と姿勢を使う。モデル形状に支持材を含めない。v03形状参照名は`RoofDome`、`RoofGuide`、`Windows`、`Floor`。v04統合形状は`PhysicalBus`。 | Bambu Studioのファイルのみスライスでは木状支持材を使用し、支持界面の上面距離0 mm、上面界面3層と記録された。ファイル検査ではPLA-S支持材の経路を支持界面とプライムタワーに確認し、モデル形状の経路は0。支持の届きやすさ、除去性、残留物、表面は未確認。計画ID: T-02、T-03。 |
| D-07 | 座席・背もたれ・床との根元が折れる。 | 部品片の誤飲や鋭利部。S4 | 座席・背もたれを連続形状とし、根元の公称肉厚を2.0 mm以上にする設計目標を使う。v03形状参照名は`Bench0`、`Back00`、`Floor`。v04では`V04ChassisSource`を`PhysicalBus`へ統合する。 | 2.0 mmは内部設計基準で安全基準ではない。v04の局所最小値と造形経路をCAD・スライスで確認する。計画ID: T-03、T-06、T-07。破損状態は現物未確認。 |
| D-08 | 破断・欠けで鋭い先端や縁ができる。 | 口腔内・皮膚の切創。S3 | 外側角と灯火・ハブ・窓柱の根元に丸みを設け、薄い突出部を減らす。v03形状参照名は`BodySoftEdges`、`LampHousingRound0`、`LampLensRound0`。v04では`V04BodySource`を`PhysicalBus`へ統合する。 | v04 CADの丸み・薄肉箇所と、前窓上枠の代表断面を確認した。詳細は代表断面レビュー（ローカル保存）を参照する。接線端部の薄い交差片を含め、選択した断面だけでは全体最小厚さ・欠け後の先端・縁を評価できない。計画ID: T-02、T-03、T-04、T-05、T-15。先端・縁と破損後の状態は現物評価まで未確認。 |
| D-09 | 窓、車輪周辺、屋根下などに指が入り、抜けにくくなる。 | 指の拘束や皮膚の損傷。S3 | 開口とすき間を全周から抽出し、角を丸める。窓を単純に閉じる場合は参考外観との両立を確認する。v03形状参照名は`Windows`、`WheelArchClearances`、`BodyWithArches`。開口寸法と指挟みゲージの適用性を確認する。 | T-01でCAD開口・すき間寸法を記録し、T-13で対象年齢に適用するゲージと確認手順を特定する。全体凸包の内接球スクリーニングは指挟みの判定に使わない。適用規格・条項、判定値、現物結果は未確定・未実施。 |
| D-10 | 樹脂・顔料・添加物が口に触れる。材料の可燃性も使用条件に適合するか不明。 | 有害成分への曝露、燃焼時の火傷。S4 | 材料名だけで安全・難燃と見なさない。赤白の品番・ロット・資料を特定し、化学評価と可燃性の適用性を別に決める。CAD機能では対策できない。 | 計画ID: T-12、T-14。材料・色材資料、化学評価、燃焼性の適用性と試験機関報告は未確認。 |
| D-11 | 加熱・洗浄で変形、脆化、表面劣化が起きる。 | 破損片、表面損傷、使用不能。S2〜S4 | 熱源を内蔵しない。清掃で届かない閉空洞や細溝を避ける。熱・水・洗剤への適合は形状だけで主張しない。 | 予定する清掃方法・保管温度・試験条件は未決。計画ID: T-11。材料・色の品番とロットの特定はT-12の別ゲートとする。変形や劣化の現物評価は未実施。 |
| D-12 | 屋根・床の組立界面で指・皮膚が挟まる。 | 指の拘束、擦過傷。S3 | 案Bのv04 geometry-reportと最終再読込レポートでは物理形状が有効な閉じた1ソリッドと記録され、屋根・床の組立界面を設けない設計になっている。この確認範囲では組立時の挟み込み経路を設計上除去した。窓などに残る静的開口はD-09で扱う。支持材除去時の成人作業者のけがは[PFMEA P-09](pfmea.md)で扱う。 | 再読込の範囲外にある破損後の隙間は未確認。T-01/T-13は残る開口・すき間の確認であり、組立界面が存在する場合の合格を示さない。再改訂で界面ができた場合は設計を差し戻す。 |
| D-13 | 60 mm縮尺、色別出力、古いメッシュの取り違えで要求寸法や局所肉厚が外れる。 | 寸法不適合、薄肉化による破損。S2〜S4 | 全長、尺度、CAD・メッシュ・3MFの対応を改訂IDとハッシュで結ぶ。v03参照名は`MiniBody`、`MiniChassis`、`MiniRoof`、`SCALE`（60.0 / 160.2561472076974）と、幅候補スクリーンを参照する。 | 最終再読込レポート（ローカル保存）のNative CAD・STEP寸法は60.00000024 × 33.99999928 × 35.56793406 mmでA-03内。geometry-reportの全体STL寸法もA-03内。BRepのカーネル境界値は診断用で主寸法に使わない。スライス後3MFのハッシュはファイル検査レポート（ローカル保存）に、メッシュハッシュはメッシュレポート（ローカル保存）に記録されている。T-01のCAD寸法確認は完了、造形後寸法は未確認。過去のv03レポートをv04根拠に流用しない。 |
| D-14 | モデル形状や材料割当へサポート材が誤って含まれる。 | 材料片の脱落、口腔接触。S3〜S4 | モデル材と工程用サポート材を分け、`RedModel`と`WhiteModel`をモデル領域として扱い、工程用サポート材の割当とモデル形状を分ける。 | ファイル検査ではT0白PLA・T1赤PLAがモデル経路を持ち、T2 PLA-Sは支持界面・プライムタワーのみでモデル経路0と記録された。これはスライスファイルの割当検査で、サポート除去後の残材は未確認。計画ID: T-02。 |
| D-15 | 一体形状が積層方向や色切替で層間破断する。 | 大きな破片、鋭利部、小片の誤飲。S4 | 車輪、窓柱、屋根・床接続の向きと材料経路を設計レビューする。肉厚目標だけで層間強度を代替しない。 | v04姿勢・経路と局所断面を確認する。計画ID: T-03、T-04、T-05、T-06、T-07、T-08、T-09、T-15。落下・引張り・ねじり等の適用条件と現物結果は未確認。 |
| D-16 | 製品全体、または変形・破損後の本体部分が小部品円筒に収まる。 | 誤飲・窒息。S4 | A-03のCAD寸法範囲とA-04の凸包内接球スクリーニングを設計段階の寸法ゲートに使う。これらは円筒ゲージ判定や、変形・破損後の寸法確認を代替しない。 | 最終STLハッシュを照合した凸包スクリーンは33.399924 mmで、内部33.0 mm基準を通過した（結果（ローカル保存））。T-01のデジタル寸法・凸包スクリーンは記録済み。T-03で製品全体と試験後の全破片を小部品円筒で確認する必要がある。物理確認は未実施。 |

## 要求IDとの対応

| DFMEA ID | 関連する要求・内部基準 |
| --- | --- |
| D-01 | R-05、R-07、R-10 |
| D-02 | R-01、R-07、A-05 |
| D-03 | R-01、R-03、R-07、A-05 |
| D-04 | R-04、R-05、A-02 |
| D-05 | R-03、R-05、A-02 |
| D-06 | R-03、R-09、A-06 |
| D-07 | R-03、R-05、A-02 |
| D-08 | R-03、R-05、A-02 |
| D-09 | R-03、R-05、A-03、A-04 |
| D-10 | R-05、R-10 |
| D-11 | R-05、R-09、R-10 |
| D-12 | R-03、R-05、R-07 |
| D-13 | R-02、A-01、A-03、A-04 |
| D-14 | R-09 |
| D-15 | R-04、R-05、R-07、A-02、A-05 |
| D-16 | R-05、A-03、A-04 |

要求本文は[requirements.md](requirements.md)、計画項目とIDは[試験計画](test-plan.md)を参照する。対応IDは試験済みや合格を意味しない。
## 審査状態と未確認リスク

D-01〜D-16の対策は設計候補またはデジタル形状・スライス確認であり、物理的な有効性が実証された意味ではない。要求IDとの照合、CAD・メッシュ・ファイルのみのスライス確認は[試験計画](test-plan.md)と根拠レポートに記録する。表の計画IDは試験計画の確認項目を示し、物理試験を実施した結果や合格を示さない。基準条項番号や試験条件を推測で付けない。

CAD・メッシュ・ファイルのみのスライス確認を記録し、成人向け試作の設計審査を継続できる状態にした。プリンター送信は未許可で、印刷も物理試験もしていない。試験合格を示さず、子どもへの引き渡しは保留する。物理評価、材料評価、適用基準の確認、残留リスクの審査後に別途判断する。

## 設計根拠

v03の既存形状名は[v03ビルダー](../../../../../designs/school-bus-v03-mini/build_bus_v03.py)で確認できる。v03 CAD形状レポート（ローカル保存）は全長60.000 mm、片側すき間約0.300 mm、ガイド壁2.003 mmを記録する。屋根保持は未検証で、子どもの使用も未承認である。再読込レポート（ローカル保存）は3部品を報告しており、v04の構造根拠には使わない。

[v04ビルダー](../../../../../designs/school-bus-v04-dr/build_bus_v04.py)は`PhysicalBus`、四つの内部カラー、`RedModel`、`WhiteModel`を定義する。最終形状レポート（ローカル保存）と最終再読込レポート（ローカル保存）で、保存済みCADとSTEPの一体形状を確認した。最終凸包スクリーニング（ローカル保存）はA-04の内部デジタル基準を通過した。これは物理ゲージ、造形公差、変形、破損を評価しない。スライス検査（ローカル保存）はファイルのみで、プリンター送信を許可しない。代表断面レビュー（ローカル保存）は選択箇所の鉛直断面であり、全体の最小肉厚検査や強度解析ではない。nominal-section-review.json（ローカル保存）も指定断面の計算値に限られる。
