Sunwood-ai-labs/NEKOMO/docs/designs/school-bus-v04-dr/quality/preprint-review/pfmea.md

# v04ミニバスの工程FMEA

対象は全長60 mm級、赤白、一体の固定輪を持つバスの試作工程です。v03の位置決めだけの3部品構成から、一体構造への設計変更を前提とします。使用する形状と寸法はv04のCAD検査記録に従います。

この表は工程上の故障、影響、対策と検証の対応を記録します。発生率と検出能力の実測根拠がないため、O・D・RPNは付けません。対策を書いたことを、効果を確認したこととして扱いません。

| ID | 工程・故障モード | 影響 | 管理する対策 | 印刷前に確認する証拠 | 試作後の確認 |
| --- | --- | --- | --- | --- | --- |
| P-01 | 材料・色・ロットを取り違える | 材料性能と評価対象が一致しない | 予定カテゴリの白PLA・赤PLA・支持専用PLA-Sを分け、実製品・色材・ロットはT-12で確定して個体記録へ転記する | 材料読取記録、割当予定、T-12の記録欄 | 現物ラベル・ロットと供試品を対応づける。未確認なら使用判定を保留 |
| P-02 | モデル材と支持材のAMS割当を取り違える | 支持専用材が本体に入り、接着や強度が変わる | 3MF内の材料番号と実機スロットの対応表を作り、将来、造形が許可された場合の送信直前に別途照合する。現在は送信しない | 最終3MF検査、G-codeの材料別経路、材料割当予定 | T-02で残留・剥離を確認。予定を実際の割当実績と取り違えない |
| P-03 | 旧版またはスケール違いのファイルを使う | 寸法、部品構成、対策が変わる | v04の改訂名・寸法・ハッシュ・一体ソリッド数を照合する | 再読込CAD、STL検査、最終3MF検査、引き継ぎJSONの一致 | T-01と供試品の改訂確認。旧版の試験結果を流用しない |
| P-04 | ノズル、積層、壁数、充填や温度を変える | 薄い部分、層間や色境界の性能が変わる | スライサーとプロファイルを固定し、変更時は再スライス・再評価する | 最終ファイルに埋め込まれた設定とプロファイル | T-02、T-04〜T-10。設定変更品は別の試作条件として識別 |
| P-05 | 造形姿勢や支持材設定を取り違える | 支持不足、内部の残留、部位ごとの弱さが変わる | 採用姿勢を記録し、支持接触と開口へのアクセスをレビューする | 配置済み3MF、支持経路、姿勢を記録した工程票 | T-02で内部を含めて除去・検査。除去不能なら不合格として設計へ戻す |
| P-06 | 湿気、汚れ、保管状態の不一致 | 吐出の乱れ、空隙、接着のばらつき | 材料メーカーの条件に従い保管・乾燥の実績を記録する | 材料情報の参照先と乾燥・保管の記録様式 | T-02とT-04〜T-09の該当試験。読取表示だけで乾燥済みとは判定しない |
| P-07 | パージ不足、モデル内部への異材パージ | 色境界や支持材切替付近の接着が変わる | 異材パージのモデル内流用を無効にし、切替量を記録する | 3MF内のパージ設定、モデル経路の材料別解析 | T-02、T-04〜T-10。仮の切替量だけで材質純度や強度を保証しない |
| P-08 | 造形中に欠け、反り、未吐出や剥離が生じる | 弱い部分や鋭い欠損が残る | 供試品ごとに造形結果と異常を記録し、不良を合格品へ混ぜない | 個体記録票とT-01・T-02の判定欄 | 外観、寸法、負荷後の状態で判定。補修して試験済み品へ混ぜない |
| P-09 | 支持材除去で本体を削る、残留物を見落とす | 鋭い傷、残留片、局部の強度低下 | 除去前後の写真を残し、窓・座席間・屋根内側を照明と拡大で確認する | 内部支持のレビューとT-02の検査項目 | 残留、切削傷、緩い片があれば不合格。取り出せなければ形状・姿勢を再設計 |
| P-10 | 試験条件・測定器・試験品を取り違える | 合否の根拠が成立しない | 試験ごとに個体ID、改訂、材料、条件、器具、写真を記録する | T-00〜T-15の様式と試験順序、未使用試験品の割当 | 条件を満たさない実施は参考結果とし、所定試験の合格に数えない |
| P-11 | 清掃や熱で状態が変わる | 劣化、反り、汚れの残留や破片につながる | 清掃方法と使用限界を工程票に記録し、検証条件へ対応づける | T-11の清掃条件と材料情報の対応 | 清掃後にT-01・T-02と計画した負荷試験。条件未検証なら使用を保留 |
| P-12 | データ検査を現物試験・使用承認に読み替える | 未評価品を子どもに渡す | DR0〜DR4の判定、未実施試験、使用保留を別の状態で記録する | [DR判定記録](dr-review.md)、印刷未実施フラグ、子ども使用未承認フラグ | T-00〜T-15の結果と改訂の対応を確認するまでDR4を合格にしない |

## 工程の判定

印刷前に設定できる管理項目と確認方法を定義しました。乾燥、造形、後処理、試験の実施結果はありません。工程の再現性や製品安全性を実証した表ではありません。

関連する試験は[test-plan.md](test-plan.md)、設計側の故障は[dfmea.md](dfmea.md)を参照します。最終のデータ確認結果と条件付き判定はDR判定記録にまとめます。
