Sunwood-ai-labs/NEKOMO/(commit log)

2026-11-10 🚌 Publish NEKOMO bus designs and review snapshot
    - Archive versioned FreeCAD models, printable artifacts, and design sources.
    - Separate human feedback, agent DR stages, and two printed variants.
    - Exclude local runtime data and verify snapshot integrity.
    [Body-inverted.stl, FastRed.stl, FastWhite.stl, RedBodyAndTires-inverted.stl, RoofAndWheels-inverted.stl, WhiteRoof-inverted.stl, bus-two-colour-final.3mf, bus-v04-red.stl]
2026-11-10 🚌 Add project-specific NEKOMO design review skill
    - Define evidence-based methods for DR0 through DR4.
    - Separate home observations, equipment tests, and use decisions.
    - Add review records and refresh snapshot integrity metadata.
2026-11-10 🛠️ Document and automate NEKOMO snapshot verification
    - Document local checks and a repeatable v08-to-v09 toolpath comparison.
    - Publish the support-material preflight and check archived pass and block cases.
    - Verify manifest coverage and snapshot integrity in GitHub Actions.
2026-11-10 📄 License NEKOMO CAD and code under MIT
    - Add the MIT license text.
    - Document its scope for project-authored CAD and code.
    - Update the published snapshot manifest.
2026-11-11 🚌 Expand README with CAD galleries and design history
    - Show seven archived model views with structural design notes.
    - Link versioned CAD, sliced files, engineering reviews, and reproduction steps.
    - Preserve print evidence and known review limitations.
2026-11-12 🎨 Refresh NEKONEKO INDUSTRIES identity and README
    - Introduce the company name and preserve NEKOMO as the product brand
    - Publish five distinct logo concepts with prompts and a comparison guide
    - Retain CAD galleries and evidence links, and update repository URLs
2026-11-12 🎨 Add five Wonder to Go mission logo concepts
    - Reflect the agreed Japanese and English mission in the README
    - Explore portable joy through five distinct visual directions
    - Preserve the first five proposals and record generation prompts
2026-11-12 🎨 Explore five logos that visualize Wonder to Go
    - Express wonder through motion, flight, tickets, maps and typography
    - Add five original PNG proposals with generation prompts
    - Preserve previous concepts and refresh the comparison links
2026-11-12 🚗 Add five land sea and air logo comparisons
    - Make cars, boats and airplanes visible in each new concept
    - Simplify the hybrid mark while retaining its original image
    - Update comparison pages and preserve earlier logo proposals
2026-11-12 ⛵ Add five sailboat-only logo concepts
    - Explore mast, sail and hull shapes without other vehicle elements
    - Align the company lockups and retain the original text versions
    - Refresh comparison pages while preserving earlier proposals
2026-11-12 🐈 Add five integrated cat and sailboat logo concepts
    - Combine ears, tails and silhouettes with sails and hulls
    - Record five original monochrome proposals and their prompts
    - Refresh comparison pages while preserving the earlier concepts
2026-11-12 🐈 Adopt cat captain logo and refresh brand documentation
    - Feature the selected logo and Wonder to Go mission
    - Record brand identity and preserve all concept history
    - Retain CAD galleries, artifacts and review evidence
2026-11-14 Unify current project naming under Nekoneko Industries
